vidittyagi118/Ganges_schematic_BOM/CLEANER FILES/SCHEMATICS/Mauricio/9a4c0546-6dc0-4282-add6-17016f0906af.jpg

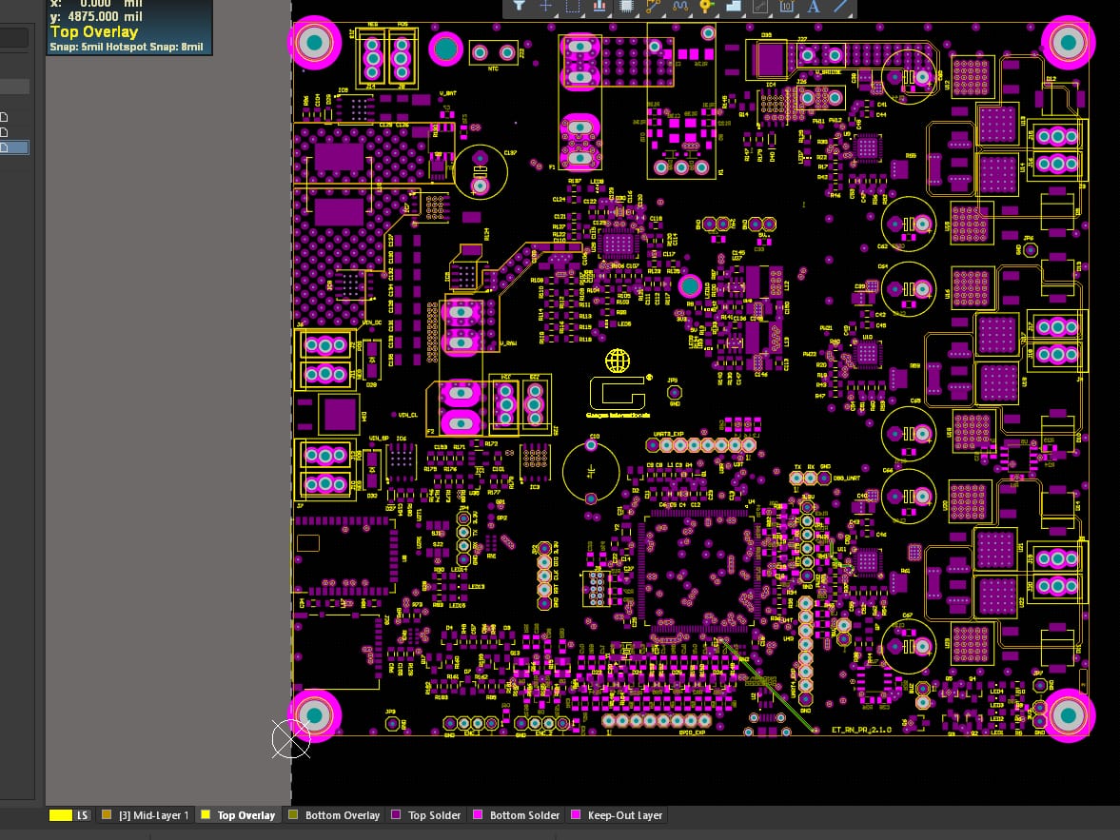
CLEANER FILES/SCHEMATICS/Mauricio/9a4c0546-6dc0-4282-add6-17016f0906af.jpg
