vidittyagi118/Ganges_schematic_BOM/CLEANER FILES/SCHEMATICS/Mauricio/b7af23a4-b5ae-4575-a90f-6ab39772d037.jpg

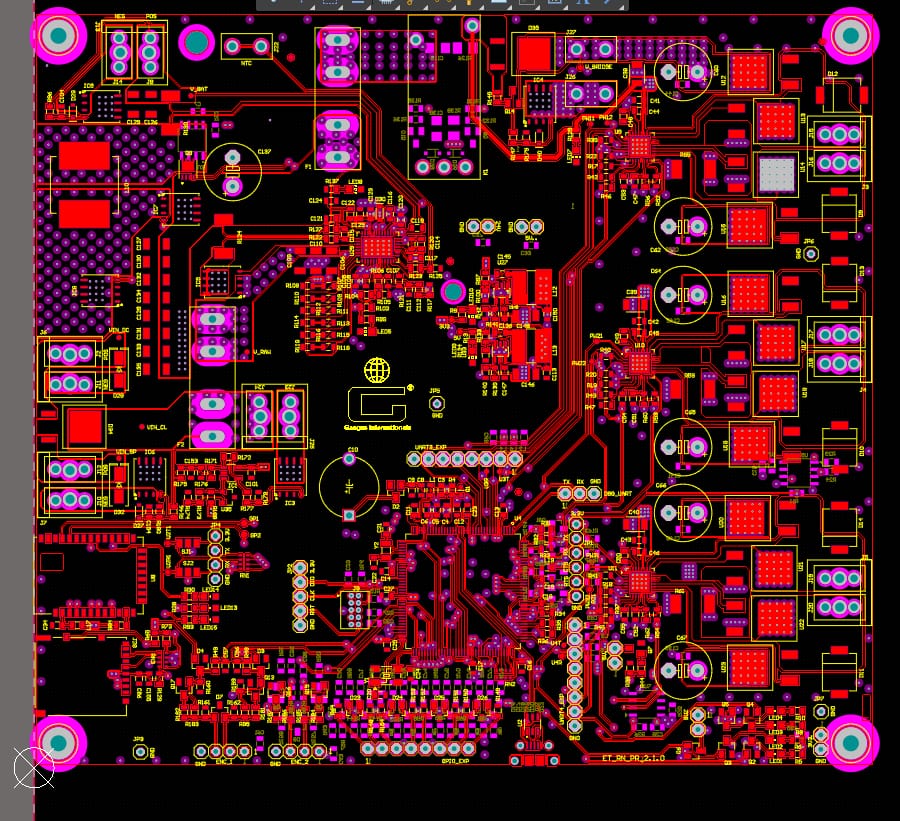
CLEANER FILES/SCHEMATICS/Mauricio/b7af23a4-b5ae-4575-a90f-6ab39772d037.jpg
