vidittyagi118/Ganges_schematic_BOM/HEX_08.06.2023 (1)/HEX_08.06.2023/README.txt

HEX_G3_TCSC_08.06.2023  ---Phase3 solar cleaner & track changer File
HEX_G3_TCSC_CNV_08.06.2023 ---Phase 3 cleaner to TC converted file
HEX_G4_SC_GMD_08.06.2023  ---Phase 4 Cleaner Green motor driver file
HEX_G4_SC_RMD_08.06.2023  ---Phase 4 Cleaner red motor driver file
HEX_G4_TC_08.06.2023      Phase 4 track changer file
