vidittyagi118/Ganges_schematic_BOM/child board/Dashboard.pdf

Distance

3

2

1

0

## RBT 1

## RBT 6

## RBT 8

## RBT 5

RBT 2 | RBT 3

## RBT 7

## RBT 4

## RBT 9

## Admin Dashboard

RTC Time | Actual time

Tingri

Dhule

Site Name

Site Name

Motor Current
LT Motor 1
LT Motor 2
Brush Motor
Current Running at | Min value | Max Value

## Number of RBT Run

14 Successfully Run | 6 remaining

RBT 1 | 67%
RTC Time | Actual time

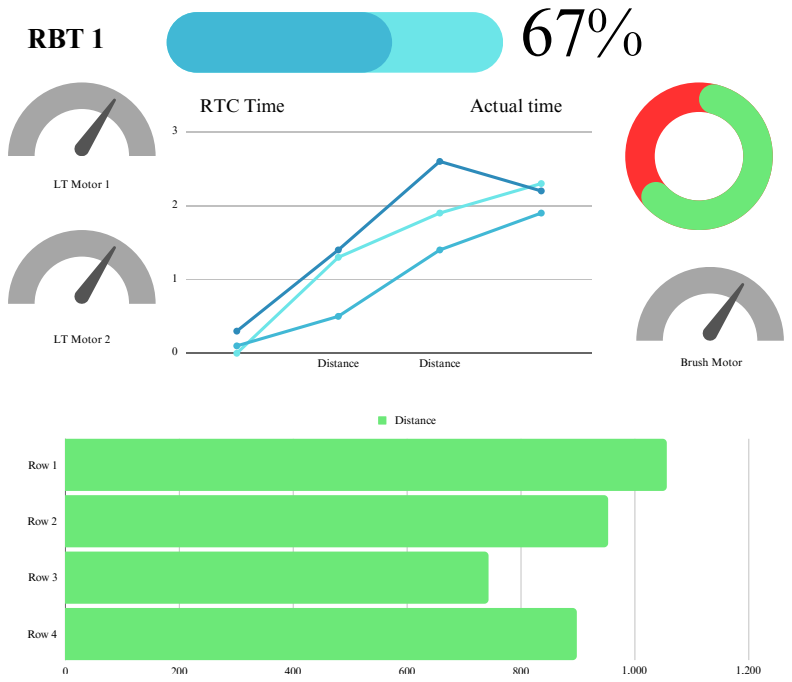
[picture p3: page 2]
LT Motor 1; LT Motor 2; Brush Motor; Distance; Row 1; Row 2; Row 3; Row 4

Mobile View

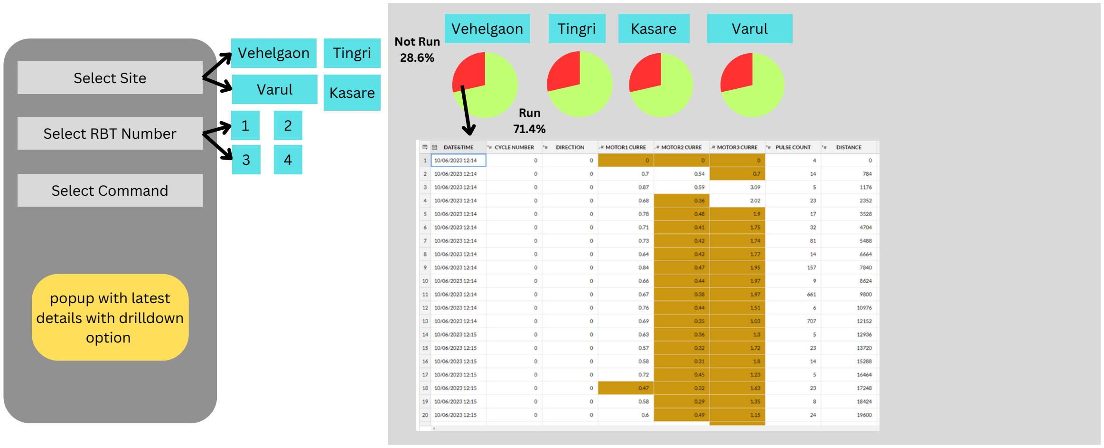
[picture p4: figure]
Select Site; Varul; Tingri; Kasare; Vehelgaon; Select RBT Number; Select Command; popup with latest details with drilldown option; Run 71.4%; Not Run 28.6%
