vidittyagi118/Ganges_schematic_BOM/Motor driver and current sensor - connections (1).pdf

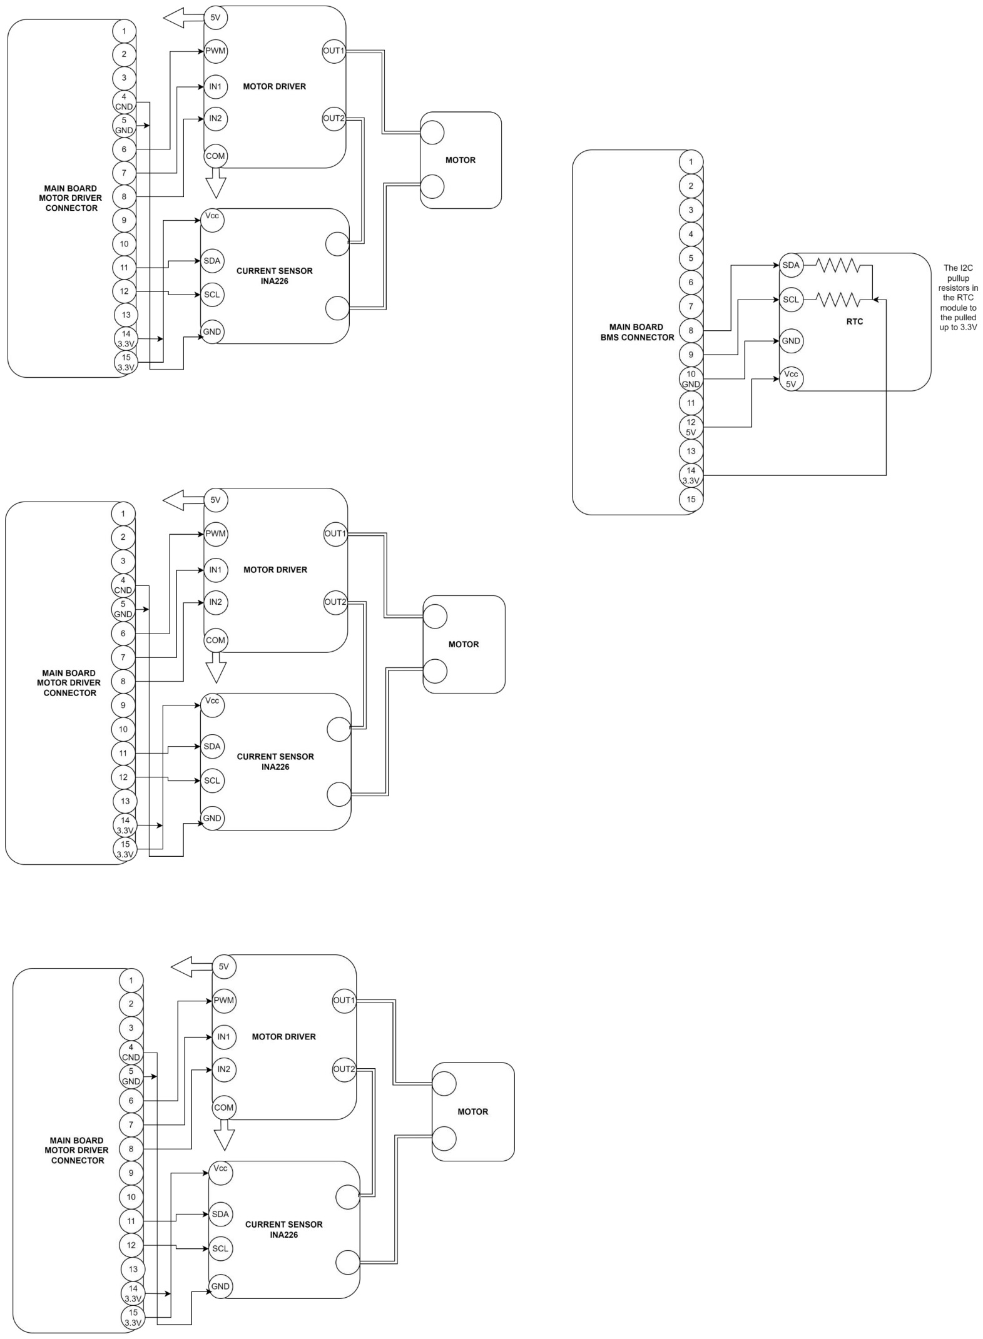
[picture p33: page 1]
