vidittyagi118/Ganges_schematic_BOM/pi.pdf

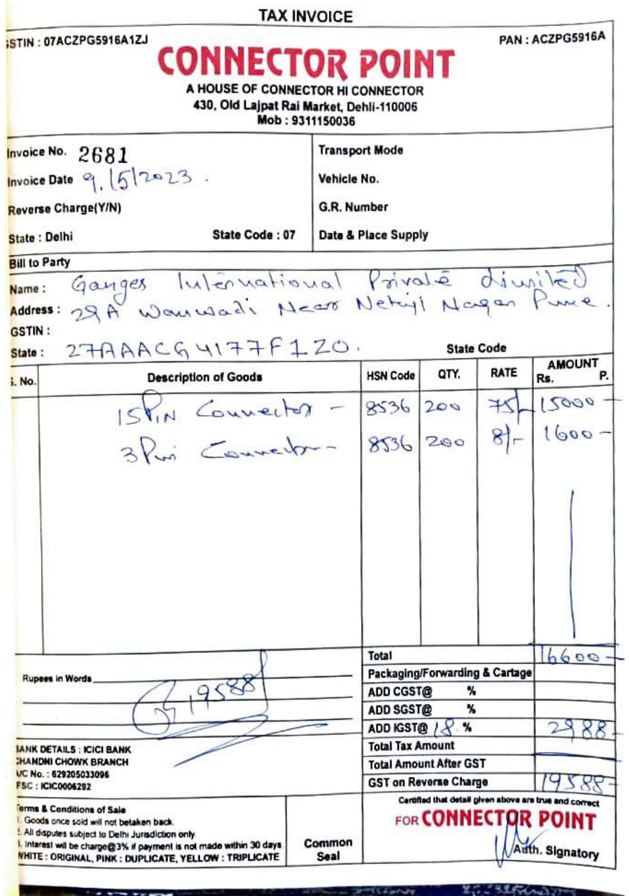
[picture p34: page 1]
