vidittyagi118/Ganges_schematic_BOM/CLEANER FILES/SCHEMATICS/Mauricio/39d270a1-28ed-41b4-96c7-10a538070abb.jpg

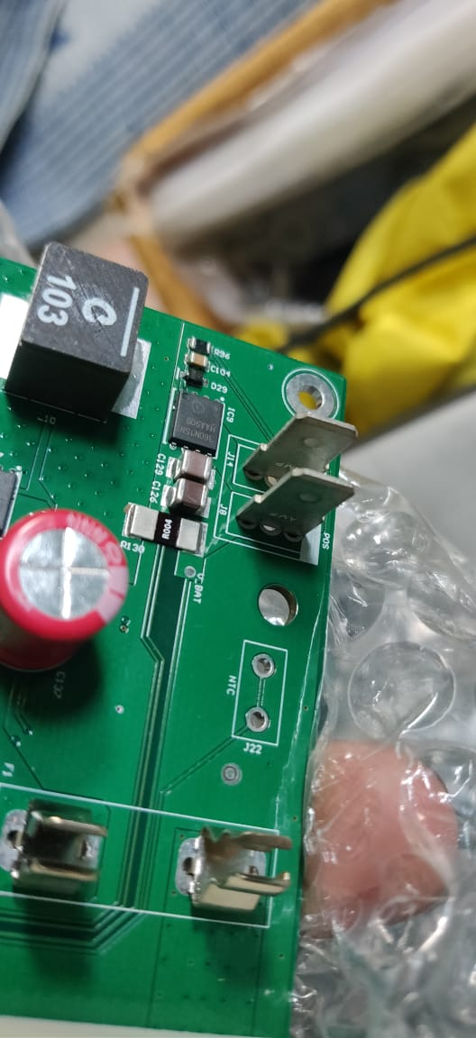
CLEANER FILES/SCHEMATICS/Mauricio/39d270a1-28ed-41b4-96c7-10a538070abb.jpg
