vidittyagi118/Ganges_schematic_BOM/CLEANER FILES/SCHEMATICS/Mauricio/929b0294-b892-416f-9735-e577233a44dc.jpg

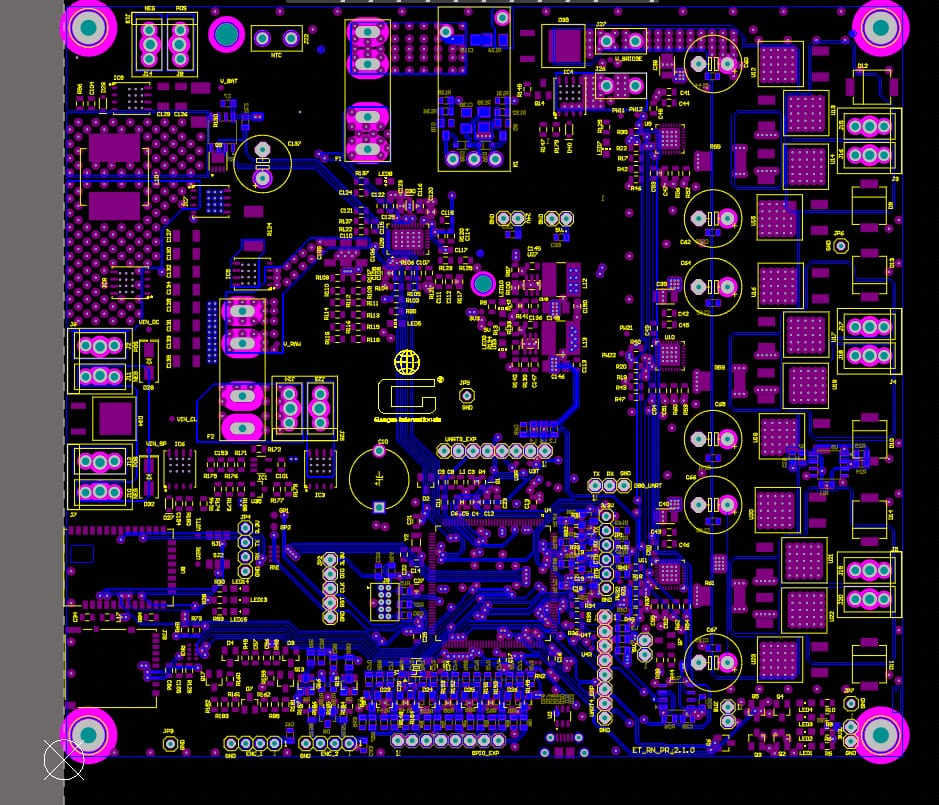
CLEANER FILES/SCHEMATICS/Mauricio/929b0294-b892-416f-9735-e577233a44dc.jpg
