vidittyagi118/Ganges_schematic_BOM/CLEANER FILES/SCHEMATICS/Mauricio/6096d0ab-282d-4cd0-bb16-c4c4bb90c3ef.jpg

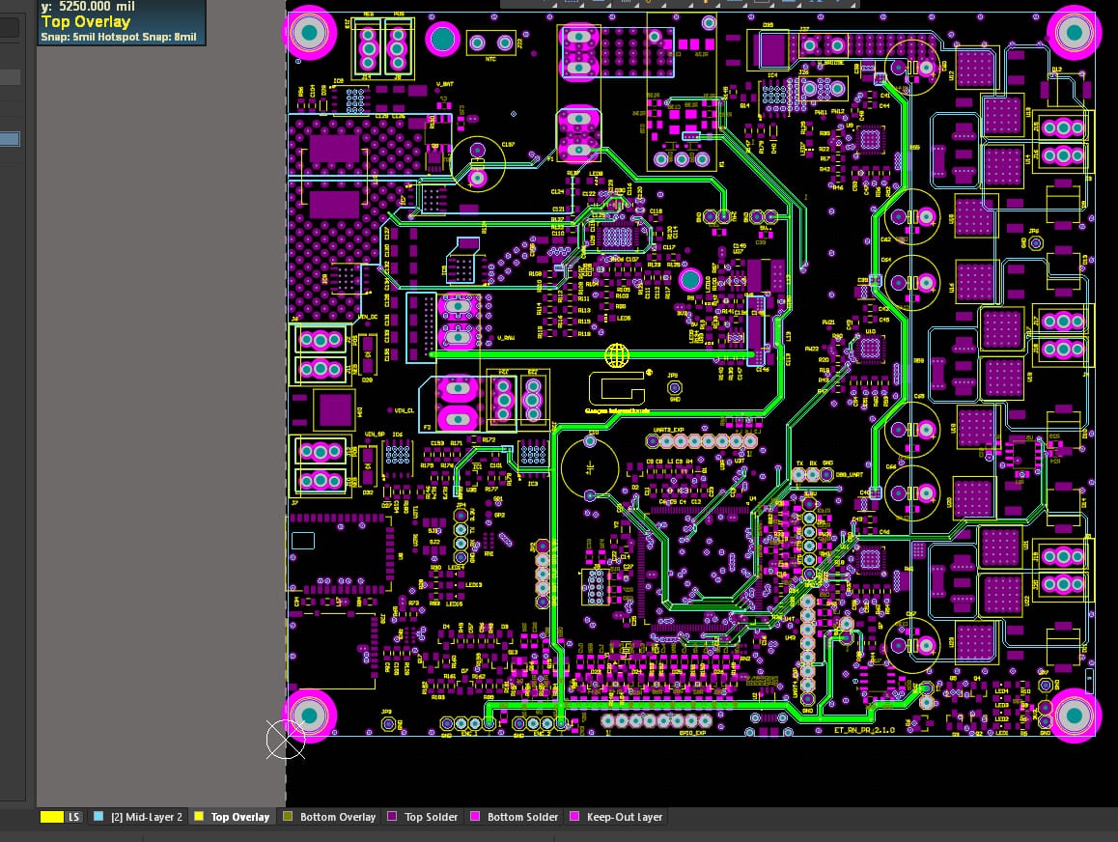
CLEANER FILES/SCHEMATICS/Mauricio/6096d0ab-282d-4cd0-bb16-c4c4bb90c3ef.jpg
