vidittyagi118/Ganges_schematic_BOM/CLEANER FILES/SCHEMATICS/Mauricio/92120a25-4651-43e5-99e7-13c493c2579b.jpg

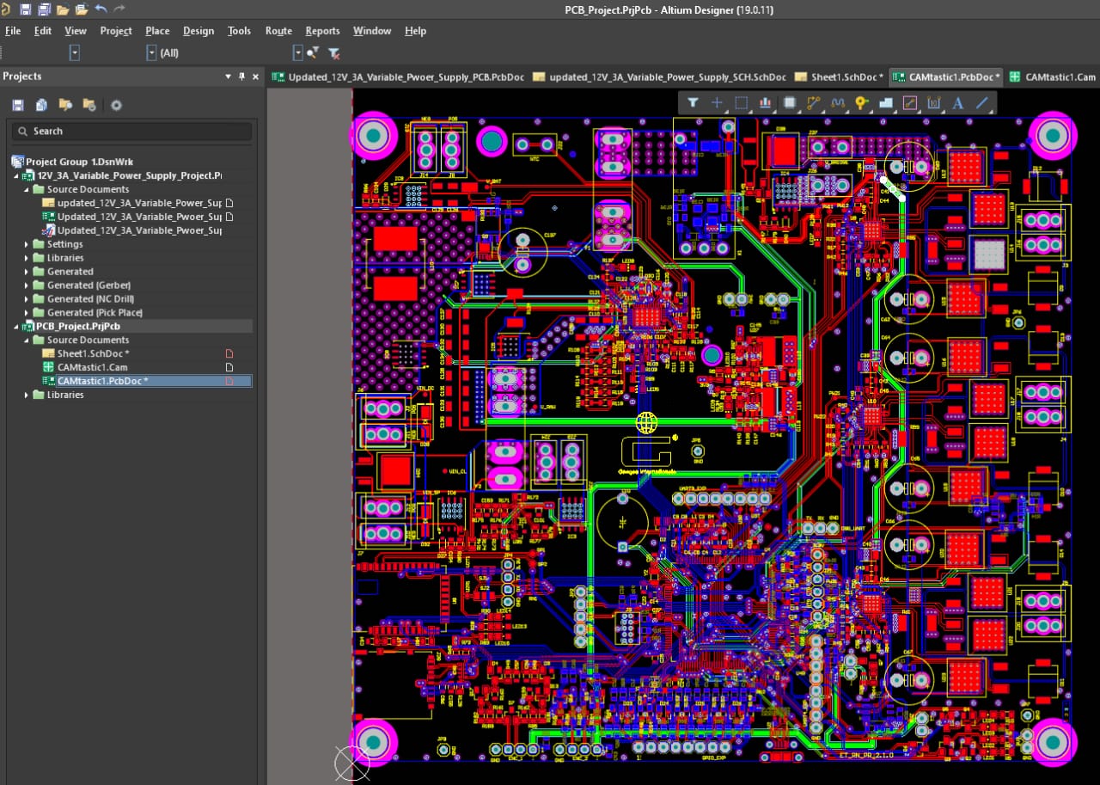
CLEANER FILES/SCHEMATICS/Mauricio/92120a25-4651-43e5-99e7-13c493c2579b.jpg
