vidittyagi118/Ganges_schematic_BOM/WhatsApp Image 2023-09-27 at 11.44.15 AM.jpeg

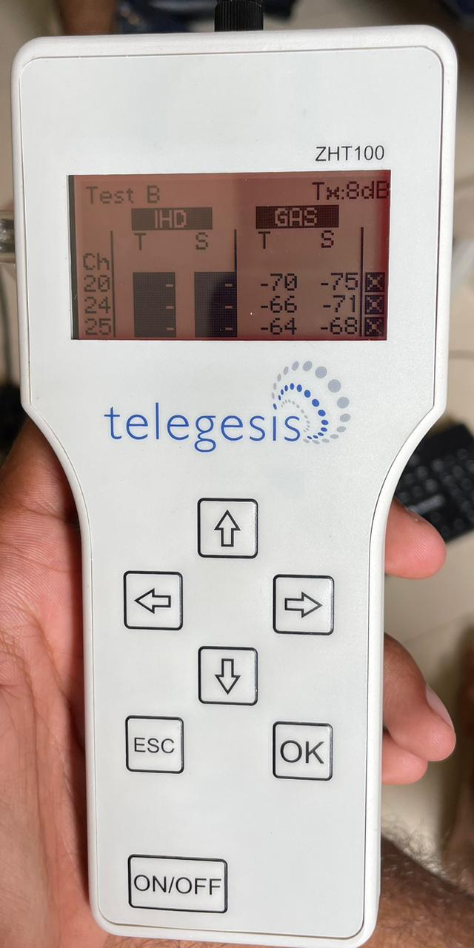
WhatsApp Image 2023-09-27 at 11.44.15 AM.jpeg
