vidittyagi118/Ganges_schematic_BOM/BOM_GANGES 2 POWER SECTION_2023-07-04.csv

ID | Name | Designator | Footprint | Quantity | Manufacturer Part | Manufacturer | Supplier | Supplier Part | Price
1 | 470pF | C1 | C0805 | 1 | C2012C0G1H471JT000N | TDK | LCSC | C76630 | 0.027
2 | 100uF | C2 | CAP-SMD_BD6.3-L6.6-W6.6-LS7.4-FD | 1 | XT100UF16V90RV0061 | KNSCHA(科尼盛) | LCSC | C2992593 | 0.036
3 | 220uF | C3 | CAP-SMD_BD6.3-L6.6-W6.6-FD-2 | 1 | RX220UF16V90RV0106 | KNSCHA(科尼盛) | LCSC | C3445239 | 0.078
4 | 10uF | C4,C5 | CASE-A_3216 | 2 | CA45B-A-16V-10uF-K | CEC(振华新云) | LCSC | C136813 | 0.058
5 | 22uH | L1 | IND-SMD_L4.0-W4.0_LQH44PN2R2MP0L | 1 | SMNR4020-22UH | SXN(顺翔诺) | LCSC | C135264 | 0.067
6 | LED-Red(0805) | LED2 | LED-0805 | 1 | 17-21SURC/S530-A2/TR8 | Everlight Elec | LCSC | C131244 | 0.02
7 | 1N5819/S | NO1 | SMA_L4.3-W2.6-LS5.2-R-RD | 1 | 1N5819/S |  | LCSC | C9900003833
8 | 2K | R1 | R0805 | 1 | RC0805JR-072KL | YAGEO(国巨) | LCSC | C114748 | 0.002
9 | 6.8kΩ | R2 | R0805 | 1 | RMC08056.8K5%N | Tyohm(幸亚电阻) | LCSC | C325848 | 0.004
10 | 300mΩ | R3 | RES-SMD_L6.4-W3.2 | 1 | WW25WR300JTL | Walsin(华新科) | LCSC | C172339 | 0.044
11 | 10k | R9 | AXIAL-0.3 | 1 | ?
12 | MC34063A | U3 | SOIC-8_L4.9-W3.9-P1.27-LS6.0-BL | 1 | MC34063A | Slkor(萨科微) | LCSC | C5330394 | 0.113
13 | AMS1117-3.3_C2992570 | U4 | SOT-223-3_L6.4-W3.5-P2.30-LS7.0-BR | 1 | AMS1117-3.3 | 国芯佳品 | LCSC | C2992570 | 0.041
