vidittyagi118/Ganges_schematic_BOM/BOM_Ganges PCB design_2023-07-04.csv

ID | Name | Designator | Footprint | Quantity | Manufacturer Part | Manufacturer | Supplier | Supplier Part | Price
1 | 0.1uF/16V | C1 | C0603 | 1
2 | 0.1uF | C2 | C0603 | 1
3 | 2.2uF | C3,C9 | C0603 | 2
4 | 10uF | C4,C5 | CASE-A_3216 | 2 | CA45B-A-16V-10uF-K | CEC(振华新云) | LCSC | C136813 | 0.058
5 | 100uF | C6,C7 | CASE-A_3216 | 2
6 | 10nF/16V | C8,C13 | C0603 | 2
7 | 10uF | C10 | C0603 | 1
8 | 47uF | C11,C12 | C0603 | 2
9 | B370-13-F | D1 | SMC_L6.9-W5.9-LS7.9-RD | 1 | B370-13-F | DIODES | LCSC | C134456 | 0.364
10 | B340B-13-F | D2 | SMB_L4.6-W3.6-LS5.3-RD | 1 | B340B-13-F | DIODES | LCSC | C85099 | 0.095
11 | MF-RX110 | F1 | FUSE-TH_L13.5-W3.0-P5.08-D1.0-S1.2 | 1 | MF-RX110 | BOURNS | LCSC | C208495 | 0.311
12 | 8.2uH | L1 | IND-SMD_L7.3-W6.8_ASPI-7318 | 1 | ASPI-7318-8R2M-T | Abracon LLC | LCSC | C187372 | 0.996
13 | LED-0603_R | LED1 | LED0603_RED | 1 | 19-217/R6C-AL1M2VY/3T | EVERLIGHT(台湾亿光) | LCSC | C72044 | 0.016
14 | LED-Red(0805) | LED2 | LED-0805 | 1 | 17-21SURC/S530-A2/TR8 | Everlight Elec | LCSC | C131244 | 0.02
15 | 49K9 | R1 | R0603 | 1
16 | 100K | R2 | R0603 | 1
17 | 17K8 | R3 | R0603 | 1
18 | 3K3 | R4 | R0603 | 1
19 | 10k | R9 | AXIAL-0.3 | 1 | ?
20 | 0 | U1,U5 | TEST-RING | 2 | 1625854-2 | TE Connectivity(美国泰科) | LCSC | C306063 | 0.252
21 | POGO_Pin | U2,U6,U10 | HDR-TH_2P-P2.54-V-M | 3 | 54102-T30-00 | Amphenol | LCSC | C213462 | 0.019
22 | LDP01-35AY | U3 | D2PAK_L10.2-W9.0-P5.08-LS16.9-BR | 1 | LDP01-39AY | ST(意法半导体) | LCSC | C1973035 | 4.83
23 | AMS1117-3.3_C2992570 | U4 | SOT-223-3_L6.4-W3.5-P2.30-LS7.0-BR | 1 | AMS1117-3.3 | 国芯佳品 | LCSC | C2992570 | 0.041
24 | DS3231M+ | U7 | SOIC-16_L10.3-W7.5-P1.27-LS10.3-BL | 1 | DS3231M+ | ADI(亚德诺)/MAXIM(美信) | LCSC | C1520508 | 3.514
25 | AT24C32AN-10SI-1.8 | U8,U9 | SOP-8_L4.9-W3.9-P1.27-LS6.0-BL-1 | 2 | AT24C32AN-10SI-1.8 | null | LCSC | C3202935
