vidittyagi118/Ganges_schematic_BOM/GANG-TRACK CHANGER_BOM_ 20.7.2020.xlsx

Sheet: Sheet2
Qty | Value | Package | Parts | Description | Manufacturer | Manufacturer Part Number
1 | Manual Switch | 1X02 | JP10 | PIN HEADER | Connfly | DS1070-2MVV6
1 | RFID | 1X06 | JP5 | PIN HEADER | Connfly | DS1070-4MVV6
14 | 0.001uF | 0805 | C56, C57, C58, C59, C70, C71, C72, C73, C74, C75, C76, C77, C115, C118 | MLCC, 0805, 50V, 10% | AVX | 08055C102KAT4A
4 | 0.01uF/50V | 0805 | C104, C7, C8, C111 | MLCC, 0805, 50V, 10% | AVX | 08055C103KAT2A
40 | 0.1uF / 50V | 0805 | C4, C5, C6, C38, C39, C45, C46, C1, C2, C9, C15, C40, C42, C48, C101, C136, C145, C147, C149, C153, C11, C12, C13, C16, C17, C18, C19, C23, C25, C27, C29, C30, C37, C50, C61, C63, C108, C114, C123, C124 | MLCC, 0805, 50V, 10% | Walsin | 0805B104K500CT
1 | 0.22uF/50V | 0805 | C112 | MLCC, 0805, 50V, 10% | Taiyo Yuden | UMK212B7224KG-T
2 | 0.33uF/50V | 0805 | C122, C117 | MLCC, 0805, 50V, 20% | Vishay | VJ0805V334MXACW1BC
3 | 0.47uF | 0805 | C83, C88, C116 | MLCC, 0805, 50V, 20% | Yageo | CC0805ZRY5V9BB474
6 | 0R | 0805 | R108, R109, R112, R119, R122, R127 | Thick Film Resistor, 0805, 1% | Yageo | RC0805FR-070RL
4 | 100K | 0805 | R178, R20, R139, R141 | Thick Film Resistor, 0805, 1% | Vishay | CRCW0805100KFKEA
14 | 100R | 0805 | R48, R49, R50, R51, R58, R66, R67, R68, R69, R70, R71, R72, R164, R166 | Thick Film Resistor, 0805, 1% | Walsin | WR08X1000FTL
1 | 100pF/50V | 0805 | C107 | MLCC, 0805, 50V, 5% | Vishay | VJ0805A101JXAAC
10 | 10K | 0805 | R37, R39, R40, R15, R16, R19, R27, R106, R123, R125 | Thick Film Resistor, 0805, 1% | Yageo | RC0805FR-0710KL
2 | 10M | 0805 | R96, R146 | Thick Film Resistor, 0805, 1% | Yageo | RC0805FR-0710ML
7 | 10uF / 16V | 0805 | C43, C47, C49, C105, C125, C14, C34 | MLCC, 0805, 16V, 10% | Taiyo Yuden | EMK212ABJ106KG-T
17 | 10uF / 50V | 1210 | C41, C106, C109, C110, C126, C127, C128, C129, C130, C131, C132, C133, C134, C135, C146, C148, C44 | MLCC, 1210, 50V, 10% | Murata | GRM32ER71H106KA12L
1 | 110K | 0805 | R18 | Thick Film Resistor, 0805, 1% | Yageo | RC0805FR-07110KL
1 | 120uF/50V | E5-10,5 | C137 | Aluminium Electrolytic Capacitor, 50V | Wurth | 860020675017
2 | 12pF | 0805 | C21, C22 | MLCC, 0805, 50V, 5% | Walsin | 0805N120J500CT
2 | 15V | SOD-323 | D27, D29 | Zener Diode, 15V, 300mW | Nexperia | BZX384-B15,115
2 | 18pF | 0805 | C20, C24 | MLCC, 0805, 50V, 5% | Walsin | 0805N180J500CT
28 | 1K | 0805 | R5, R6, R7, R8, R10, R11, R21, R22, R28, R30, R57, R74, R75, R76, R79, R80, R83, R95, R155, R156, R163, R165, R171, R177, R183, R9, R13, R17 | Thick Film Resistor, 0805, 1% | Yageo | RC0805FR-071KL
1 | 1N4148 | SOD-323 | D30 | Diode, 150mA, 100V | Diodes Inc. | 1N4148WS-7-F
1 | 1uF/50V | 0805 | C121 | MLCC, 0805, 50V, 10% | AVX | 08055C105KAT2A
1 | 2.2M | 0805 | R180 | Thick Film Resistor, 0805, 1% | Panasonic | ERJ-6ENF2204V
2 | 2.2uF/25V | 0805 | C154, C120 | MLCC, 0805, 50V, 10% | Murata | GRM219R61H225ME15D
1 | 200R | 0805 | R117 | Thick Film Resistor, 0805, 1% | Yageo | RC0805FR-07200RL
2 | 22.1K | 0805 | R100, R134 | Thick Film Resistor, 0805, 1% | Yageo | RC0805FR-0722K1L
1 | 226K | 0805 | R103 | Thick Film Resistor, 0805, 1% | Yageo | RC0805FR-07226KL
2 | 22uF | 0805 | C113, C150 | MLCC, 0805, 6.3V, 20% | CCTC | TCC0805X5R226M6R3FT
1 | 301K/0.1% | 0805 | R120 | Thick Film Resistor, 0805, 0.1% | Yageo | AT0805BRD07301KL
1 | 32.768KHz | CRYSTAL-32768_TF32 | Y2 | Crystal, 32.768 KHz | Epson | Q13FC1350000400
2 | 33K | 0805 | R99, R137 | Thick Film Resistor, 1206, 1% | Yageo | RC0805FR-0733KL
7 | 4.7K | 0805 | R12, R23, R24, R34, R35, R36, R176 | Thick Film Resistor, 0805, 1% | Vishay | CRCW08054K70FKEAC
1 | 43K | 0805 | R175 | Thick Film Resistor, 0805, 1% | Yageo | RC0805JR-0743KL
2 | 470R | 0805 | R161, R162 | Thick Film Resistor, 0805, 1% | Vishay | CRCW0805470RFKEAC
2 | 47E | 0805 | R184, R187 | Thick Film Resistor, 0805, 1% | Yageo | RC0805FR-0747RL
2 | 47R | 0603-ARV | RN1, RN3 | Resistor Array, 5% | Yageo | TC164-JR-0747RL
2 | 4mOhms | ERJMP4 | R124, R130 | Current Sense Resistor, 2W, 1% | Yageo | PA2512FKF7W0R004E
1 | 51K | 0805 | R97 | Thick Film Resistor, 0805, 1% | Yageo | RC0805FR-0751KL
11 | 62409-1 | TE_62409-1 | J2, J4, J5, J8, J10, J11, J12, J14, J22, J23, J24 | Faston Connectors | TE Connectivity | 62409-1
2 | 64.9K | 0805 | R104, R105 | Thick Film Resistor, 0805, 1% | Yageo | RC0805FR-0764K9L
2 | 88.7K | 0805 | R172, R133 | Thick Film Resistor, 0805, 1% | Yageo | RC0805FR-0788K7
1 | 8MHz | 5mmx3.2mm | Y1 | Crystal, 8MHz | Abracon | ABM3B-8.000MHZ-B2-T
1 | 95.3K | 0805 | R121 | Thick Film Resistor, 0805, 1% | Yageo | RC0805FR-0795K3L
1 | BAS40 | SOT23 | D2 | Schottky Diode, 40V, 0.12A | Infineon | BAS4004E6327HTSA1
14 | BAT54S | SOT23 | D3, D4, D5, D6, D15, D16, D17, D18, D19, D20, D21, D22, D31, D33 | Schottky Diode, 30V | Nexperia | BAT54S,215
1 | Drive Enable | 1X02 | BUZ1 | PIN HEADER | Connfly | DS1070-2MVV6
1 | EEC-S0HD224HN | RG_105X50_V | C10 | Super Capacitor | Panasonic | EEC-RG0V224H
1 | Encoder | 1X04 | ENC_1 | PIN HEADER | Connfly | DS1070-4MVV6
4 | FB | 0805 | L17, L1, L19, L20 | Ferrite Bead | TAIYO Yuden | BK2125HS601-T
1 | FUSE_CLIP | FUSE_CLIP | F2 | Fuse clip | Xucheng Elec | C3130
6 | JMTK50N06A | TO-252-3 | U28, U30, U25, U26, U31, U32 | N-Channel FET | Jie Jie Micro | JMTK50N06A
1 | JTAG-10PIN | JTAG | J9 | JTAG | Samtec | FTSH-105-01-F-D-K
1 | LMV321A | SOT23-5 | IC1 | OP-AMP | Texas Instruments | LMV321IDBVR
1 | LP2980-N / EQU | TSOP-5 | U11 | fixed-output voltage regulator | Texas Instruments | LP2980-N
1 | LTC4015EUHFPBF | QFN-38_UHF | U29 | Battery charge controller | Linear Technology | LTC4015EUHF#PBF
1 | Limit Switch | 1X03 | JP6 | PIN HEADER | Connfly | DS1070-3MVV6
1 | MBRD20100CT | DPAK-3 | D34 | Schottky Diode, 100V, 10A | Diodes Inc. | MBRD20100CT-13
1 | MF-MSMF110/16 | 1812 | F1 | PTC Fuse | BOURNS | MF-MSMF110/16
1 | MK22FN1M0AVLQ12 | 144-LQFP | U4 | Micro Controller | NXP | MK22FN1M0AVLQ12
10 | PDTC114 | SC59-BEC | Q2, Q3, Q4, Q5, Q8, Q15, Q16 | NPN Transistor | Nexperia | PDTC114,ET
1 | Proximity | 1X04 | JP8 | PIN HEADER | Connfly | DS1070-4MVV6
13 | RED | 0805 | LED1, LED2, LED3, LED4, LED13, LED14, LED15, LED7, LED5, LED6, LED8, LED9, LED10 | LED | Everlight | 17-21SURC/S530-A2/TR8
1 | SQD40131EL_GE3 | TO-252-3 | Q9 | P-Channel FET, 40V, 50A | Vishay | SQD40131EL_GE3
3 | SRN6045-150M | SRN6045 | L12, L13, L18 | Fixed Inductors, 15uH, 20% | BOURNS | SRN6045-150M
1 | SRP1265A-100M | SRP1265A | L10 | Fixed Inductors, 10uH, 20% | Bourns | XAL1010-103MEB
1 | SSB44HE3_A/I | SMB | D11 | Reverse diode | Vishay | SSB44HE3_A/I
1 | ST-TF-003A | SUNTECH_ST-TF-003A | P1 | Micro SD Card Socket | Suntech | ST-TF-003A
1 | Stepper Motor | 1X03 | JP7 | PIN HEADER | Connfly | DS1070-3MVV6
1 | 33K | 0805 | R42 | Resistor
1 | 88.7K |  | R43 | Resistor
1 | TL431ACDBZR | SOT23-3 | U5 | TL431- Voltage Reference | Texas Instruments | TL431ACDBZR
1 | TMP75AIDR | SOIC | U3 | Temperature Sensor | Texas Instruments | TMP75AIDR
3 | TPS560430X | SOT23-6 | U10, U27, U33 | DC-DC Converter | Texas Instruments | TPS560430XFDBVT
1 | TRS3232_TSSOP | TSSOP-PW16 | U9 | RS232 Transceiver | Texas Instruments | TRS3232CDWR
1 | Debug UART | 1X03 | DBG_UART | PIN HEADER | Connfly | DS1070-3MVV6
1 | Proximity Power | 1X02 | 24V | PIN HEADER | Connfly | DS1070-2MVV6
1 | XB3-24Z8UM | XCVR_XB3-24Z8UM-J | U8 | XBee3, 2.4 GHz ZB 3.0, U.FL Ant, MMT | Digi | XB3-24Z8UM
1 | Zigbee Stick | 1X04 | JP12 | PIN HEADER | Connfly | DS1070-4MVV6

Sheet: Sheet3
qty | Location | Part No | Description | Remarks
2 | R58,R57 |  | Resistance | Remove from R160 & R159 (same location)
2 | R37,R39 |  | Resistance | Remove from TC board R163 & R165 & solder it in this
