vidittyagi118/Ganges_schematic_BOM/Gerber_NC files for MCU Module V1.1/MCU module BOM.xls

PCBWay Bom Quotation, Product No.:T-1D10W424020A
Item # | *Designator | *Qty | Manufacturer | *Mfg Part # | Description / Value | Vendor Part # | *Package/Footprint | Mounting Type | *Unit Price(50 sets) | *Total | *Delivery Time | *Actual Purchase Mfg Part # | *PCBWay Note | Customer Reply | PCBWay Update
1 | C201 | 1 | Samsung | CL21A106KPFNNNG | CAP CER 10UF 6.3V X5R 0805 | Digi-Key『 』1276-6456-2-ND | 0805 (2012 Metric) | Surface Mount, MLCC | $0.108 | $5.400 |  |  | 10V
2 | C202, C203, C205, C206, C209, C211, C213, C214, C215 | 9 | Samsung | CL21B104KBCNNNC | CAP CER 0.1UF 50V X7R 0805 | Digi-Key『 』1276-1003-1-ND | 0805 (2012 Metric) | Surface Mount, MLCC | $0.004 | $1.800
3 | C204 | 1 | Samsung | CL21A475KQFNNNE | CAP CER 4.7UF 10V X5R 0805 | Digi-Key『 』1276-1198-1-ND | 0805 (2012 Metric) | Surface Mount, MLCC | $0.121 | $6.050 |  |  | 6.3V
4 | C207 | 1 | Kyocera AVX | TAJA225K010TNJ | Capacitor Tantalum 10V 2.2uF 10% ESR = 6 ohm | Digi-Key『 』478-11226-1-ND | 1206 (3216 Metric) | Surface Mount | $0.302 | $15.100
5 | C212 | 1 | Wurth Electronics | 885012007076 | CAP CER 10PF 100V C0G/NP0 0805 | Digi-Key『 』732-12223-1-ND | 0805 (2012 Metric) | Surface Mount, MLCC | $0.118 | $5.900
6 | C216, C217, C218, C220 | 4 | Stackpole Electronics | CML0805C0G120JT50V | CAP CER 12PF 50V C0G/NP0 0805 | Digi-Key『 』738-CML0805C0G120JT50VCT-ND | 0805 (2012 Metric) | Surface Mount, MLCC | $0.060 | $12.000
7 | C219 | 1 | Wurth Electronics | 885012207092 | CAP CER 10000PF 50V X7R 0805 | Digi-Key『 』732-8021-1-ND | 0805 (2012 Metric) | Surface Mount, MLCC | $0.118 | $5.900
8 | J200, J201, J202, J203 | 4 | TE Connectivity AMP | 1-2842138-0 | 20P,2MM,BRK HDR,DRVT,2.8,0.1AU,B | Digi-Key『 』17-1-2842138-0-ND |  | Through Hole |  |  |  |  | [DNP不要贴];
9 | J200, J201, J202, J203 | 4 | TE Connectivity AMP | 2842139-5 | 10P,2MM,BRK HDR,DRVT,2.8,0.38AU | Digi-Key『 』17-2842139-5-ND |  | Through Hole |  |  |  |  | [DNP不要贴];
10 | J204 | 1 | Adam Tech | PH1-03-UA | CONN HEADER VERT 3POS 2.54MM | Digi-Key『 』2057-PH1-03-UA-ND |  | Through Hole | $0.150 | $7.500
11 | J205 | 1 | Adam Tech | PH1-05-UA | CONN HEADER VERT 5POS 2.54MM | Digi-Key『 』2057-PH1-05-UA-ND |  | Through Hole | $0.156 | $7.800
12 | L200 | 1 | Taiyo Yuden | LB1608T100M | FIXED IND 10UH 60MA 700 MOHM SMD | Digi-Key『 』587-2243-1-ND | 0603 (1608 Metric) | Surface Mount | $0.173 | $8.650
13 | L201, L202, L203 | 3 | Murata | BLM18AG471SN1D | FERRITE BEAD 470 OHM 0603 1LN | Digi-Key『 』490-1013-1-ND | 0603 (1608 Metric) | Surface Mount | $0.015 | $2.250
14 | R200 | 1 | Stackpole Electronics | RMCF0805ZT0R00 | RES 0 Ω JUMPER 1/8W 0805 | Digi-Key『 』RMCF0805ZT0R00CT-ND | 0805 (2012 Metric) |  | $0.009 | $0.450
15 | R202 | 1 | Stackpole Electronics | RMCF0805JT2R20 | RES 2.2 OHM 5% 1/8W 0805 | Digi-Key『 』RMCF0805JT2R20CT-ND | 0805 (2012 Metric) |  | $0.037 | $1.850
16 | R203 | 1 | Stackpole Electronics | RMCF0805FT5K62 | RES 5.62K OHM 1% 1/8W 0805 | Digi-Key『 』RMCF0805FT5K62CT-ND | 0805 (2012 Metric) |  | $0.037 | $1.850
17 | R204 | 1 | Stackpole Electronics | RMCF0805FT1K00 | RES 1K Ω 1% 1/8W 0805 | Digi-Key『 』RMCF0805FT1K00CT-ND | 0805 (2012 Metric) |  | $0.037 | $1.850
18 | R205, R207 | 2 | Stackpole Electronics | RMCF0805JT10K0 | RES 10K Ω 5% 1/8W 0805 | Digi-Key『 』RMCF0805JT10K0CT-ND | 0805 (2012 Metric) |  | $0.032 | $3.200
19 | R206 | 1 | Stackpole Electronics | RMCF0805JT100K | RES 100K Ω 5% 1/8W 0805 | Digi-Key『 』RMCF0805JT100KCT-ND | 0805 (2012 Metric) |  | $0.037 | $1.850
20 | R208, R209, R210, R211 | 4 | Stackpole Electronics | RMCF0805FT4K70 | RES 4.7K Ω 1% 1/8W 0805 | Digi-Key『 』RMCF0805FT4K70CT-ND | 0805 (2012 Metric) |  | $0.030 | $6.000
21 | U200 | 1 | Microchip | ATSAMS70Q20A-CFNT | 32-bit ARM Cortex-M7 MCUs with FPU, Audio andGraphics Interfaces, High-Speed USB, Ethernet, andAdvanced Analog | Digi-Key『 』ATSAMS70Q20A-CFNTCT-ND | 144-UFBGA | Surface Mount |  |  |  |  | [Supplied by customer客供];
22 | X200 | 1 | ECS International | ECS-120-18-33-JEM-TR | CRYSTAL 12.0000MHZ 18PF SMD | Digi-Key『 』XC2711CT-ND | 4-SMD, No Lead | Surface Mount | $0.510 | $25.500 | 7-10 Workdays
23 | X201 | 1 | Citizen | CMR200T32768EZFT | CRYSTAL 32.7680KHZ 12.5PF SMD | Digi-Key『 』300-8864-1-ND | Cylindrical Can, Radial | Surface Mount | $0.260 | $13.000 |  | AB38T-32.768KHZ | brand: Abracon LLC
 |  |  |  |  |  |  |  |  | Component Cost | $133.900
 |  |  |  |  |  |  |  |  | PCB cost | $291.620
 |  |  |  |  |  |  |  |  | Assembly cost | $456.440
 |  |  |  |  |  |  |  |  | PCBA in total | $881.960
