vidittyagi118/Ganges_schematic_BOM/katyayan Project2 All files/BOM/BOM Main Board v1.1.xlsx

 | Bill of Materials
 |  |  |  |  |  |  | 2175 Salk Avenue
 | Project Title: | Bill of Materials for BOM Document [Main Board V1.1.BomDoc] |  |  |  |  | Suite 200
 | Project File Name: | Main Board V1.1.PrjPCB |  |  |  |  | Carlsbad, CA 92008
 | Assembly Variant: | None |  |  |  |  | USA
Component Name | Description | Designator | Manufacture | Manufacture Part Number | Supplier | Supplier Part Number | Supplier Unit Price | Quantity | Supplier Subtotal
Capacitor | CAP CER 0.1UF 50V X7R 0603 | C4, C28, C61, C63, C68, C69, C78, C155 | Samsung | CL10B104MB8NNNC | Digi-Key | 1276-1941-1-ND | $0.03 | 8 | $0.23
 | CAP CER 10UF 50V X5R 1206 | C34, C86 | Samsung | CL31A106MBHNNNE | Digi-Key | 1276-6736-1-ND | $0.30 | 2 | $0.60
 | CAP CER 1UF 50V X5R 0603 | C1, C2 | Samsung | CL10A105KB8NNNC | Digi-Key | 1276-1860-1-ND | $0.14 | 2 | $0.28
 | CAP CER 0.33UF 50V X7R 0603 | C3 | TDK Corporation | CGA3E3X7R1H334K080AB | Digi-Key | 445-174426-1-ND | $0.22 | 1 | $0.22
 | CAP CER 1000PF 50V X7R 0603 | C56, C57, C58, C59 | Walsin Technologies | 0603B102M500CT | Digi-Key | 1292-1381-1-ND | $0.03 | 4 | $0.11
Diode | DIODE SCHOTTKY 40V 3A DO214AB | D1 | Comchip | SS34B-HF | Digi-Key | 641-SS34B-HFCT-ND | $0.38 | 1 | $0.38
 | TVS Diode (Bi-directional) | D2 | Diodes | SMAJ28A-13-F | Digi-Key | SMAJ28A-FDICT-ND | $0.42 | 1 | $0.42
 | Diode Array 1 Pair Series Connection Schottky 30V 200mA Surface Mount TO-236-3, SC-59, SOT-23-3 | D3, D4, D5, D6, D31, D33 | Pan Jit | BAT54SW_R1_00001 | Digi-Key | 3757-BAT54SW_R1_00001CT-ND | $0.23 | 6 | $1.38
 | Low capacitance unidirectional quadruple ESD protection diode arrays | D7, D8, D9, D10, D11, D12, D13, D14, D42, D43, D44 | ON Semiconductor | MSQA6V1W5T2G | Digi-Key | MSQA6V1W5T2GOSDKR-ND | $0.29 | 11 | $3.22
 | TVS Diode (Bi-directional) | D46, D48, D50 | Bourns | SMLJ5.0CA | Digi-Key | SMLJ5.0CABCT-ND | $1.23 | 3 | $3.69
Connector | CONN QC TAB 0.250 SOLDER | J2, J4 | Molex | 19713-4001 | Digi-Key | WM7391-ND | $0.33 | 2 | $0.66
 | 1x15P 1 1mm 15 Phosphor bronze SMD,P=1mm Wire To Board / Wire To Wire Connector ROHS | J3, J15, J16, J17 | HR(Joint Tech Elec) | A1001WV-S-15P | LCSC | C371595 | $0.79 | 4 | $3.17
 | CONN HEADER VERT 2POS 2.54MM | J51,J52 | Wurth Electronics | 61300211121 | Digi-Key | 732-5315-ND
 | Connector Header Through Hole 6 position 0.100 (2.54mm) | J5 | Molex | 22-23-2041 | Digi-Key | WM4202-ND | $0.33 | 1 | $0.33
 | Connector Header Through Hole 2 position 0.100 (2.54mm) | J6 | Molex | 22-23-2021 | Digi-Key | 900-0022232021-ND | $0.20 | 1 | $0.20
 | Connector Header Through Hole 4 position 0.100 (2.54mm) | J7, J18, J19 | Molex | 22-23-2041 | Digi-Key | WM4202-ND | $0.33 | 3 | $0.99
 | Header, 8-Pin | J8, J20, J21 | Molex | 22-23-2081 | Digi-Key | WM4206-ND | $0.58 | 3 | $1.74
 | CONN MICRO SD CARD PUSH-PUSH R/A | J28 | Hirose Electric Co Ltd | DM3AT-SF-PEJM5 | Digi-Key | HR1964CT-ND | $2.50 | 1 | $2.50
 | CONN HEADER VERT 3POS 2.54MM | J9, J10, J11 | Würth Elektronik | 61300311121 | Digi-Key | 732-5316-ND | $0.13 | 3 | $0.39
 | Header, 17-Pin, Dual row | J30, J31, J32, J33 | Sullins | NPPN172AFCN-RC | Digi-Key | S5750-17-ND | $2.21 | 4 | $8.84
Inductor | BBPY00160808601Y00 | L3, L4, L17 | Bourns | MH1608-601Y | Digi-Key | MH1608-601YCT-ND | $0.10 | 3 | $0.30
LED | LED GREEN CLEAR 0805 SMD | LED1, LED2, LED3, LED4, LED13, LED14, LED15 | Wurth Electronics | 150080VS75000 | Digi-Key | 732-4986-1-ND | $0.18 | 7 | $1.26
 | LED RED CLEAR 0805 SMD | LED6, LED10 | Wurth Electronics | 150080SS75000 | Digi-Key | 732-4985-1-ND | $0.18 | 2 | $0.36
Transistor | TRANS PREBIAS NPN 250MW TO236AB | Q1, Q2, Q3, Q4, Q5, Q8, Q9 | Nexperia | PDTC114ET,215 | Mouser | 771-PDTC114ETT/R | $0.15 | 7 | $1.05
Resistor | RES SMD 2K OHM 5% 1/10W 0603 | R1, R2, R29, R34 | Bourns | CR0603-JW-202ELF | Digi-Key | 118-CR0603-JW-202ELFCT-ND | $0.01 | 4 | $0.06
 | RES 1.2K OHM 5% 1/10W 0603 | R3, R11, R35, R36 | Stackpole Electronics | RMCF0603FT1K20 | Digi-Key | RMCF0603FT1K20CT-ND | $0.02 | 4 | $0.07
 | RES 100 OHM 5% 1/10W 0603 | R4, R7, R12, R15, R17, R18, R22, R23, R24, R31, R33, R37, R42, R43, R45, R47, R53, R54, R163, R164, R165, R166 | Bourns | CR0603-JW-101ELF | Digi-Key | CR0603-JW-101ELFCT-ND | $0.01 | 22 | $0.33
 | RES 1K OHM 5% 1/10W 0603 | R5, R6, R8, R9, R10, R13, R28, R30, R48, R49, R50, R51, R83, R98 | Stackpole Electronics | RMCF0603FT1K00 | Digi-Key | RMCF0603FT1K00CT-ND | $0.02 | 14 | $0.24
 | RES 200K OHM 5% 1/8W 0805 | R14, R16, R27, R32, R46, R52 | Stackpole Electronics | RMCF0805JT200K | Digi-Key | RMCF0805JT200KCT-ND | $0.02 | 6 | $0.12
 | RES 0 OHM JUMPER 1/10W 0603 | R19, R21, R84, R94, R95, R96 | Stackpole Electronics | RMCF0603ZT0R00 | Digi-Key | RMCF0603ZT0R00CT-ND | $0.01 | 6 | $0.08
 | RES 470 OHM 1% 1/10W 0603 | R161, R162 | Walsin Technologies | WR06X470FTL | Digi-Key | 1292-WR06X4703FTLTR-ND |  | 2
 | RES 10K OHM 5% 1/10W 0603 | R25, R26, R60, R61, R62, R65, R73, R86, R128, R157, R158, R161, R162 | Walsin Technologies | WR06X103JTL | Digi-Key | 1292-WR06X103JTLCT-ND | $0.01 | 13 | $0.16
 | RES 330K OHM 5% 1/10W 0603 | R87, R89, R90, R91, R92, R93 | Stackpole Electronics | RMCF0603FT330K | Digi-Key | RMCF0603FT330KCT-ND | $0.02 | 6 | $0.10
 | RES SMD 100K OHM 5% 1/10W 0603 | R101 | Bourns | CR0603-JW-104ELF | Digi-Key | CR0603-JW-104ELFCT-ND | $0.01 | 1 | $0.01
 | RES 88.7K OHM 1% 1/10W 0603 | R133 | Stackpole Electronics | RMCF0603FT88K7 | Digi-Key | 738-RMCF0603FT88K7CT-ND | $0.10 | 1 | $0.10
 | RES ARRAY 4 RES 47 OHM 0804 | RN1, RN3 | Yageo | YC124-JR-0747RL | Mouser | 603-YC124-JR-0747RL | $0.10 | 2 | $0.20
Switch | STANDARD DIP SWITCH, 4 POSITIONS | S1 | CIT Relay & Switch | KG04ET | Digi-Key | 2449-KG04ET-ND | $0.65 | 1 | $0.65
IC | OPTOISOLTR 5KV 4CH TRANS 16-SMD | U1 | Vishay Lite-On | LTV-847S | Digi-Key | 160-1371-5-ND | $1.00 | 1 | $1.00
 | IC FLASH 16MBIT SPI/QUAD 8SOIC | U7 | Microchip | SST26VF016BT-80E/SN | Digi-Key | SST26VF016BT-80E/SNCT-ND | $1.96 | 1 | $1.96
 | RECEPTACLE STRIP 10P 2.0MM PITCH | U8 | Adam Equipment | 2RS1-10-G | Digi-Key | 2057-2RS1-10-G-ND | $0.82 | 1 | $0.82
Approved |  | Notes
