vidittyagi118/Ganges_schematic_BOM/Gerber_PCB_DS3231 RTC Zeno Varient_2022-01-11_PCBWay Community/How-to-order-PCB.txt

How to Order PCB

Please refer to:
https://docs.easyeda.com/en/PCB/Order-PCB
