vidittyagi118/Ganges_schematic_BOM/Ganges_SCH child board/PC-1161 GANGES CURRENT MEASUREM.pdf

# MOTOR C SECTION

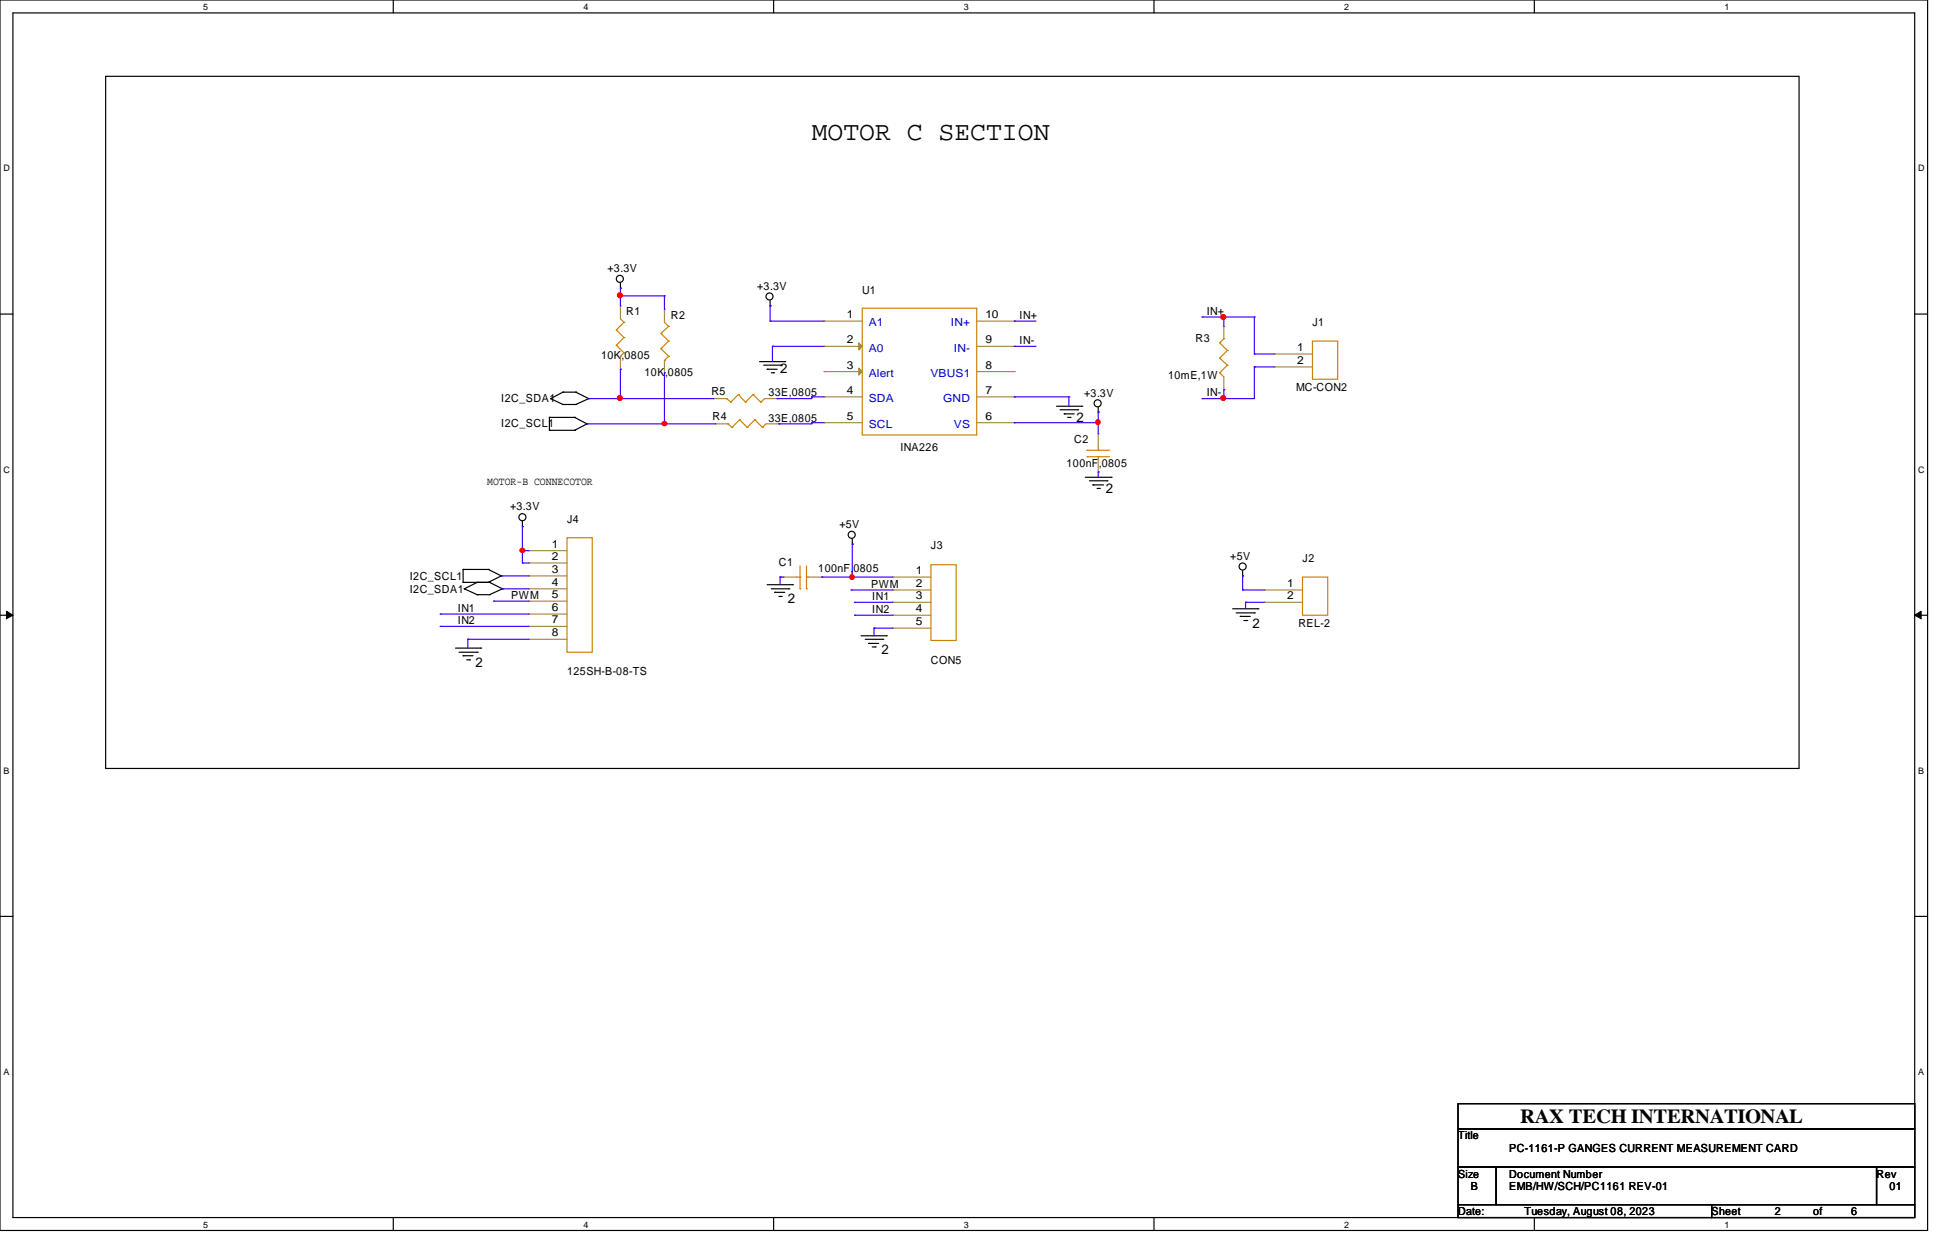
[picture p40: page 1]

PC-1161-P GANGES CURRENT MEASUREMENT CARD
