vidittyagi118/Ganges_schematic_BOM/CLEANER FILES/SCHEMATICS/Mauricio/PCB-Project1/PCB_Project/Project Outputs for PCB_Project/Job1.PDF

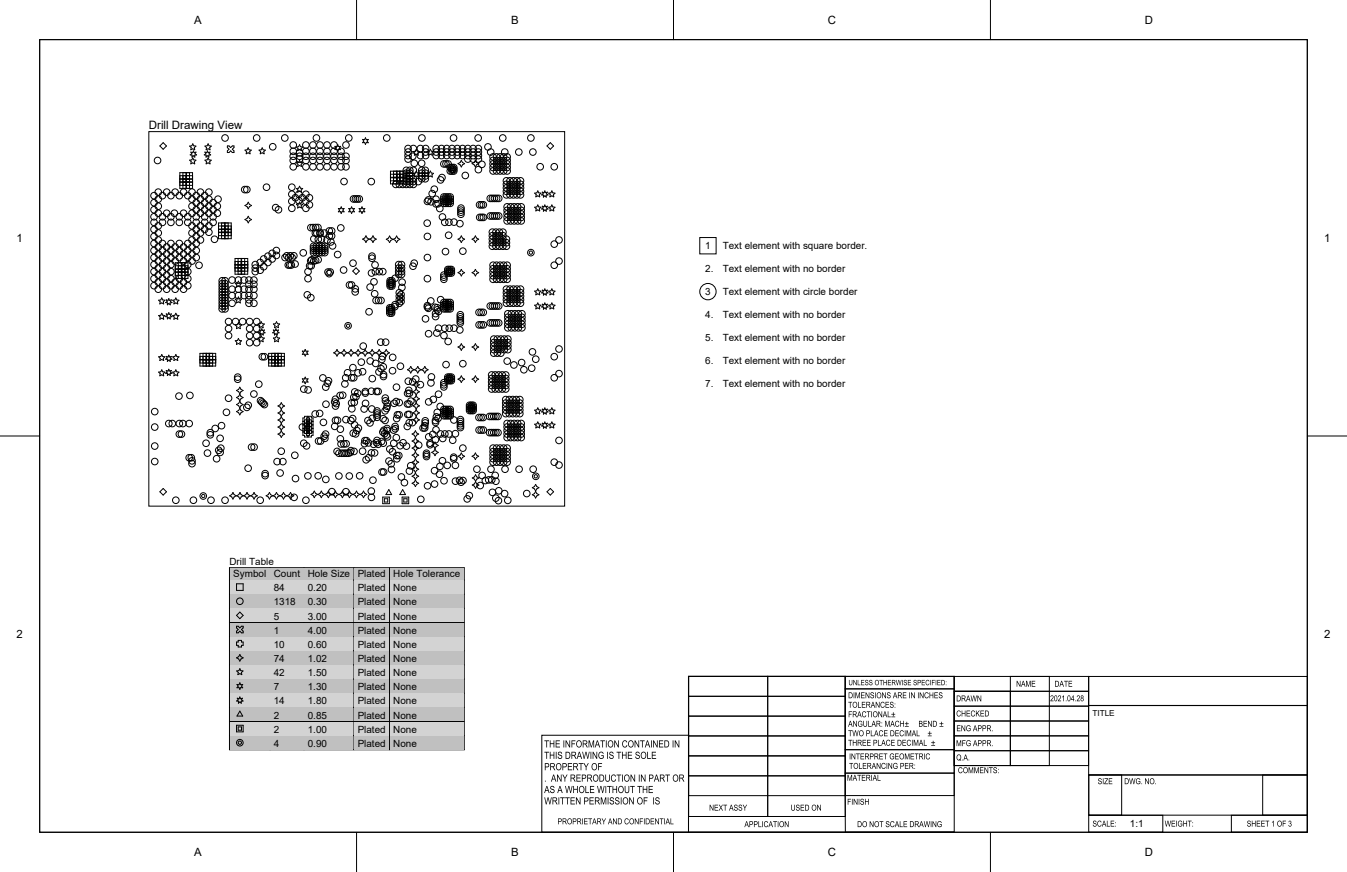
[picture p41: page 1]

2. Text element with no border

3 Text element with circle border

4. Text element with no border

5. Text element with no border

6. Text element with no border

7. Text element with no border

Symbol | Count | Hole Size | Plated | Hole Tolerance

84 | 0.20 | Plated | None
1318 | 0.30 | Plated | None
5 | 3.00 | Plated | None
1 | 4.00 | Plated | None
10 | 0.60 | Plated | None
74 | 1.02 | Plated | None
42 | 1.50 | Plated | None
7 | 1.30 | Plated | None
14 | 1.80 | Plated | None

2 | 1.00 | Plated | None
4 | 0.90 | Plated | None

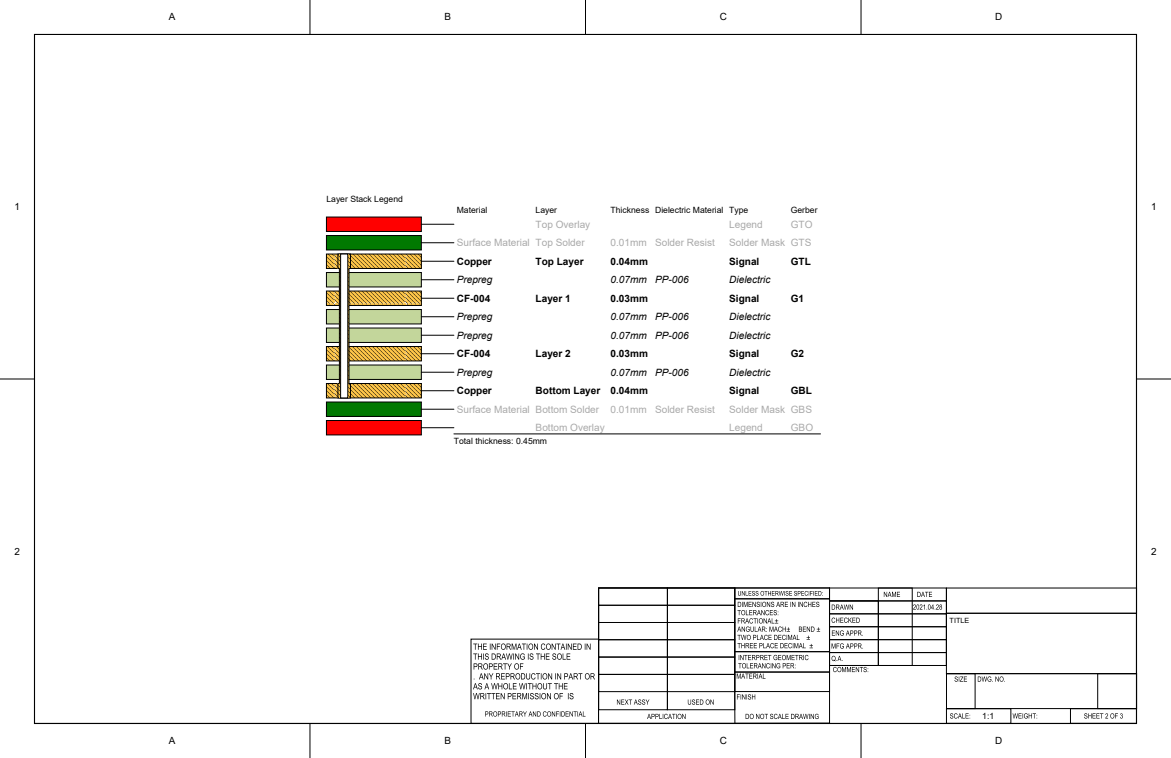
[picture p42: page 2]

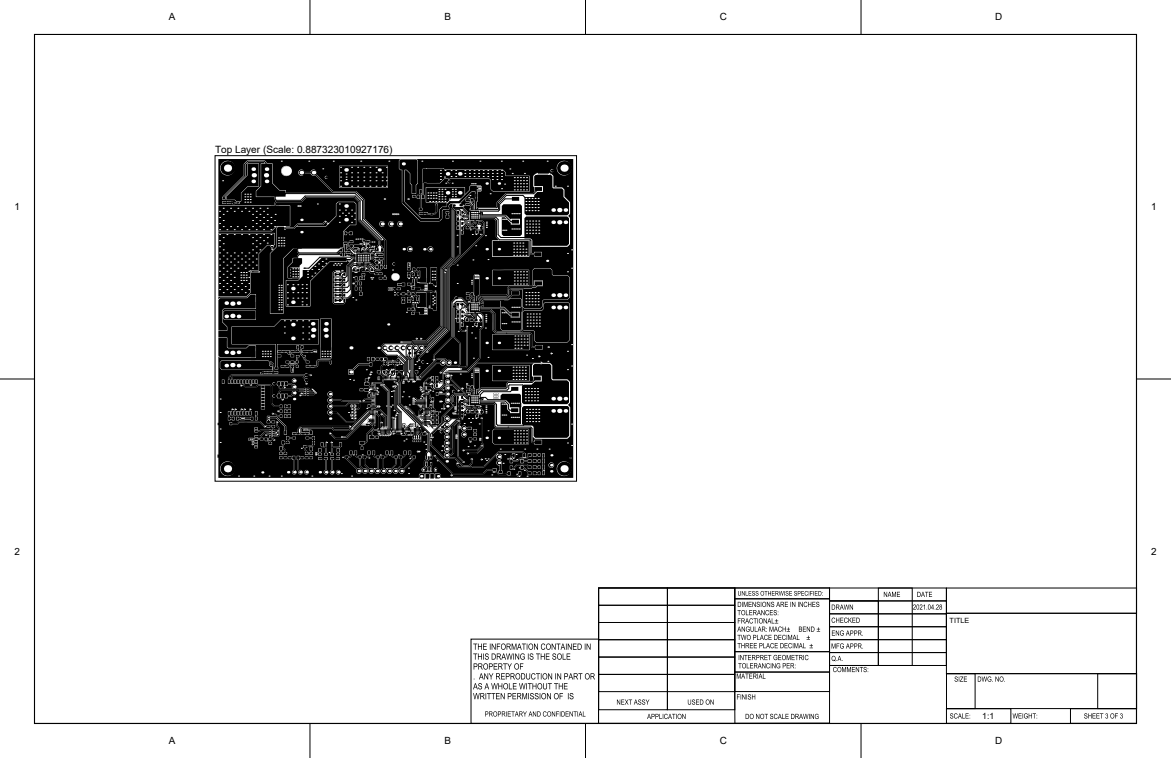
[picture p43: page 3]
