vidittyagi118/Ganges_schematic_BOM/Ganges_SCH child board/PC-1160 GANGERS RTC CARD SCH.pdf

## REAL TIME CLOCK

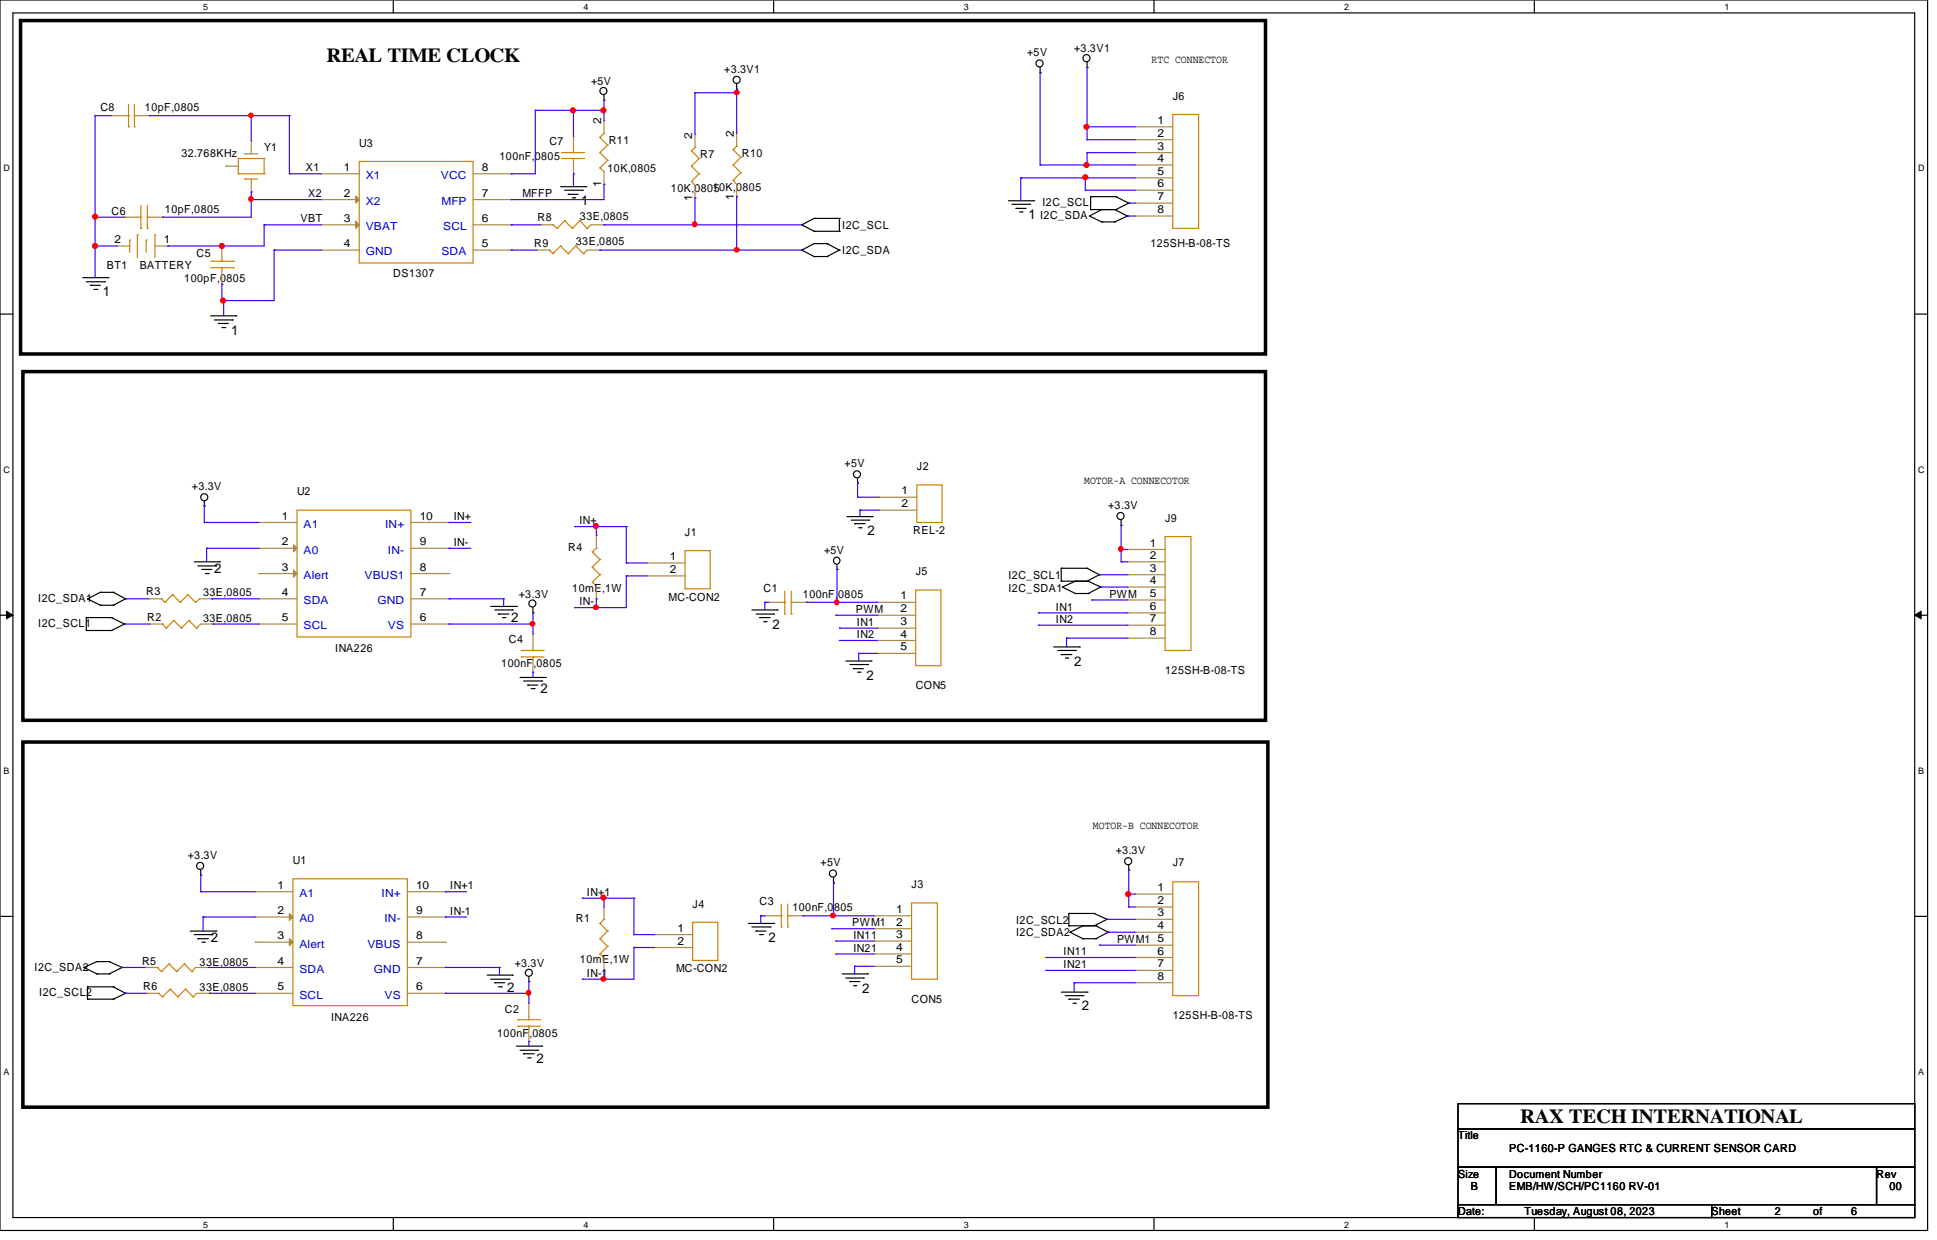
[picture p44: page 1]

PC-1160-P GANGES RTC & CURRENT SENSOR CARD
