vidittyagi118/Ganges_schematic_BOM/Ganges_SCH child board/PC-1162 GANGES DCDC CARD.pdf

# 24VTO 3.3V REGULATOR SECTION

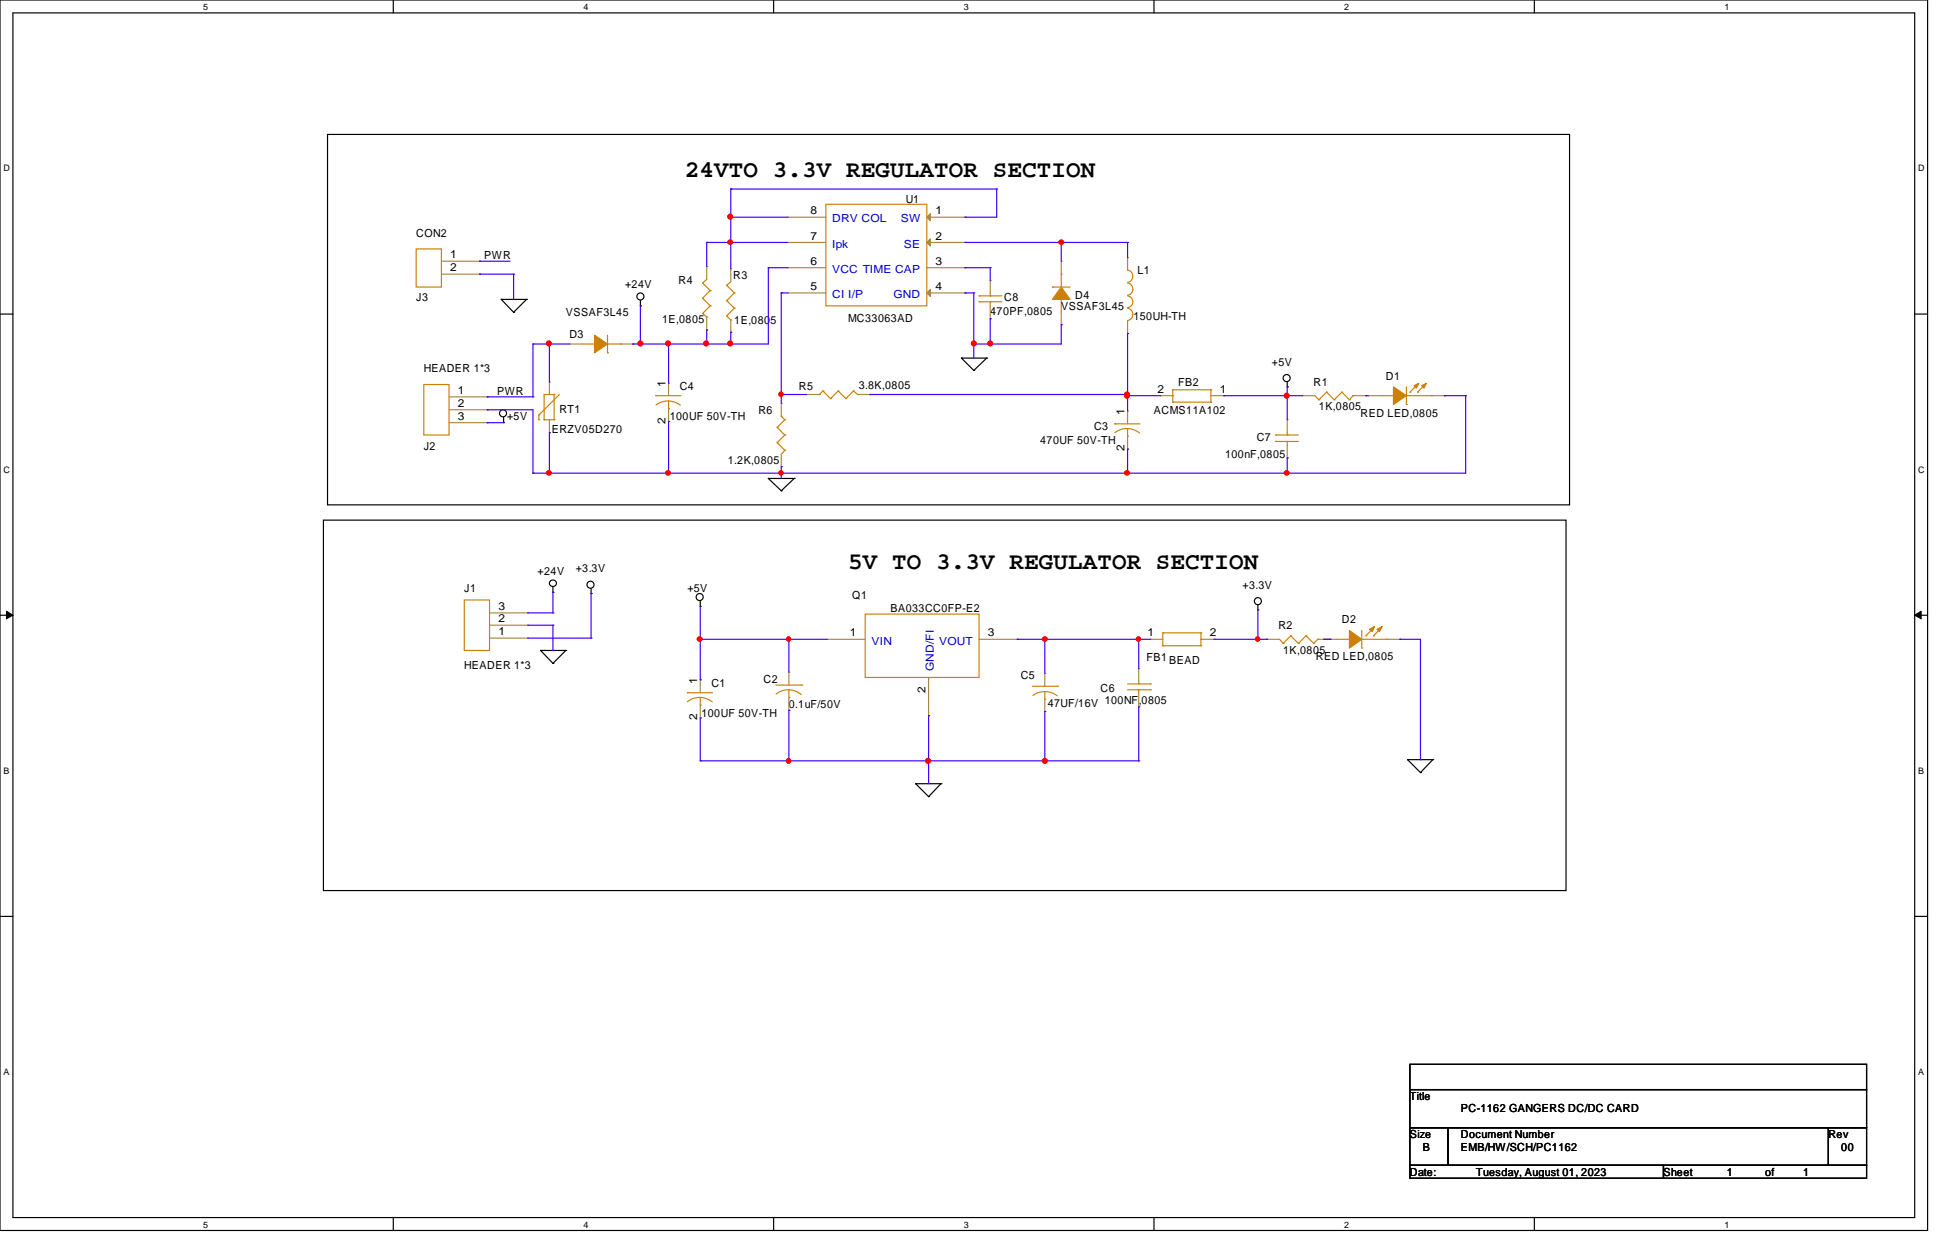
[picture p45: page 1]

PC-1162 GANGERS DC/DC CARD
