vidittyagi118/Ganges_schematic_BOM/katyayan Project2 All files/Source Files (Altium)/Ascii of Main Board V1.1.pdf

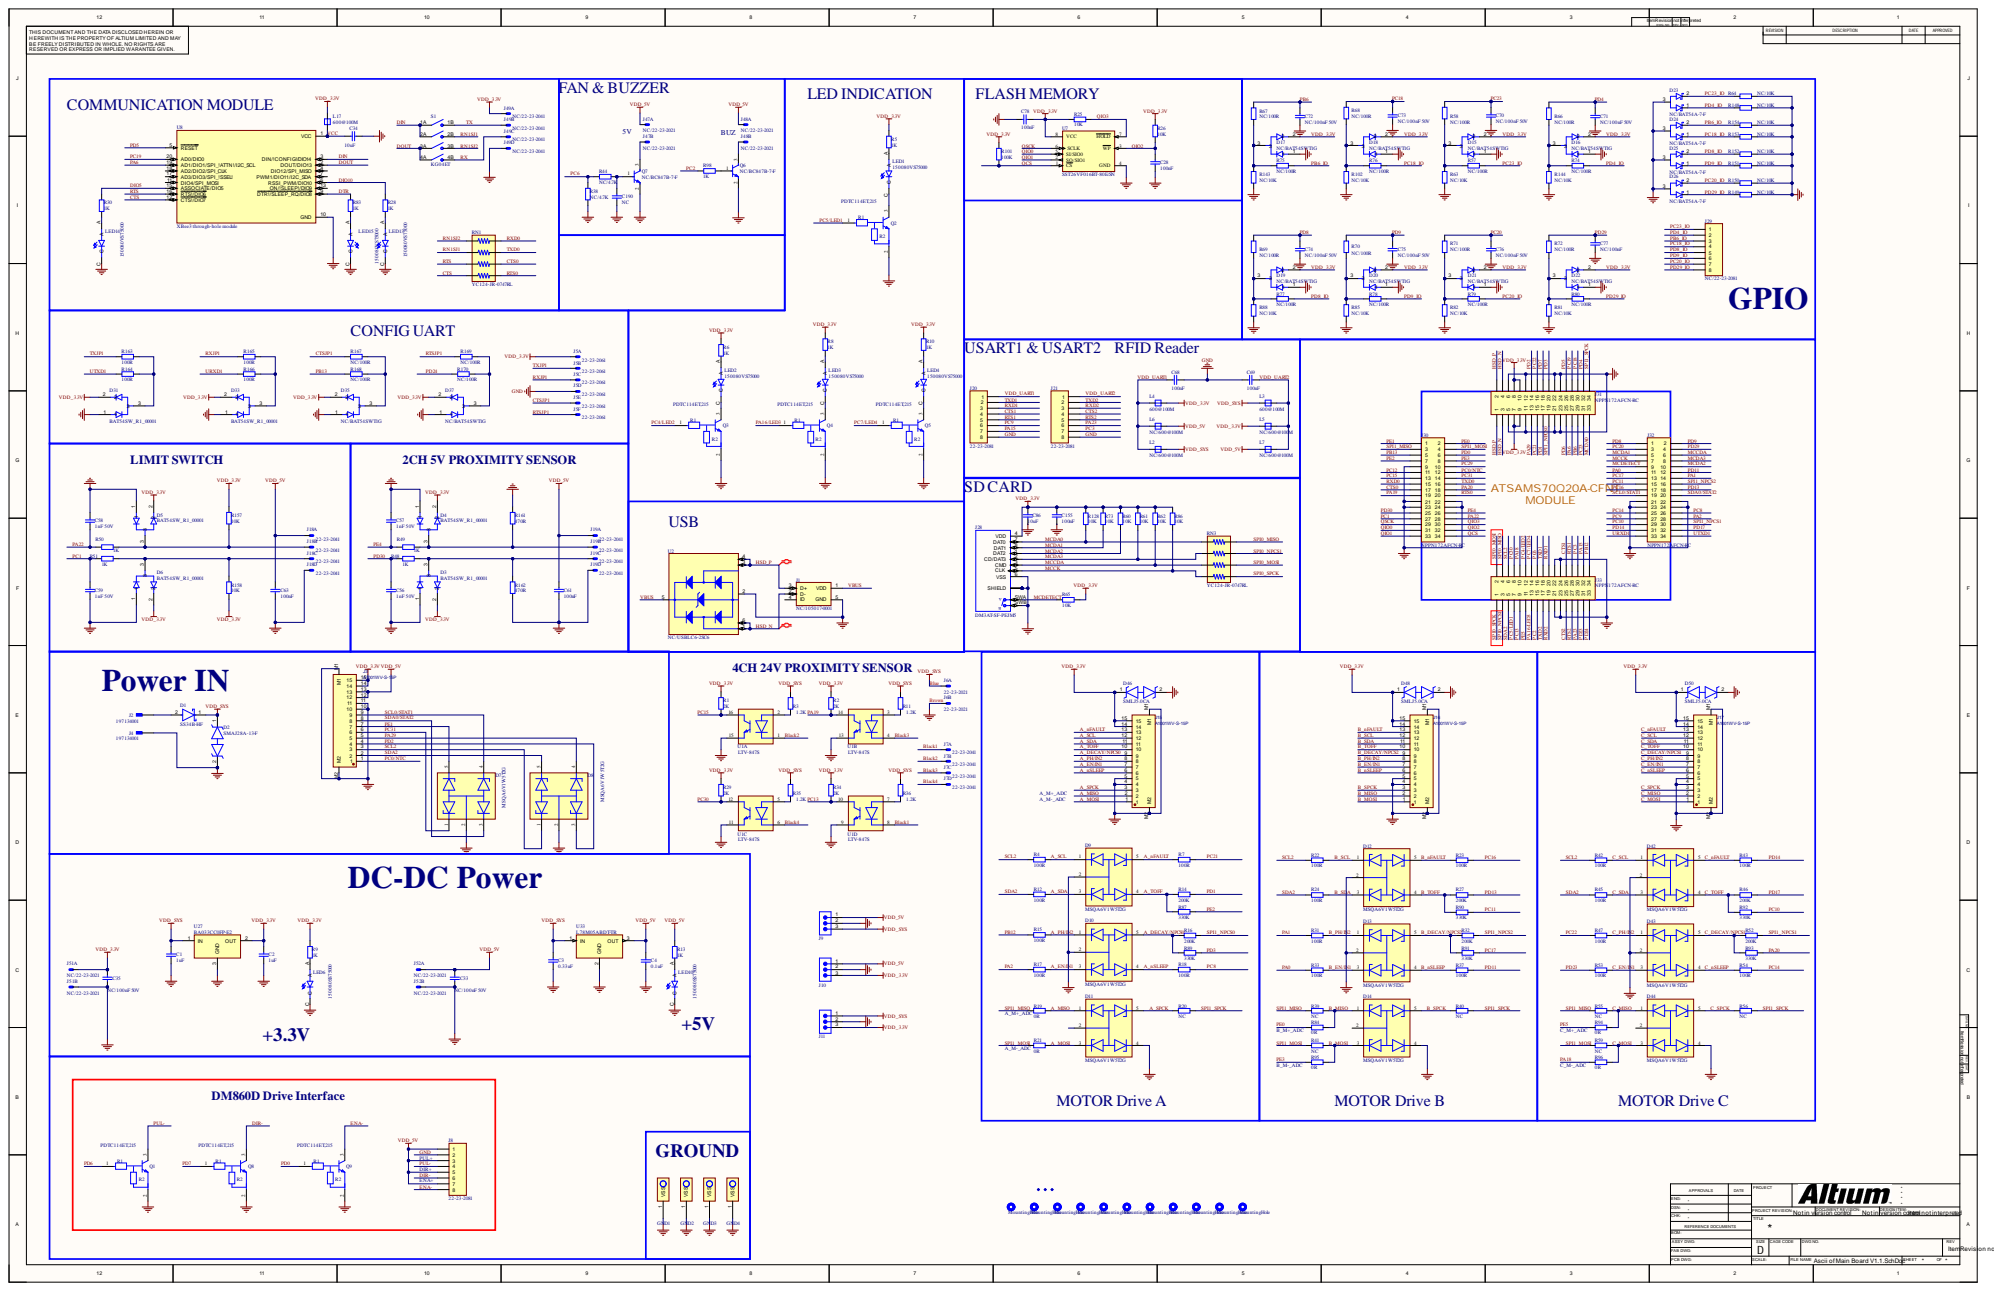
[picture p46: page 1]

ItemRevision not in*terpreted

DWG.NO. REV. SHT.

THIS DOCUMENT AND THE DATA DISCLOSED HEREIN OR H EREWITH IS THE PROPERTY OF ALTIUM LIMITED AND MAY BE FREELY DISTRIBUTED IN WHOLE. NO RIGHTS ARE RESERVED OR EXPRESS OR IMPLIED WARANTEE GIVEN. | REVISION DESCRIPTION DATE APPROVED

TXD1 RXD1 CTS1 | TXD2 RXD2 CTS2

RTS1 PC9 | RTS2 PA23

MCDA3 MCCDA MCCK | SPI0_MOSI SPI0_SPCK

4CH 24V PROXIMITY SENSOR VDD_3.3V VDD_3.3V | VDD_3.3V | VDD_3.3V | VDD_3.3V

REV. SHT. DWG.NO.

GND | 1 2 3 4 5 6 7 8

ENG: *
DSN: * CHK: * | DOCUMENT REVISION: Not in version control DESIGN ITEM: Not in version control Item not interpreted PROJECT REVISION: TITLE *
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
