vidittyagi118/Ganges_schematic_BOM/Schematic_DS3231 RTC Zeno Varient_2022-01-11_PCBWay Community.pdf

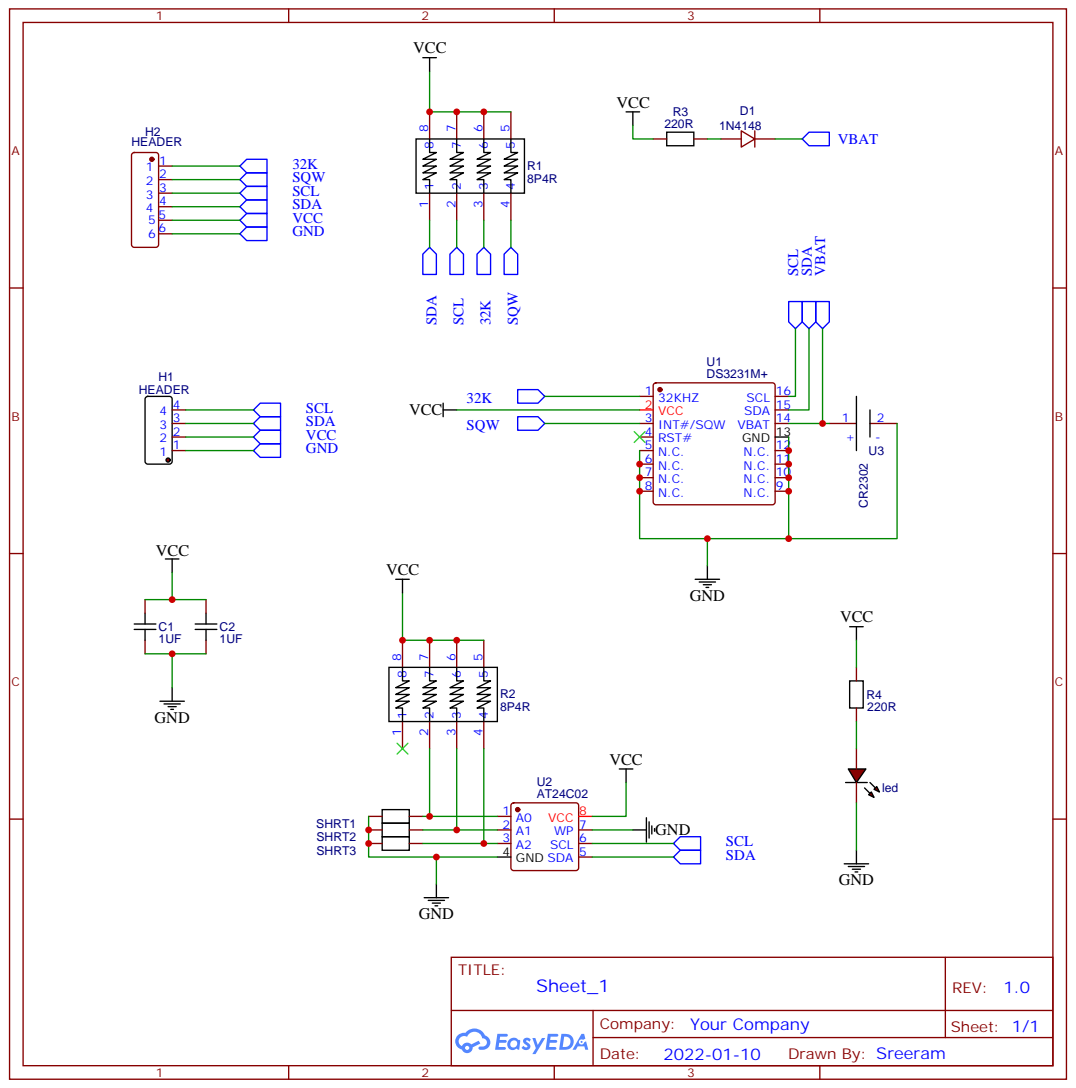
[picture p47: page 1]
