vidittyagi118/Ganges_schematic_BOM/MCU Module V1.1(ASCII).pdf

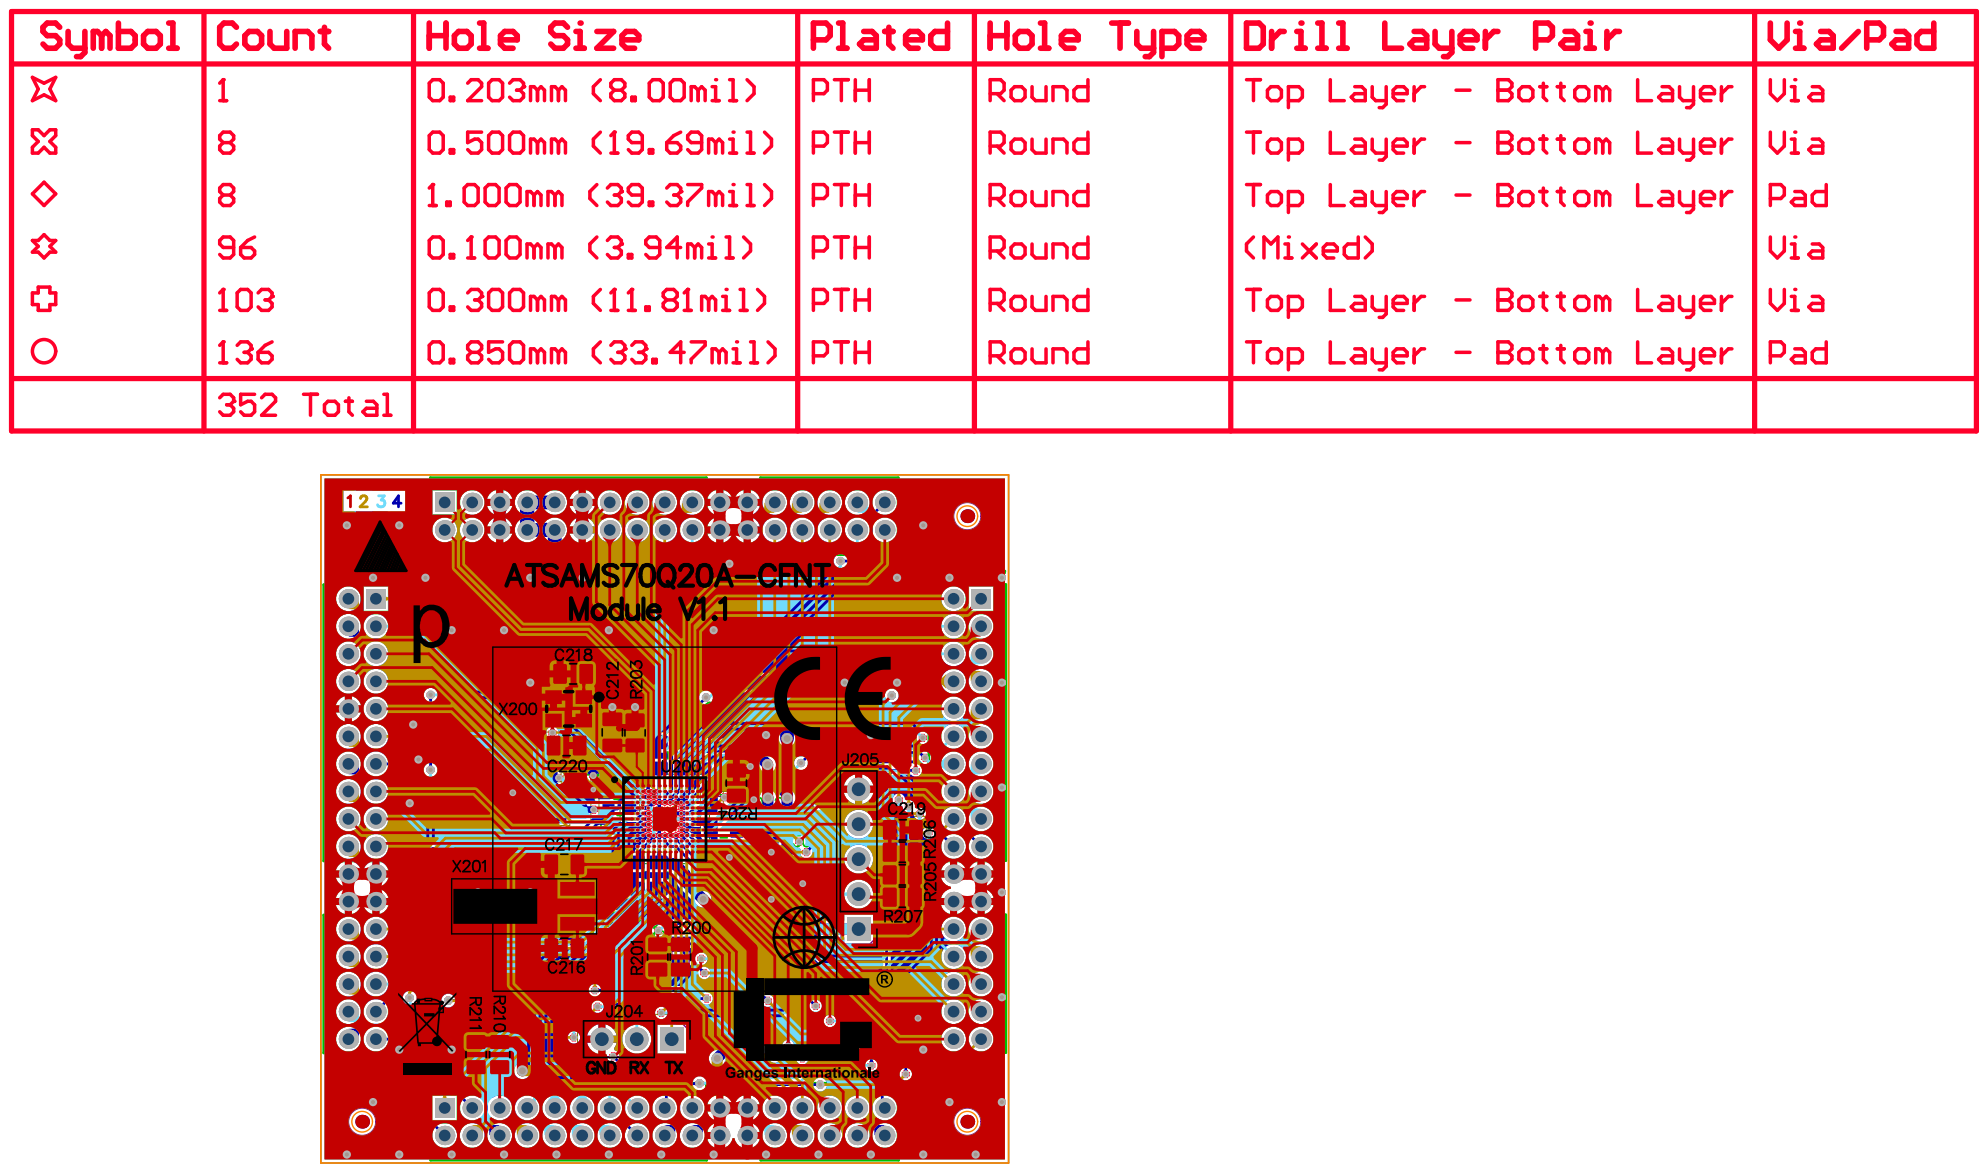
[picture p48: page 1]
