vidittyagi118/Ganges_schematic_BOM/Main Boards Editing/Main Boards Editing/ROBO Layout-KASARE.pdf

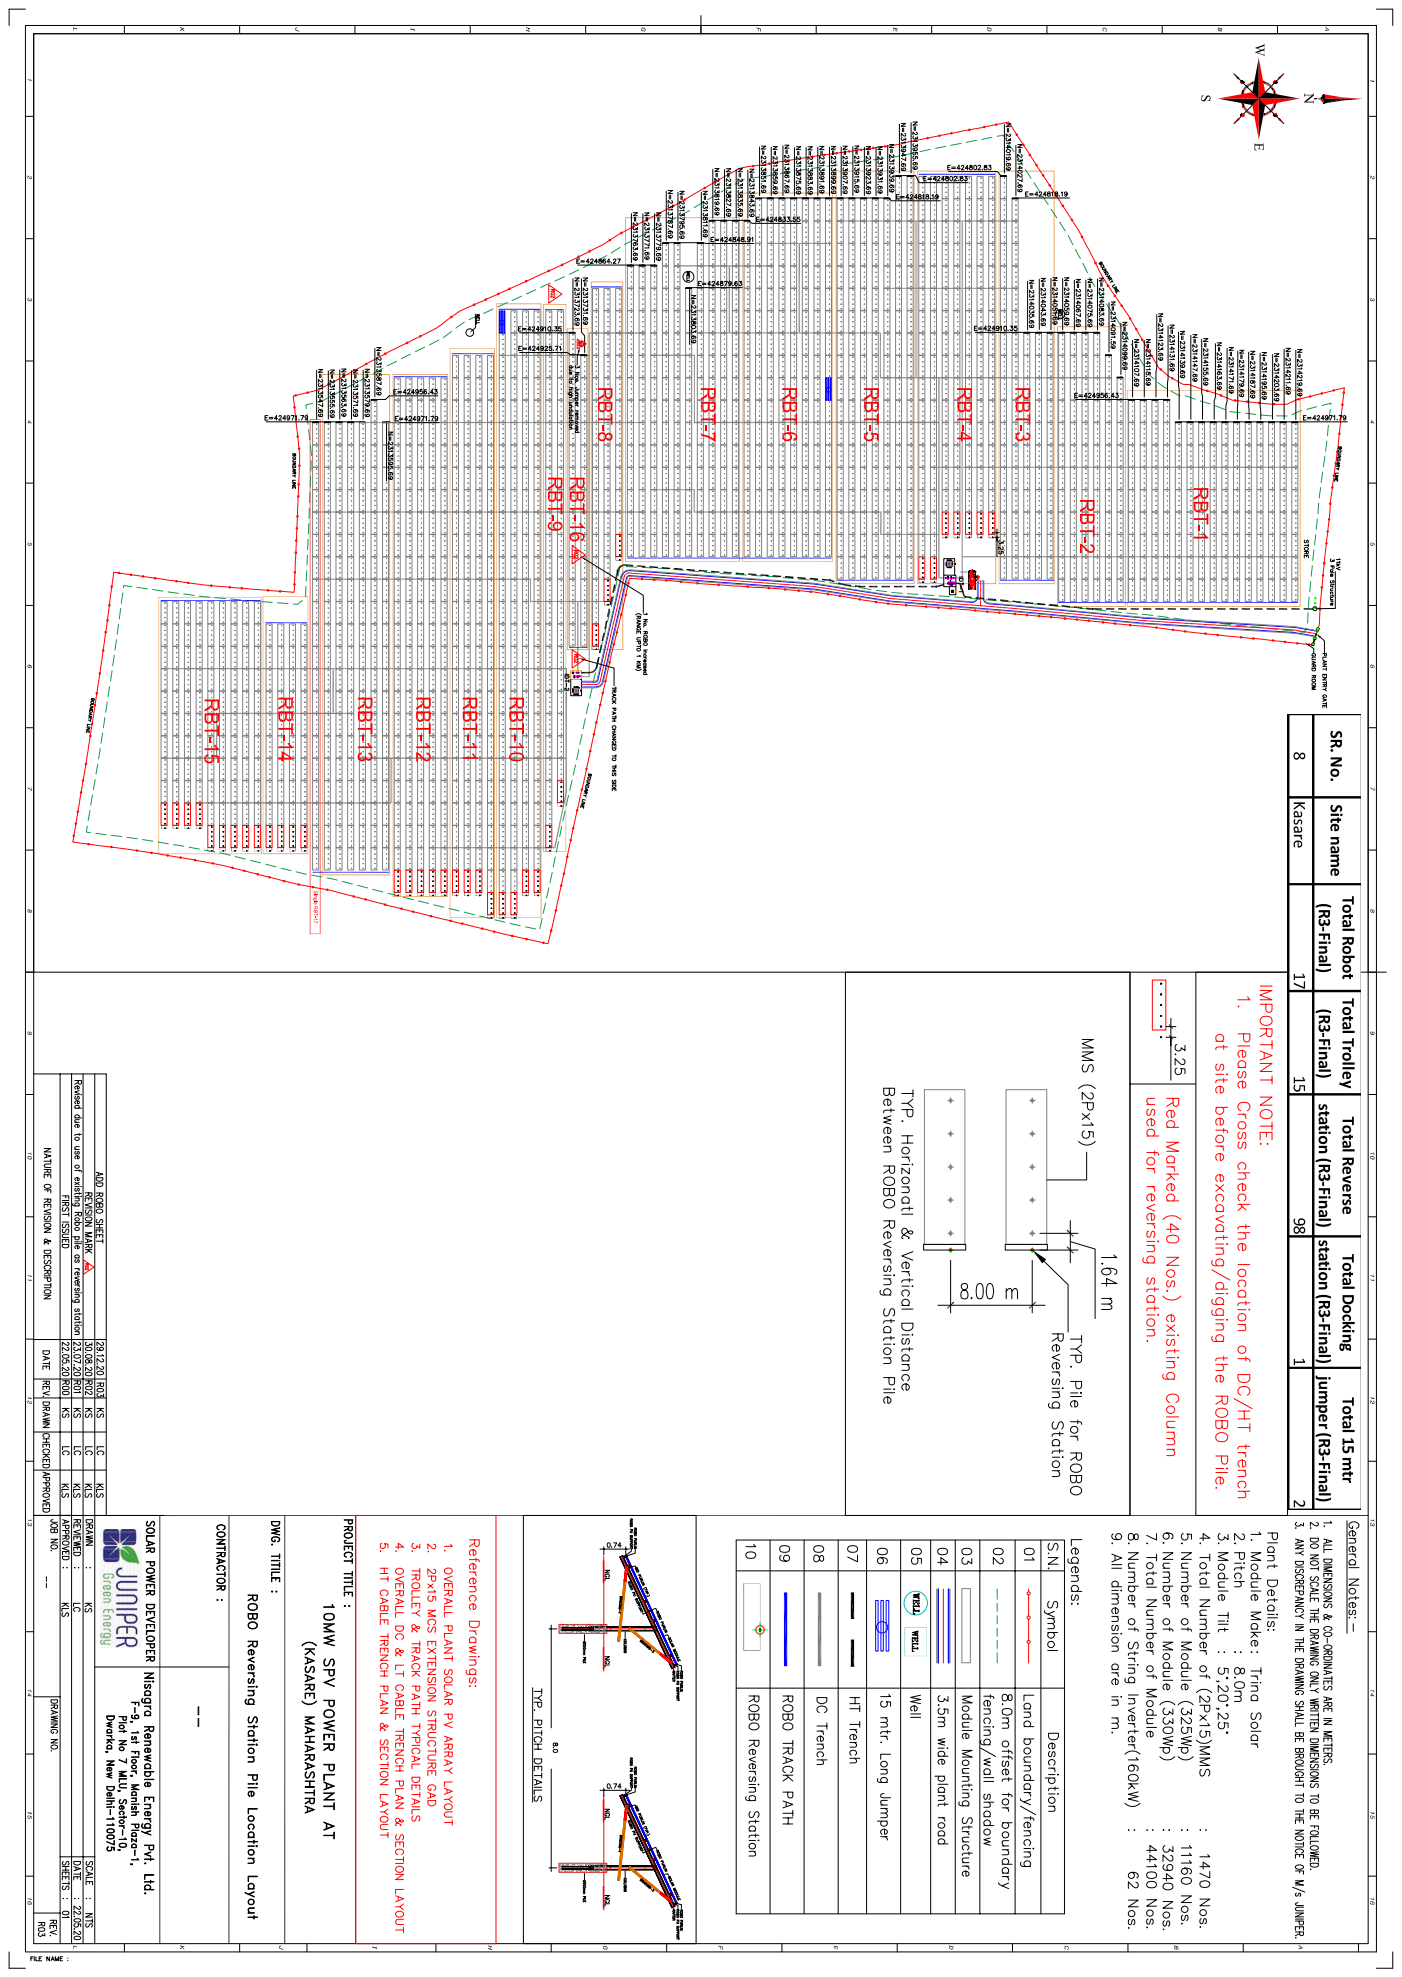
[picture p49: page 1]
