vidittyagi118/Ganges_schematic_BOM/Controller_Schematic.pdf OLD BOARD.pdf

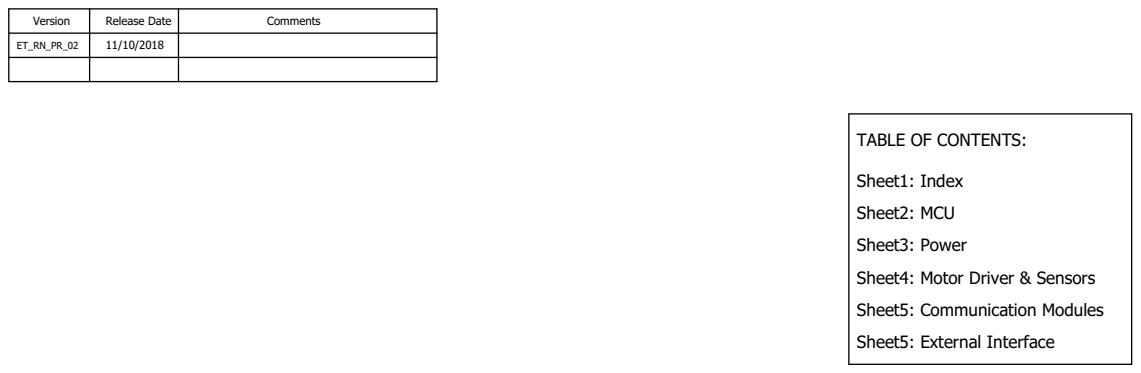
[picture p50: page 1]

Version | Release Date | Comments

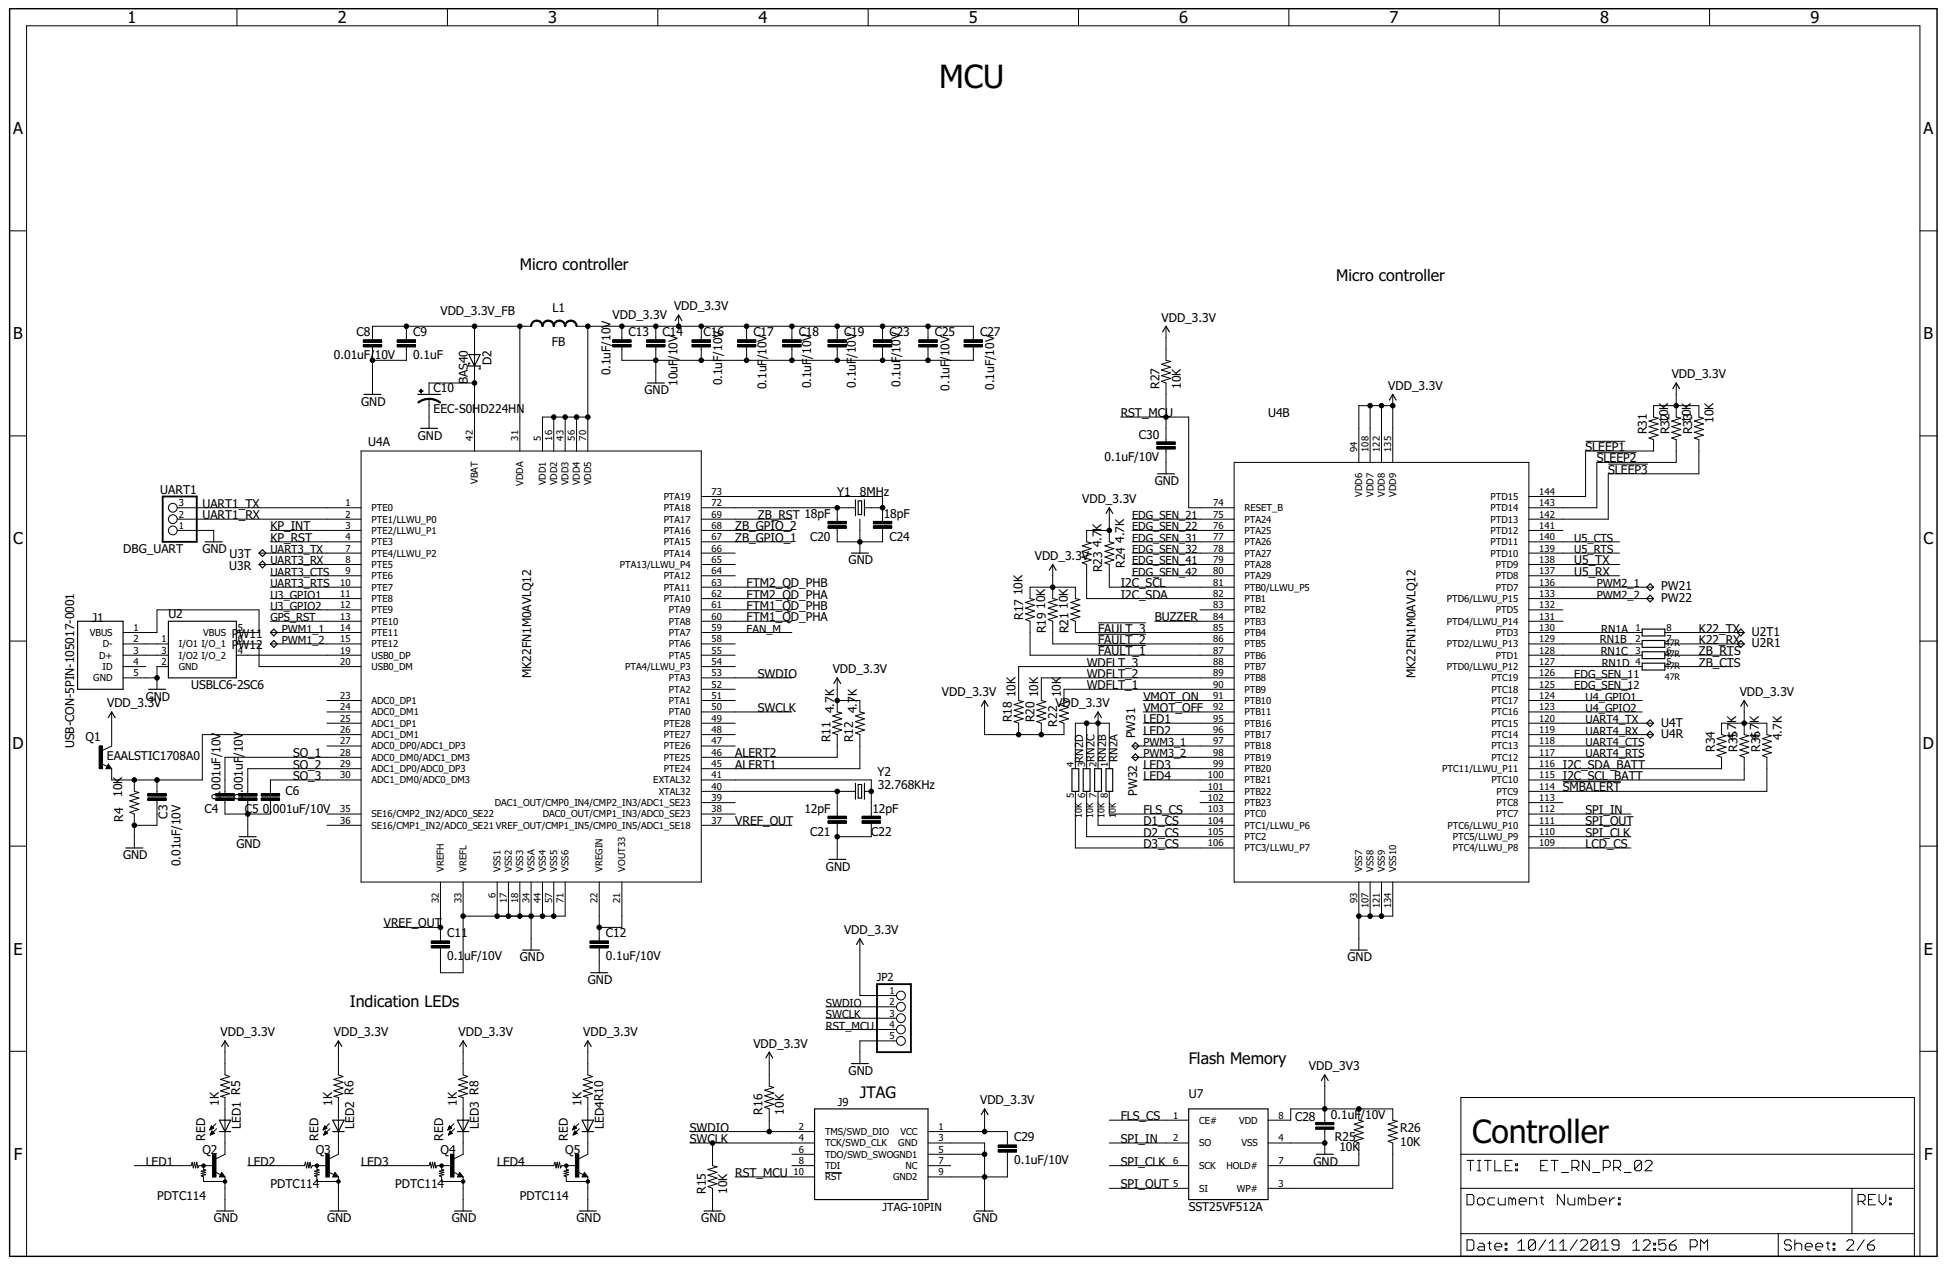
[picture p51: page 2]

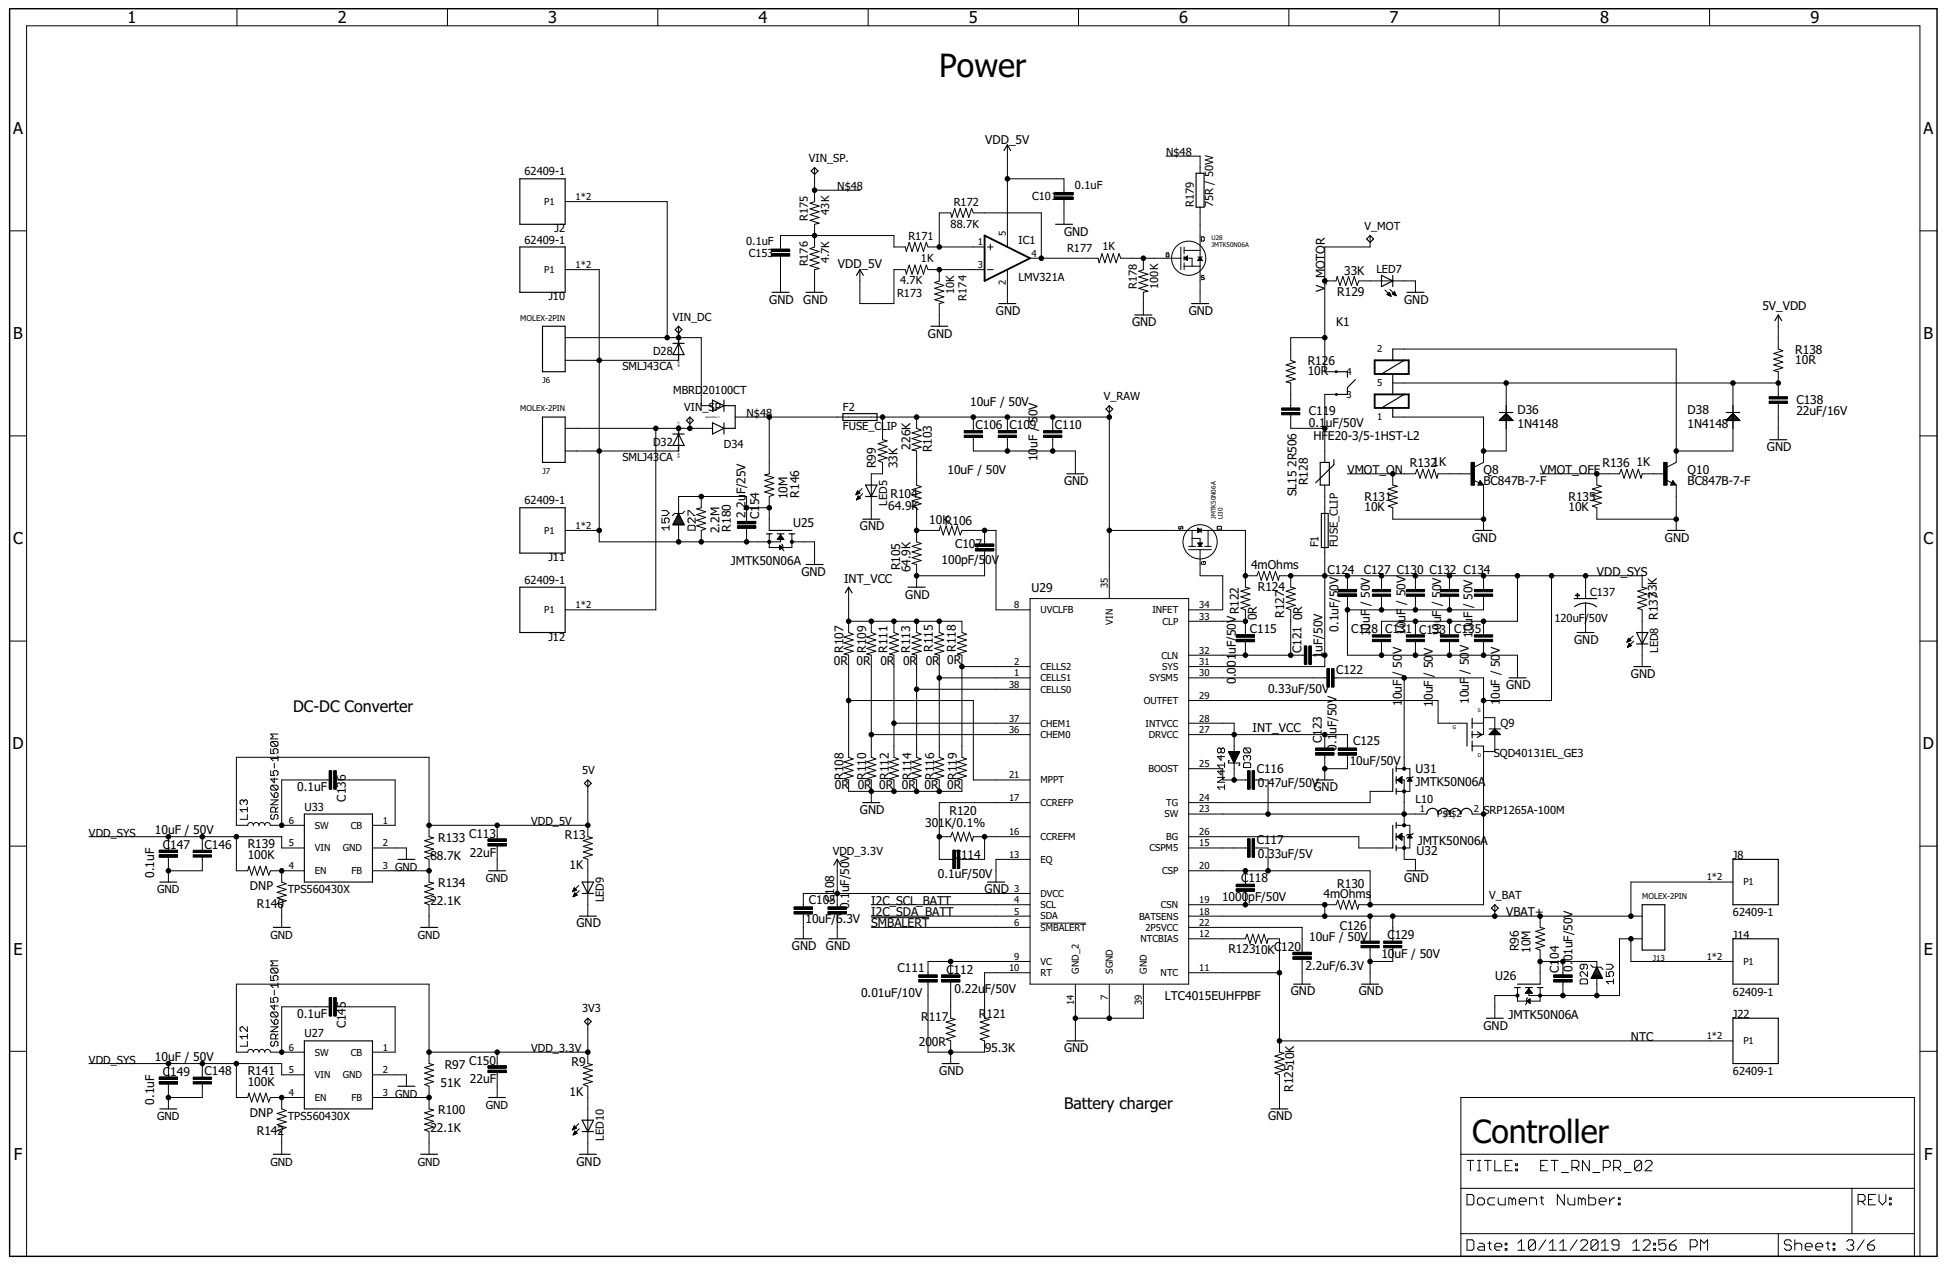
[picture p52: page 3]

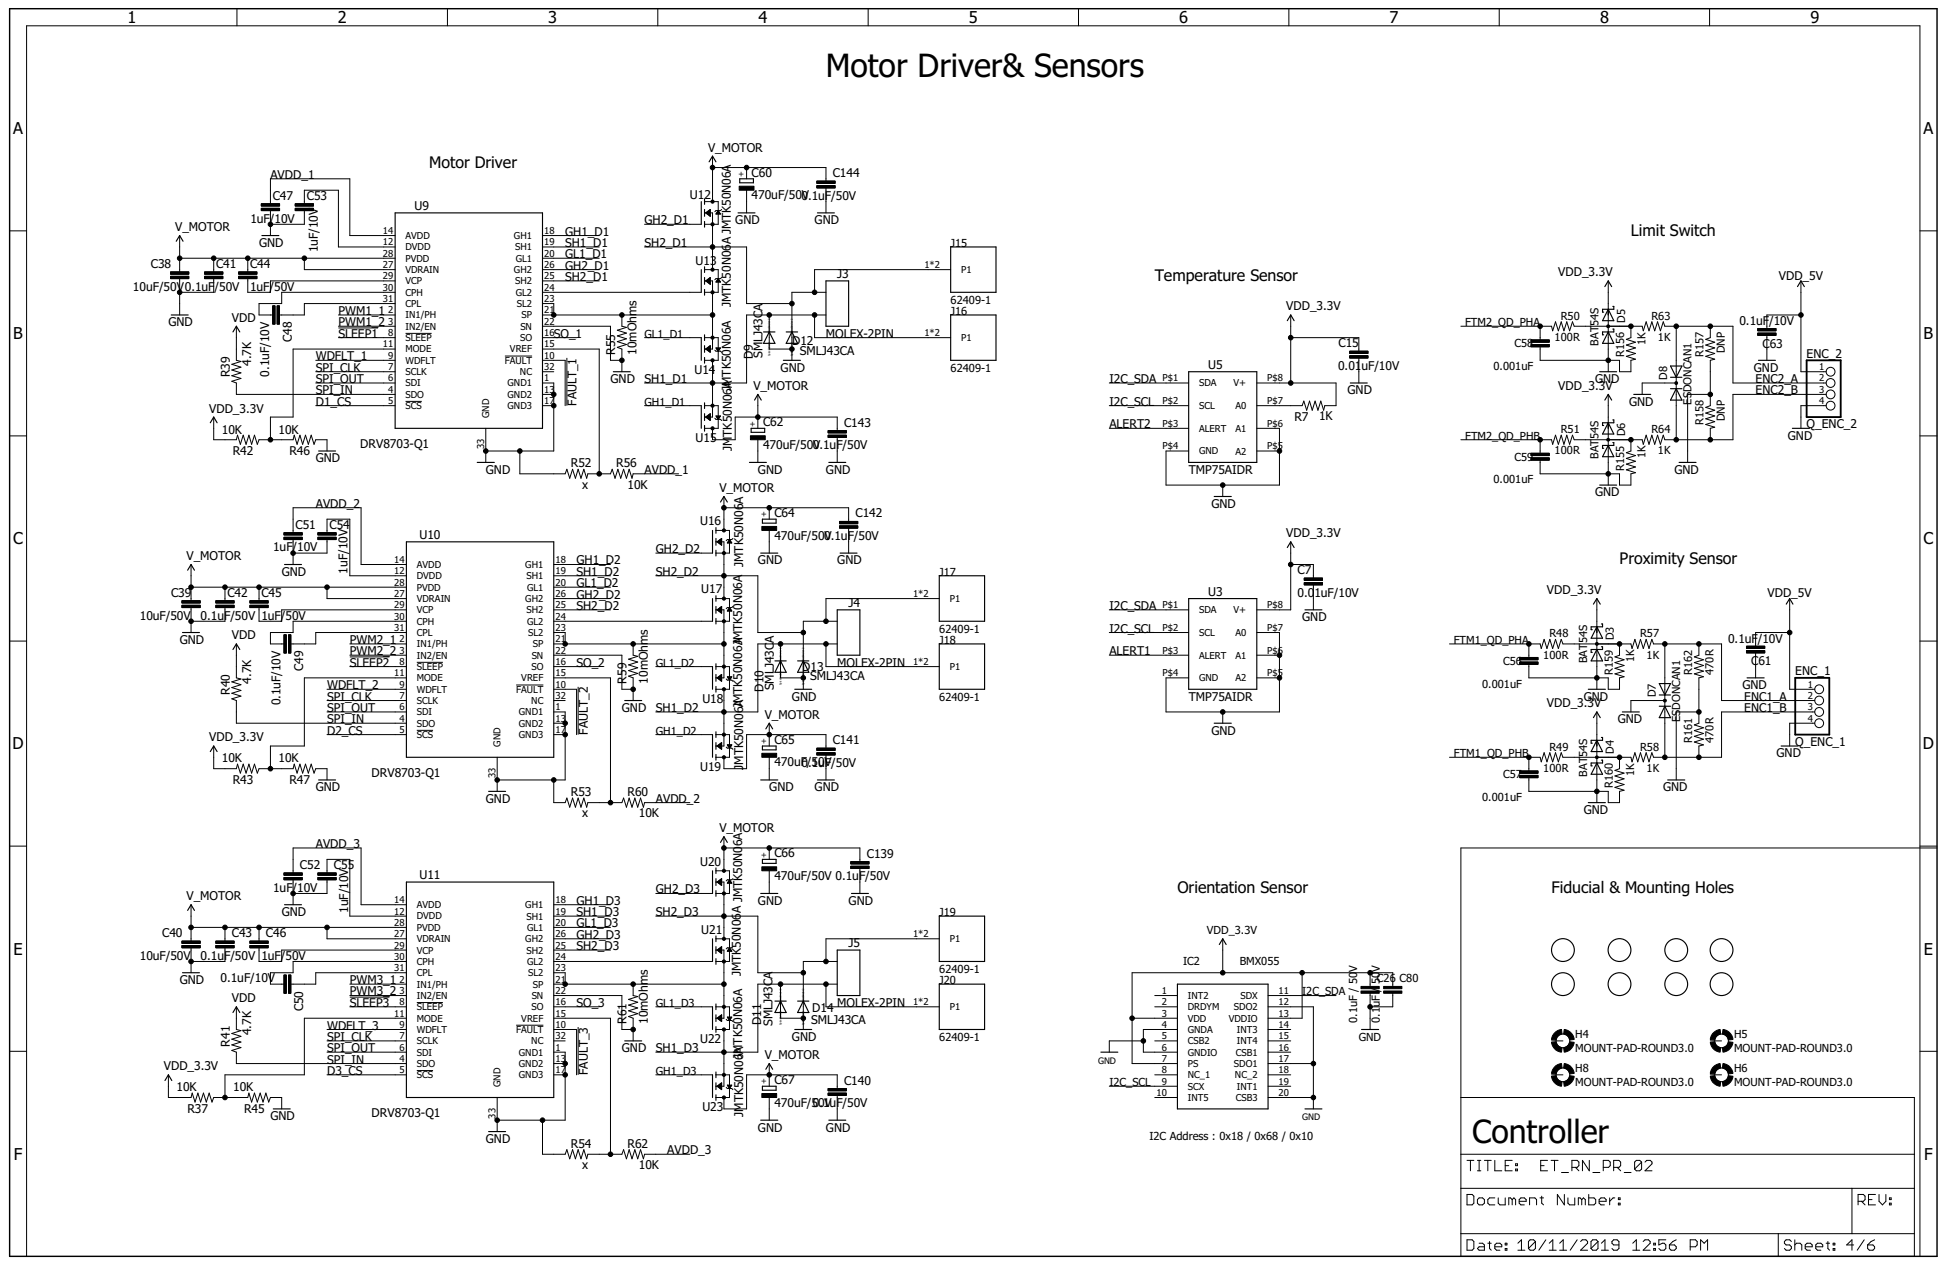
[picture p53: page 4]

SpiceOrder 1 SpiceOrder 2

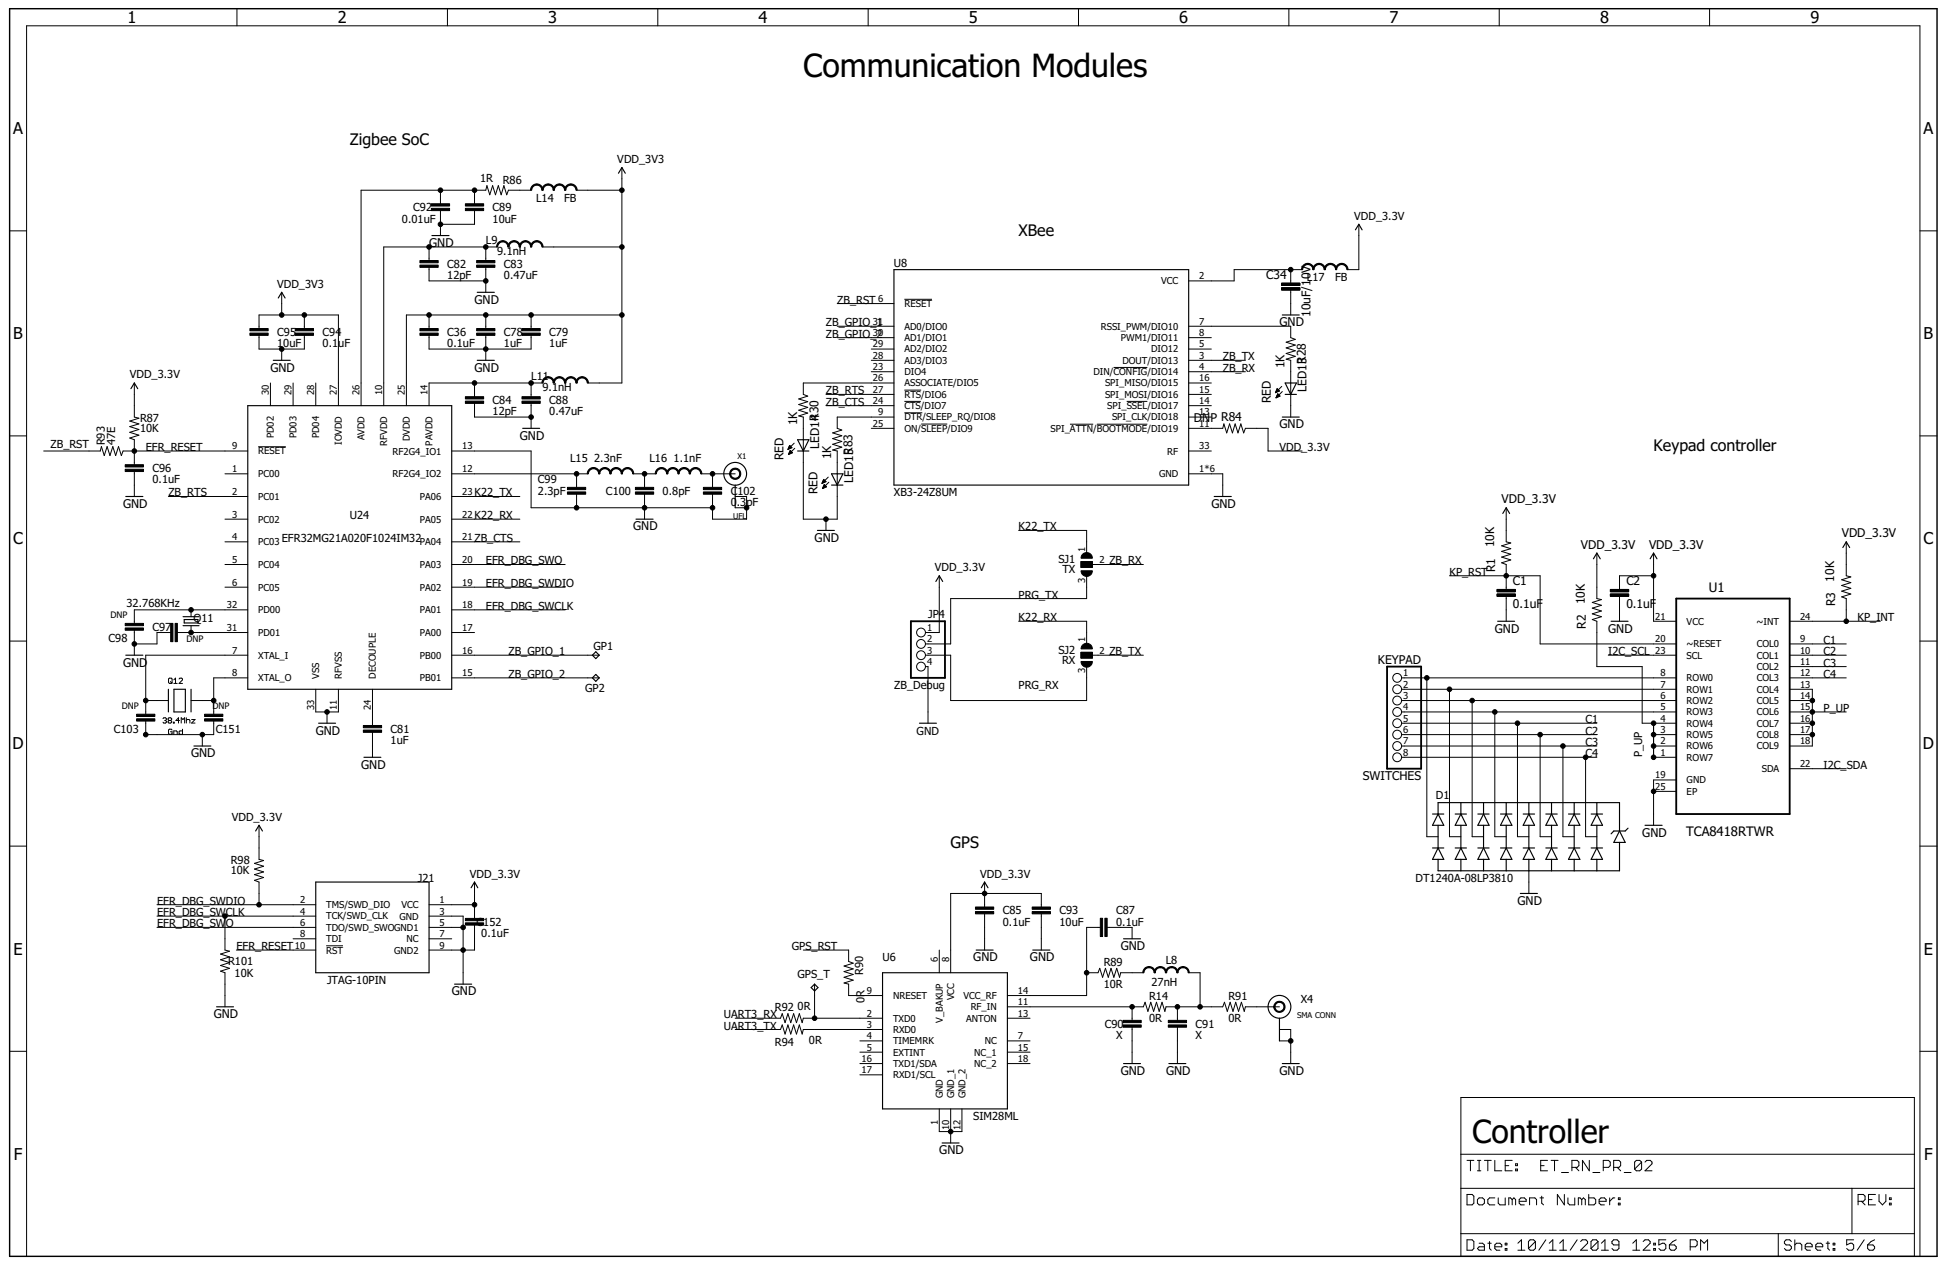
[picture p54: page 5]

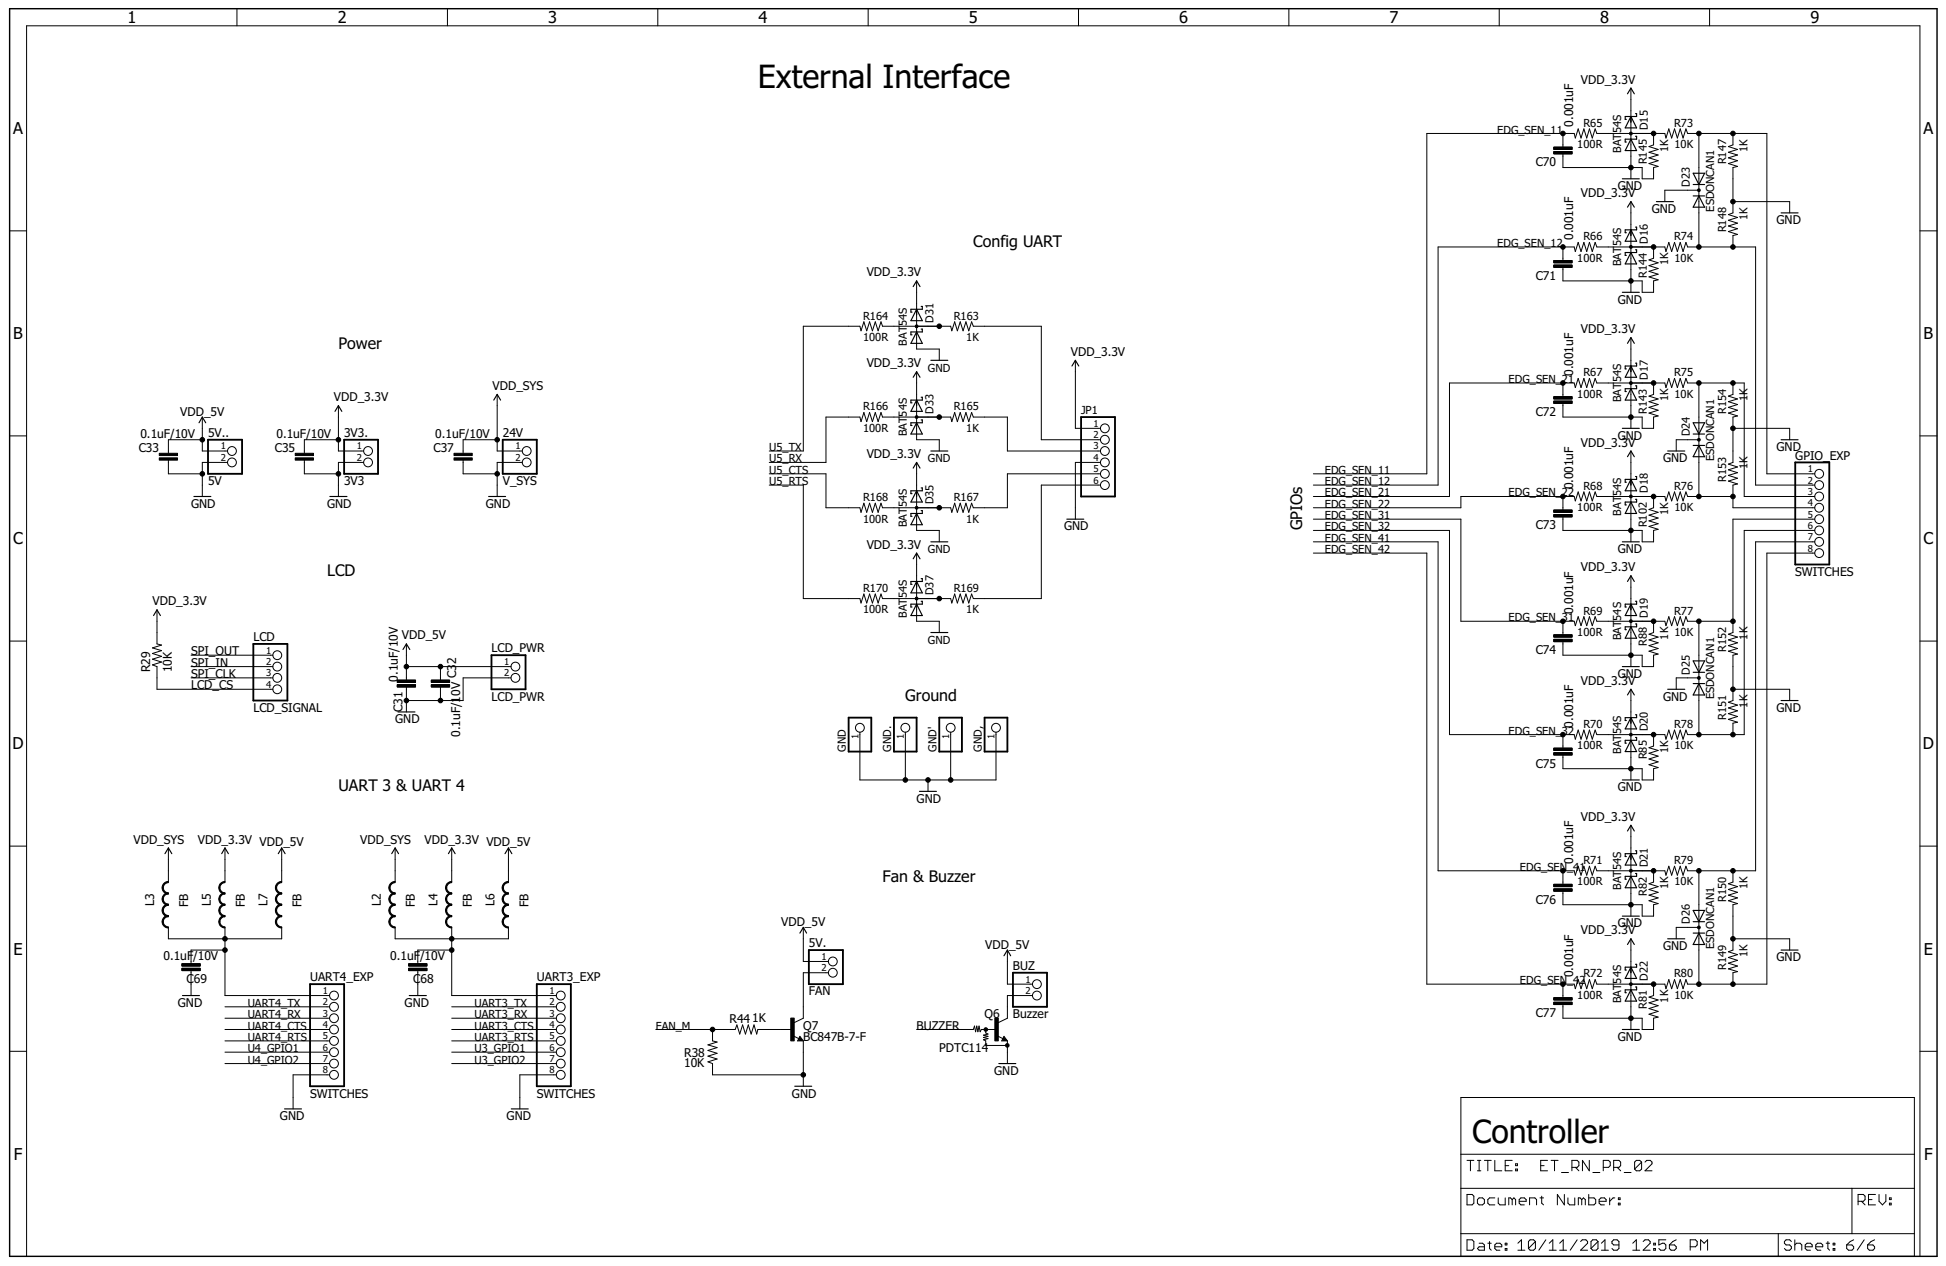
[picture p55: page 6]
