vidittyagi118/Ganges_schematic_BOM/PIN_DIAGRAM OF OLD BOARD.PDF

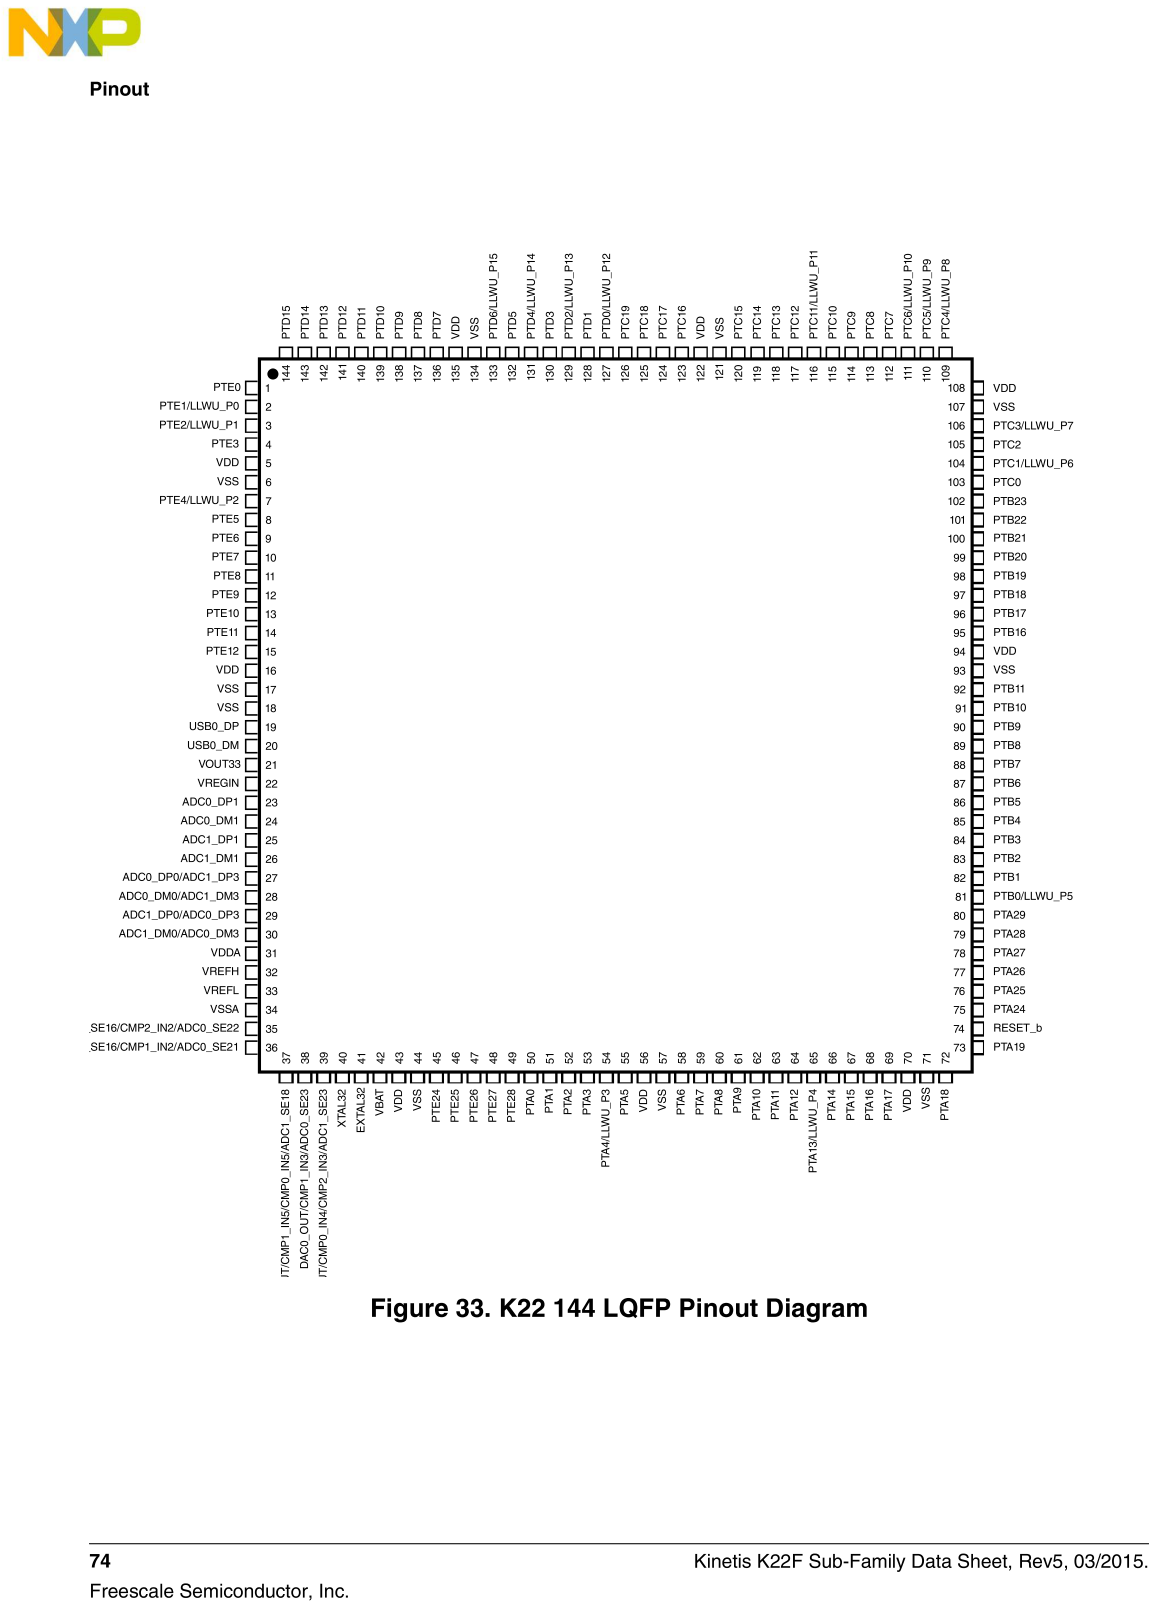
[picture p56: page 1]
