vidittyagi118/Ganges_schematic_BOM/(list of files, drawings)

Other design files:
Altium Files (Source Files) (1)/MCU Module V1.1(ASCII).PcbDoc
Altium Files (Source Files) (1)/MCU Module V1.1(ASCII).PcbLib
Altium Files (Source Files) (1)/MCU Module V1.1(ASCII).SchDoc
Altium Files (Source Files) (1)/MCU Module V1.1.PrjPCB
Altium Files (Source Files) (1)/MCU Module V1.1.SCHLIB
CLEANER FILES/SCHEMATICS/Mauricio/PCB-Project1/PCB_Project/PCB_Project.PrjPcb
CLEANER FILES/SCHEMATICS/Mauricio/PCB-Project1/PCB_Project/Sheet1.SchDoc
katyayan Project2 All files/Source Files (Altium)/Ascii of Main Board V1.1.PcbLib
katyayan Project2 All files/Source Files (Altium)/Ascii of Main Board V1.1.SchDoc
katyayan Project2 All files/Source Files (Altium)/Main Board V1.1.PrjPCB
katyayan Project2 All files/Source Files (Altium)/Main Board V1.1.SCHLIB
Main Boards Editing/Main Boards Editing/Ascii of Main Board V1.1.SchDoc
Main Boards Editing/Main Boards Editing/PCB Re-design Scope of Work/Design/Main Board Design/V1.1/Main Board V1.1.PrjPCB
