vidittyagi118/Ganges_schematic_BOM/CLEANER FILES/CODE/CLEANER/Source/API PROCESSING/APIProcessing.c

#include "APIProcessing.h"
#include <string.h>
#include <stdint.h>
#include <stdlib.h>
#include <stdio.h>

#include "NumStrConversion.h"
#include "ValuesValidate.h"
#include "Serial_Debug.h"
#include "TempVariables.h"
#include "RobotOperation.h"
#include "RobotControl.h"
#include "RotateSenseCommon.h"
#include "EdgeSenseCommon.h"
#include "DefaultValues.h"
#include "DefaultValuesConfig.h"
#include "CycleMode.h"
#include "LTC4015_Main.h"
#include "Rtc.h"
#include "Adc.h"
#include "BrushControl.h"
#include "BrushMotorControl_hal.h"
#include "AutoSchedule.h"
#include "MotCurrentFaultCommon.h"
#include "ZigbeeApiMode.h"
#include "FaultProcess.h"
#include "temp_sensors.h"
#include "EventLoggerFlash.h"
#include "EventLogger.h"
#include "ConfigAPIProcess.h"
#include "math.h"
#include "RobotOperation.h"
#include "RotateSenseCommon.h"
#include "RotateSense1.h"
#include "RotateSense2.h"
#include "EdgeSense1.h"
#include "EdgeSense2.h"
#include "SDFAT/SDcardoperation.h"
#include "SDFAT/ff.h"       
#include "SDFAT/ffconf.h"
#include "SDFAT/diskio.h"
#include "SDFAT/integer.h"
#include "switch.h"


#define MAX_JASON_VALUE_LENGTH             200U
#define LOG_STR_LEN                        35U    
#define MAX_NO_OF_EVENT_LOGS               50

#define CMD_SET_MODE                          0x0001                                                       
#define CMD_SET_MOTOR_DIR_MANUAL              0x0003
#define CMD_SET_MOTOR_PWM_MANUAL              0x0004
#define CMD_SET_BRUSH_MOTOR_STATE             0x0005
#define CMD_SET_BRUSH_MOTOR_PWM_MANUAL        0x0006
#define CMD_SET_BRUSH_MOTOR_DIR               0x0007
#define CMD_SET_MOTOR_PWM_AUTO                0x0009
#define CMD_SET_BRUSH_MOTOR_PWM_AUTO          0x000A
#define CMD_SET_AUTO_SCHEDULE_TIME            0x000B
#define CMD_SET_EDGE_SENSE_STATE              0x000C
#define CMD_SET_RTC_VALUE                     0x000D
#define CMD_SET_DEVICE_INFO                   0x000E
#define CMD_SET_OVERCURRENT_LIMIT             0x000F
#define CMD_CLEAR_ERRORCODES                  0x0010
#define CMD_SET_PULSE_COUNT_VALUES            0x0011
#define CMD_SET_LOW_BAT_SOC                   0x0012
#define CMD_SET_ZIGBEE_CONF                   0x0013   
#define CMD_RESET_ZIGBEE_NTW                  0x0014
#define CMD_RESET_TO_DEFAULTS                 0x0015
#define CMD_SET_MOTOR_FAULT_CONDITIONS        0x0016
#define CMD_CLEAR_ACTIVITY_LOG                0x0017  
#define CMD_SET_PULSE_COUNT_AND_CYCLE         0x001D
#define CMD_SET_HEARTBEAT_CONFIG              0x001E

#define CMD_GET_CURRENT_MODE                  0x1001
#define CMD_GET_MOTOR_DIR_MANUAL              0x1003
#define CMD_GET_MOTOR_PWM_MANUAL              0x1004
#define CMD_GET_BRUSH_MOTOR_STATE             0x1005
#define CMD_GET_BRUSH_MOTOR_PWM_MANUAL        0x1006
#define CMD_GET_BRUSH_MOTOR_DIR               0x1007
#define CMD_GET_MOTOR_PWM_AUTO                0x1009
#define CMD_GET_BRUSH_MOTOR_PWM_AUTO          0x100A
#define CMD_GET_AUTO_SCHEDULE_TIME            0x100B
#define CMD_GET_EDGE_SENSE_STATE              0x100C
#define CMD_GET_RTC_VALUE                     0x100D
#define CMD_GET_CURRENT_STAT                  0x100E
#define CMD_GET_LAST_CYCLE_STAT               0x100F
#define CMD_GET_OVERCURRENT_LIMIT             0x1010
#define CMD_GET_MOT_CURRENT_VALUES            0x1011
#define CMD_GET_PULSE_COUNT_VALUES            0x1014
#define CMD_GET_LOW_BAT_SOC                   0x1015
//#define CMD_GET_SOC                           0x1016
#define CMD_GET_CHARGER_STATE                 0x1017
#define CMD_GET_CONTROLLER_STATUS             0x1018
#define CMD_GET_DEVICE_INFO                   0x1019
#define CMD_GET_ZIGBEE_CONF                   0x101A
#define CMD_GET_ZIGBEE_NTW_PARAM              0x101B
#define CMD_GET_BAT_AND_PV_VAL                0x101C
#define CMD_GET_TEMPERATURES                  0x101D
#define CMD_GET_MOTOR_FAULT_CONDITIONS        0x101E
#define CMD_REQ_ACTIVITY_LOG                  0x101F  
#define CMD_GET_CURRENT_ROBOT_STATUS          0x1021
#define CMD_GET_HEARTBEAT_CONFIG              0x1022

//RT 
#define CMD_SET_LOG_INTERVAL                  0x0030
#define CMD_SET_DIA_WHEEL                     0x0031
#define CMD_SET_CYCLE_FREQUENCY               0x0032
#define CMD_GET_LOG_INTERVAL                  0x1030
#define CMD_GET_DIA_WHEEL                     0x1031
#define CMD_GET_CYCLE_FREQUENCY               0x1032
#define CMD_REQ_LOG                           0x103F
#define CMD_SET_CONTINUE                      0x0033
#define CMD_GET_CONTINUE_COUNT                0x1033
#define CMD_SET_RETURN_STATE                  0x0034
#define CMD_GET_RETURN_STATE                  0x1034              

#define CMD_SET_COM_DISTANCE                  0x0035
#define CMD_GET_COM_DISTANCE                  0x1035

#define CMD_SET_N0_ROW_DAY                     0x0036
#define CMD_GET_N0_ROW_DAY                     0x1036

#define CMD_DEVCIE_WELCOME_MSG                0x1100
#define CMD_ACK_DATA                          0x1111  

#define CMD_SET_ROW_LENGTH_DATA                0x0041 
#define CMD_GET_ROW_LENGTH_DATA                0x1041
#define CMD_SET_ROW_LENGTH2_DATA               0x0042
#define CMD_GET_ROW_LENGTH2_DATA               0x1042
#define CMD_SET_ROW_LENGTH3_DATA               0x0043
#define CMD_GET_ROW_LENGTH3_DATA               0x1043
#define CMD_SET_ROW_LENGTH4_DATA               0x0044
#define CMD_GET_ROW_LENGTH4_DATA               0x1044
#define CMD_SET_ROW_LENGTH5_DATA               0x0045
#define CMD_GET_ROW_LENGTH5_DATA               0x1045
#define CMD_SET_ROW_LENGTH6_DATA               0x0046
#define CMD_GET_ROW_LENGTH6_DATA               0x1046
#define CMD_SET_ROW_LENGTH7_DATA               0x0047
#define CMD_GET_ROW_LENGTH7_DATA               0x1047

uint32_t sum = 0;
extern char Daycount;
//RT
char schedule_log[105]; 
char schedule_log_21[105];
char schedule_BYTE = 0;
char cyclelog[105]; 
char getTime_str[40];
char POS[20],NEG[20];
char Accel_pulse_count[20],Decel_pulse_count[20];
char Battemp_str[10],Drivetemp_str[10],Dietemp_str[10];
char Vin_str[10],Vbat_str[10],Iin_str[10],Ibat_str[10],Dtemp_str[10],Soc_Str[10];
char Imot1_Str[10],Imot2_Str[10],Imot3_Str[10];
char ComPulse[20];

float P=1;
float pos,neg;
float Accel_speed_pulse,Decel_speed_pulse;
float Rotation_per_second;
float posdistance,negdistance;

float CpositiveDistance,CnegativeDistance;
int CpositiveDistance_int,CnegativeDistance_int;
char Cpospulse[20], Cnegpulse[20];
float Cpositive,Cnegative;
int Cpositivedistance,Cnegativedistance;
int Timesecondscpos,Timesecondscneg;

int pulse_flag = 0;
int distancecalc=0, pulsecalc=0, distance = 0;
int forward_remaining_distance,backward_remaining_distance;
int posdistance_int,negdistance_int;
int ComDistance_int;
int Accel_speed,Decel_speed;
int Accel_remaining_distance,Decel_remaining_distance;
int Time_seconds,Time_seconds_forward,Time_seconds_backward;
int Time_seconds_accel,Time_seconds_decel;
int CYCLEROTATIONTIME = 0;
int ComDistance,Compulse;

extern char SCHEDULE_LOG; 
extern char Robot_Error_Count1;
extern char SDerrorlog[45];

extern BYTE  data_read_buffer[Data_Read_Cnt]; 
extern BYTE  data_read_buffer2[Data_Read_Cnt]; 

uint8_t tempCount_NEW;
uint32_t Getpos,Getneg;
uint32_t AccelCount,DecelCount;
uint64_t receivedMACAddr = 0;

uint16_t track_no,day_count;
int Cumulative_distance = 0;

extern uint8_t rxDataBuffer[MAX_UART_RX_BUFFER_LENGTH];
unsigned long int bmsvalue;
char* startbms, endbms;
char temp_arr[100][10], temp_arr1[100][10],slave_arr[10],fun_arr[10],byte_arr[10],uart_arr[100][10];
char bat_arr[10],pv_arr[10],mpptcurr_arr[10],mpptout_arr[10],inttemp_arr[10],exttemp_arr[10],batstate_arr[10], loadout_arr[10],loadtrip_arr[10];
unsigned int Slave_address, function_code,BAT_STATE,BAT_STATE_CNT,LOAD_STATE,ENERGY_HI, REG_5V_EN,REG_5V_TRIP,MODBUS_ADR,REG_PWM,MPPT_CNT,MPPT_STATE,REG_DOMINATE,PV_EN,LOAD_EN,LOAD_COUNT,LOAD_TRIPCNT,size,size1,slave_address_cmp, function_cmp,p1,p2,p3,size_pkt,byte1,byte2,byte3,byte_value;
unsigned char Byte_cnt;
float Vbat,VPV,IMPPT,PWR,VN_bat1,VL5V,VLOAD,VN_bat2,HS_TEMP,EXT_TEMP,VR_bat, BAT_SET,BAT_COMP,ENERGY_LO,VMPPT_APP_SET,REG_SET_PV,REG_SET_VBAT,REG_SET_IMPPT,BEST_PV,BEST_PWR,IMPPT_APP_SET;
int byte_int;

  
stJsonCommand jsonCommandParams[] = {
  {CMD_NUM_SET_MODE,                            CMD_SET_MODE,                   ProcessSetMode,                 EepromSetMode,     SetDefaultOperationMode},
  {CMD_NUM_SET_MOTOR_DIR_MANUAL,                CMD_SET_MOTOR_DIR_MANUAL,       ProcessSetManualDirection,      EepromDataNil,     SetDefaultNil},
  {CMD_NUM_SET_MOTOR_PWM_MANUAL,                CMD_SET_MOTOR_PWM_MANUAL,       ProcessSetMotorPWMManual,       EepromSetMotorPwmManualMode,     SetDefaultPwmManulModeParameter},
  {CMD_NUM_SET_BRUSH_MOTOR_STATE,               CMD_SET_BRUSH_MOTOR_STATE,      ProcessSetBrushMotorState,      EepromSetBrushEnabledState,     SetDefaultBrushEnabledState},
  {CMD_NUM_SET_BRUSH_MOTOR_PWM_MANUAL,          CMD_SET_BRUSH_MOTOR_PWM_MANUAL, ProcessSetBrushPWMManual,       EepromSetBrushPwmManualMode,     SetDefaultBrushPwmNormalModeParameter},
  {CMD_NUM_SET_BRUSH_MOTOR_DIR,                 CMD_SET_BRUSH_MOTOR_DIR,        ProcessSetBrushDirection,       EepromSetBrushMotorPolarity,     SetDefaultBrushMotPolarity},
  {CMD_NUM_SET_MOTOR_PWM_AUTO,                  CMD_SET_MOTOR_PWM_AUTO,         ProcessSetMotorPWMAuto,         EepromSetMotorPwmAutoMode,     SetDefaultPwmCycleAutoModeParameter},
  {CMD_NUM_SET_BRUSH_MOTOR_PWM_AUTO,            CMD_SET_BRUSH_MOTOR_PWM_AUTO,   ProcessSetBrushPWMAuto,         EepromSetBrushPwmAutoMode,     SetDefaultBrushPwmAutoModeParameter},
  {CMD_NUM_SET_AUTO_SCHEDULE_TIME,              CMD_SET_AUTO_SCHEDULE_TIME,     ProcessSetAutoScheduleTime,     EepromSetAutoScheduleTime,     SetDefaultAutoScheduledTime},
  {CMD_NUM_SET_EDGE_SENSE_STATE,                CMD_SET_EDGE_SENSE_STATE,       ProcessSetEdgeSensorState,      EepromSetEdgeSensorState,     SetDefaultEdgeSensorEnabledState},
  {CMD_NUM_SET_RTC_VALUE,                       CMD_SET_RTC_VALUE,              ProcessSetRTCValue,             EepromDataNil,     SetDefaultNil},
  {CMD_NUM_SET_DEVICE_INFO,                     CMD_SET_DEVICE_INFO,            ProcessSetDeviceInfo,           EepromDevIDInfo,     SetDefaultDevIDInfo},
  {CMD_NUM_SET_OVERCURRENT_LIMIT,               CMD_SET_OVERCURRENT_LIMIT,      ProcessSetMotorCurrentLimits,   EepromSetCurrentLimits,     SetDefaultMaxMotCurrentLimits},
  {CMD_NUM_CLEAR_ERRORCODES,                    CMD_CLEAR_ERRORCODES,           ProcessClearErrorCodes,         EepromDataNil,     SetDefaultNil},
  //{CMD_NUM_GET_SOC,                             CMD_GET_SOC,                    ProcessGetSoC,                  EepromDataNil,     SetDefaultNil},
  {CMD_NUM_GET_CHARGER_STATE,                   CMD_GET_CHARGER_STATE,          ProcessGetChargerState,         EepromDataNil,     SetDefaultNil},
  {CMD_NUM_GET_CONTROLLER_STATUS,               CMD_GET_CONTROLLER_STATUS,      ProcessGetErrorStatus,          EepromDataNil,     SetDefaultNil},
  {CMD_NUM_GET_DEVICE_INFO,                     CMD_GET_DEVICE_INFO,            ProcessGetDeviceInfo,           EepromDataNil,     SetDefaultNil},
  {CMD_NUM_GET_CURRENT_MODE,                    CMD_GET_CURRENT_MODE,           ProcessGetCurrentMode,          EepromDataNil,     SetDefaultNil},
  {CMD_NUM_GET_MOTOR_DIR_MANUAL,                CMD_GET_MOTOR_DIR_MANUAL,       ProcessGetMotorDirectionManual, EepromDataNil,     SetDefaultNil},
  {CMD_NUM_GET_MOTOR_PWM_MANUAL,                CMD_GET_MOTOR_PWM_MANUAL,       ProcessGetMotorPWMManual,       EepromDataNil,     SetDefaultNil},
  {CMD_NUM_GET_BRUSH_MOTOR_STATE,               CMD_GET_BRUSH_MOTOR_STATE,      ProcessGetBrushMotorEnabledState,      EepromDataNil,     SetDefaultNil},
  {CMD_NUM_GET_BRUSH_MOTOR_PWM_MANUAL,          CMD_GET_BRUSH_MOTOR_PWM_MANUAL, ProcessGetBrushMotorPWMManual,  EepromDataNil,     SetDefaultNil},
  {CMD_NUM_GET_BRUSH_MOTOR_DIR,                 CMD_GET_BRUSH_MOTOR_DIR,        ProcessGetBrushMotorPolarity,  EepromDataNil,     SetDefaultNil},
  {CMD_NUM_GET_MOTOR_PWM_AUTO,                  CMD_GET_MOTOR_PWM_AUTO,         ProcessGetMotorPWMAuto,         EepromDataNil,     SetDefaultNil},
  {CMD_NUM_GET_BRUSH_MOTOR_PWM_AUTO,            CMD_GET_BRUSH_MOTOR_PWM_AUTO,   ProcessGetBrushMotorPWMAuto,    EepromDataNil,     SetDefaultNil},
  {CMD_NUM_GET_AUTO_SCHEDULE_TIME,              CMD_GET_AUTO_SCHEDULE_TIME,     ProcessGetAutoScheduleTime,     EepromDataNil,     SetDefaultNil},
  {CMD_NUM_GET_EDGE_SENSE_STATE,                CMD_GET_EDGE_SENSE_STATE,       ProcessGetEdgeSenseEnabledState,       EepromDataNil,     SetDefaultNil},
  {CMD_NUM_GET_RTC_VALUE,                       CMD_GET_RTC_VALUE,              ProcessGetRTCValue,             EepromDataNil,     SetDefaultNil},
  {CMD_NUM_GET_CURRENT_STAT,                    CMD_GET_CURRENT_STAT,           ProcessGetCurrentStat,          EepromDataNil,     SetDefaultNil},
  {CMD_NUM_GET_LAST_CYCLE_STAT,                 CMD_GET_LAST_CYCLE_STAT,        ProcessGetLastOperationStat,        EepromDataNil,     SetDefaultNil},
  {CMD_NUM_GET_OVERCURRENT_LIMIT,               CMD_GET_OVERCURRENT_LIMIT,      ProcessGetOverCurrentLimits,    EepromDataNil,     SetDefaultNil},
  {CMD_NUM_GET_MOT_CURRENT_VALUES,              CMD_GET_MOT_CURRENT_VALUES,     ProcessGetMotorCurrentValues,   EepromDataNil,     SetDefaultNil},
  {CMD_NUM_SET_PULSE_COUNT_VALUES,              CMD_SET_PULSE_COUNT_VALUES,     ProcessSetPulseCount,           EepromSetPulseCount,     SetDefaultCountRange},
  {CMD_NUM_SET_LOW_BAT_SOC,                     CMD_SET_LOW_BAT_SOC,            ProcessSetLowBatSoC,            EepromSetLowBatSoC,     SetDefaultMinBatSoc},
  {CMD_NUM_GET_PULSE_COUNT_VALUES,              CMD_GET_PULSE_COUNT_VALUES,     ProcessGetPulseCountValues,     EepromDataNil,     SetDefaultNil},
  {CMD_NUM_GET_LOW_BAT_SOC,                     CMD_GET_LOW_BAT_SOC,            ProcessGetLowBatSoC,            EepromDataNil,     SetDefaultNil},
  {CMD_NUM_SET_ZIGBEE_CONF,                     CMD_SET_ZIGBEE_CONF,            ProcessSetZigbeeConfig,         EepromZigbeeConfiguration,  SetDefaultZigbeeConfig},
  {CMD_NUM_GET_ZIGBEE_CONF,                     CMD_GET_ZIGBEE_CONF,            ProcessGetZigbeeConfig,         EepromDataNil,              SetDefaultNil},
  {CMD_NUM_GET_ZIGBEE_NTW_PARAM,                CMD_GET_ZIGBEE_NTW_PARAM,       ProcessGetZigbeeNetworkParams,  EepromDataNil,              SetDefaultNil},
  {CMD_NUM_RESET_ZIGBEE_NTW,                    CMD_RESET_ZIGBEE_NTW,           ProcessResetZigbeeNetwork,      EepromDataNil,              SetDefaultNil},
  {CMD_NUM_GET_BAT_AND_PV_VAL,                  CMD_GET_BAT_AND_PV_VAL,         ProcessGetBatteryAndPVvalues,   EepromDataNil,              SetDefaultNil},
  {CMD_NUM_RESET_TO_DEFAULTS,                   CMD_RESET_TO_DEFAULTS,          ProcessResetToDefaults,         EepromDataNil,              SetDefaultNil},
  {CMD_NUM_GET_TEMPERATURES,                    CMD_GET_TEMPERATURES,           ProcessGetTemperaturevalues,    EepromDataNil,              SetDefaultNil},  
  {CMD_NUM_SET_MOTOR_FAULT_CONDITION,           CMD_SET_MOTOR_FAULT_CONDITIONS, ProcessSetMotorFaultConditions, EepromSetMotorFaultConditions, SetDefaultIloadConfigValues},  
  {CMD_NUM_GET_MOTOR_FAULT_CONDITION,           CMD_GET_MOTOR_FAULT_CONDITIONS, ProcessGetMotorFaultConditions, EepromDataNil,              SetDefaultNil},
  {CMD_NUM_REQ_ACTIVITY_LOG,                    CMD_REQ_ACTIVITY_LOG,           RequestActivityLog,             EepromDataNil,              SetDefaultNil},
  {CMD_NUM_CLEAR_ACTIVITY_LOG,                  CMD_CLEAR_ACTIVITY_LOG,         ClearActivityLog,               EepromDataNil,              SetDefaultNil},
  {CMD_NUM_SET_PULSE_COUNT_AND_CYCLE,           CMD_SET_PULSE_COUNT_AND_CYCLE,  ProcessSetPulseCountAndCycle,   EepromDataNil,              SetDefaultNil},  
  {CMD_NUM_GET_CURRENT_ROBOT_STATUS,            CMD_GET_CURRENT_ROBOT_STATUS,   ProcessGetCurrentRobotStat,     EepromDataNil,              SetDefaultNil},  
  {CMD_NUM_SET_HEARTBEAT_CONFIG,                CMD_SET_HEARTBEAT_CONFIG,       ProcessSetHeartbeatConfig,      EepromHeartbeatConfiguration,SetDefaultHeartbeatConfig},  
  {CMD_NUM_GET_HEARTBEAT_CONFIG,                CMD_GET_HEARTBEAT_CONFIG,       ProcessGetHeartbeatConfig,      EepromDataNil,              SetDefaultNil},
  {CMD_NUM_SET_LOG_INTERVAL,                    CMD_SET_LOG_INTERVAL,           ProcessSetLogInterval,          EepromSetLogInterval,       SetDefaultLogInterval},      //RT
  {CMD_NUM_GET_LOG_INTERVAL,                    CMD_GET_LOG_INTERVAL,           ProcessGetLogInterval,          EepromDataNil,              SetDefaultNil}, 
  {CMD_NUM_SET_DIA_WHEEL,                       CMD_SET_DIA_WHEEL,              ProcessSetWheelDia,             EepromSetWheelDia,          SetDefaultWheelDia},        
  {CMD_NUM_GET_DIA_WHEEL,                       CMD_GET_DIA_WHEEL,              ProcessGetWheelDia,             EepromDataNil,              SetDefaultNil},
  {CMD_NUM_SET_CYCLE_FREQUENCY,                 CMD_SET_CYCLE_FREQUENCY,        ProcessSetCycleFrequency,       EepromSetCycleFrequency,    SetDefaultCycleFrequency},   
  {CMD_NUM_GET_CYCLE_FREQUENCY,                 CMD_GET_CYCLE_FREQUENCY,        ProcessGetCycleFrequency,       EepromDataNil,              SetDefaultNil},   
  {CMD_NUM_SET_CONTINUE,                        CMD_SET_CONTINUE,               ProcessSetContinue,             EepromSetContinue,          SetDefaultContinue},   
  {CMD_NUM_GET_CONTINUE_COUNT,                  CMD_GET_CONTINUE_COUNT,         ProcessGetContinueCount,        EepromDataNil,              SetDefaultNil},
  {CMD_NUM_SET_EMERGENCY_RETURN,                CMD_SET_RETURN_STATE,           ProcessSetReturnState,          EepromSetReturnState,       SetDefaultReturnState},   
  {CMD_NUM_GET_RETURN_STATE,                    CMD_GET_RETURN_STATE,           ProcessGetReturnState,          EepromDataNil,              SetDefaultNil},
  {CMD_NUM_SET_COM_DISTANCE,                    CMD_SET_COM_DISTANCE,           ProcessSetcomdistance,          EepromSetcomdistance,       SetDefaultcomdistance},   
  {CMD_NUM_GET_COM_DISTANCE,                     CMD_GET_COM_DISTANCE,           ProcessGetcomdistance,          EepromDataNil,              SetDefaultNil},
  {CMD_NUM_REQ_LOG,                             CMD_REQ_LOG,                    RequestLog,                     EepromDataNil,              SetDefaultNil},
  
  {CMD_NUM_SET_N0_ROW_DAY,                      CMD_SET_N0_ROW_DAY,             ProcessSetNoofRowday,           EepromSetNoofRowday,        SetDefaultNoofRowday},   
  {CMD_NUM_GET_N0_ROW_DAY,                      CMD_GET_N0_ROW_DAY,             ProcessGetNoofRowday,           EepromDataNil,              SetDefaultNil},
  {CMD_NUM_SET_ROW_LENGTH_DATA,                 CMD_SET_ROW_LENGTH_DATA,        ProcessSetRowLengthData,        EepromStoreRowLength,       SetDefaultRowLength},
  {CMD_NUM_GET_ROW_LENGTH_DATA,                 CMD_GET_ROW_LENGTH_DATA,        ProcessGetRowLengthData,        EepromDataNil,              SetDefaultNil},
  {CMD_NUM_SET_ROW_LENGTH2_DATA,                CMD_SET_ROW_LENGTH2_DATA,       ProcessSetRowLength2Data,       EepromStoreRowLength2,      SetDefaultRowLength2},
  {CMD_NUM_GET_ROW_LENGTH2_DATA,                CMD_GET_ROW_LENGTH2_DATA,       ProcessGetRowLength2Data,       EepromDataNil,              SetDefaultNil},
  {CMD_NUM_SET_ROW_LENGTH3_DATA,                CMD_SET_ROW_LENGTH3_DATA,       ProcessSetRowLength3Data,       EepromStoreRowLength3,      SetDefaultRowLength3},
  {CMD_NUM_GET_ROW_LENGTH3_DATA,                CMD_GET_ROW_LENGTH3_DATA,       ProcessGetRowLength3Data,       EepromDataNil,              SetDefaultNil},
  {CMD_NUM_SET_ROW_LENGTH4_DATA,                CMD_SET_ROW_LENGTH4_DATA,       ProcessSetRowLength4Data,       EepromStoreRowLength4,      SetDefaultRowLength4},
  {CMD_NUM_GET_ROW_LENGTH4_DATA,                CMD_GET_ROW_LENGTH4_DATA,       ProcessGetRowLength4Data,       EepromDataNil,              SetDefaultNil},
  {CMD_NUM_SET_ROW_LENGTH5_DATA,                CMD_SET_ROW_LENGTH5_DATA,       ProcessSetRowLength5Data,       EepromStoreRowLength5,      SetDefaultRowLength5},
  {CMD_NUM_GET_ROW_LENGTH5_DATA,                CMD_GET_ROW_LENGTH5_DATA,       ProcessGetRowLength5Data,       EepromDataNil,              SetDefaultNil},
  {CMD_NUM_SET_ROW_LENGTH6_DATA,                CMD_SET_ROW_LENGTH6_DATA,       ProcessSetRowLength6Data,       EepromStoreRowLength6,      SetDefaultRowLength6},
  {CMD_NUM_GET_ROW_LENGTH6_DATA,                CMD_GET_ROW_LENGTH6_DATA,       ProcessGetRowLength6Data,       EepromDataNil,              SetDefaultNil},
  {CMD_NUM_SET_ROW_LENGTH7_DATA,                CMD_SET_ROW_LENGTH7_DATA,       ProcessSetRowLength7Data,       EepromStoreRowLength7,      SetDefaultRowLength7},
  {CMD_NUM_GET_ROW_LENGTH7_DATA,                CMD_GET_ROW_LENGTH7_DATA,       ProcessGetRowLength7Data,       EepromDataNil,              SetDefaultNil},
  

};

static eJsonStatus ProcessSetState (const char * jsonString, bool* tempSetBool);
static eJsonStatus ProcessSetMotorState (const char * jsonString, bool* tempSetBool1, bool* tempSetBool2);      
static eJsonStatus ProcessSetSensorsState (const char * jsonString, bool* tempSetBool1, bool* tempSetBool2);    
static eJsonStatus ProcessSetMotorPwm (const char * jsonString, stRobotPwmParam *tempSetPwmParam);
static eJsonStatus ProcessSetBrushPwm (const char * jsonString, stBrushPwmParam *tempSetPwmParam);
static bool ParseHeaderData(uint8_t* tempBuff, uint16_t* headerBufferLength, uint16_t command );
void ClearTxBuff(void);

eJsonStatus motor_error_code;
eJsonStatus linear_error_code;
eJsonStatus edgesense_error_code;
eJsonStatus rotatesense_error_code;

extern char Robot_Error_Count;
extern uint16_t cleaner_in_comm;

void SetReceivedMACAddress(uint64_t macAddr)
{
receivedMACAddr = macAddr;
}

uint64_t GetReceivedMACAddress(void)
{
return receivedMACAddr;
}

static eJsonStatus ProcessSetMode (const char * jsonString)
{
  Serial_Debug("\r\nIn ProcessSetMode->");
  Serial_Debug(jsonString);
  eJsonStatus error_code = JSON_NO_ERROR;
  bool mode ;
  error_code = ProcessSetState(jsonString, &mode);
  if(error_code == JSON_NO_ERROR)
  {
    if(mode == 0)
    {
      SetMotionCommand(ROBOT_CMD_AUTO);
      SetOperationMode(AUTO,MAN_IDLE);
    }
    else if(mode == 1)
    {
      SetMotionCommand(ROBOT_CMD_MANUAL);
      SetOperationMode(MANUAL,MAN_IDLE);
    }
    Serial_Debug("\r\nMode set as ");
    Serial_Debug_Num(mode);
    Serial_Debug("\r\n0->AUTO, 1->MANUAL ");
  }
  return error_code;
}

static eJsonStatus ProcessSetManualDirection (const char * jsonString)
{
  char Trackchanger_Error;
  Serial_Debug("\r\nIn ProcessSetManualDirection->");
  Serial_Debug(jsonString); 
  eJsonStatus error_code = JSON_NO_ERROR;
  uint8_t mode;
  char *setStateStr[JSON_NO_OF_MODE_STATE_DATA];
  uint8_t maxNoStrings=(sizeof setStateStr)/4;
  uint8_t totalResultStringCount =  SplitString (jsonString, setStateStr, ',',maxNoStrings); 
  Serial_Debug("\nstate Values :");
  for(uint8_t dispcount = 0; dispcount < totalResultStringCount; dispcount++)
  {
    Serial_Debug(setStateStr[dispcount]);
    Serial_Debug(",");
  }
  if(totalResultStringCount == JSON_NO_OF_MODE_STATE_DATA)
  {
    bool status = true;
    status &= SetParameterValue_int(setStateStr[0], &mode, IsManualCommandValid);
    
    stContinue *setContinueValue = GetSetContinueLimits();
    stReturn *setReturnValue = GetSetReturnLimits();
    Trackchanger_Error = setReturnValue->Return1;
    
    EepromHeartbeatConfiguration(EEPROM_READ);
      
    if(status == false)
    {
      error_code = JSON_DATA_OUT_OF_RANGE;
      Serial_Debug("\n Manual Mode SetValue/s Out of Range");
    }
    else if(setContinueValue->Continue1 != 2)
    {
      SetResumeBit(0); 
      switch(mode)
      {
      case 1 : 
      SetCycleModeState(CYCLE_COMPLETED);
      SetMotionPauseState(PA_IDLE);
      ClearRoboterror();
      Cumulative_distance = 0;
      SetMotionCommand(ROBOT_CMD_POSITIVE);
      break;
      case 2 : 
      SetCycleModeState(CYCLE_COMPLETED);
      SetMotionPauseState(PA_IDLE);
      ClearRoboterror();
      Cumulative_distance = 0;
      SetMotionCommand(ROBOT_CMD_NEGATIVE); 
      break;
      case 3 : 
      SetCycleModeState(CYCLE_COMPLETED);
      SetMotionPauseState(PA_IDLE);
      ClearRoboterror();
      Cumulative_distance = 0;
      SetMotionCommand(ROBOT_CMD_CYCLE);
      SetCycleModeState(CYCLE_START);   
      SCHEDULE_LOG = 1;
      break;
      case 4 : SetMotionCommand(ROBOT_CMD_NORMAL_STOP);
      break;
      case 5 : SetMotionCommand(ROBOT_CMD_STOP);
      break;
      case 6 : //SetResumeBit(1);
       ClearAllFaults();
       ClearRoboterror();
      break;
      case 7:
       Robot_Error_Count = ++Trackchanger_Error;
       SetMotionPauseState(PA_PAUSE);
      break;
      default:
        break;
      }
      error_code = JSON_NO_ERROR;
      Serial_Debug("\n Manual Mode SetValue : ");
      Serial_Debug_Num(mode);
      Serial_Debug("\r\n0->POSITIVE, 1->NEGATIVE, 2->CYCLE, 3-> NORMAL_STOP, 4-> EM_STOP");
    }  
      error_code = JSON_NO_ERROR;
      Serial_Debug("\n Manual Mode SetValue : ");
      Serial_Debug_Num(mode);
      Serial_Debug("\r\n0->POSITIVE, 1->NEGATIVE, 2->CYCLE, 3-> NORMAL_STOP, 4-> EM_STOP");          
  }
  else
  {
    Serial_Debug("\n Manual Mode SetValue/s Invalid");
    error_code = JSON_INVALID_DATA;
  }
  return error_code;
}

static eJsonStatus ProcessSetMotorPWMManual (const char * jsonString)
{
  Serial_Debug("\r\nIn ProcessSetMotorPWMManual->");
  Serial_Debug(jsonString); 
  eJsonStatus error_code = JSON_NO_ERROR;
  stRobotPwmParam* setPWMParams;
  stRobotPwmParam* setPWMCycleParams;
  setPWMParams = GetSetManualPwmParameters();
  setPWMCycleParams = GetSetCycleManualPwmParameters();
  stRobotPwmParam tempSetPWMParams = *setPWMParams;
  //stRobotPwmParam tempSetPWMCycleParams = *setPWMCycleParams;
  error_code = ProcessSetMotorPwm(jsonString,&tempSetPWMParams);
  //error_code = ProcessSetMotorPwm(jsonString,&tempSetPWMCycleParams);
  if(error_code == JSON_NO_ERROR)
  {
    *setPWMParams = tempSetPWMParams;
    *setPWMCycleParams = tempSetPWMParams;
    char dispstring [100];
    snprintf(dispstring, sizeof dispstring, "\nPwm Manual Mode SetValues: %d, %d, %d, %d, %d, %d, %d, %d, %d, %d",
             setPWMParams->accelTime, setPWMParams->decelTime,setPWMParams->acelStartCountDiff,setPWMParams->accelapproachPwm1, setPWMParams->accelapproachPwm2, setPWMParams->steadyPwm1, setPWMParams->steadyPwm2,
             setPWMParams->approachPwm1, setPWMParams->approachPwm2,setPWMParams->decelStartCountDiff);
    Serial_Debug(dispstring);
  }
  return error_code;
}


static eJsonStatus ProcessSetBrushMotorState (const char * jsonString)
{
  Serial_Debug("\r\nIn ProcessSetBrushMotorState->");
  Serial_Debug(jsonString); 
  eJsonStatus error_code = JSON_NO_ERROR;
  bool mode1,mode2;
  ProcessSetMotorState(jsonString, &mode1, &mode2);
  if(motor_error_code == JSON_NO_ERROR)
  {
    Serial_Debug("\r\nBrush motor state set as ");
    Serial_Debug_Num(mode1);
    bool *brushEnState = GetSetBrushEnabledState();
    *brushEnState = mode1;
  }
  else
    error_code = JSON_DATA_OUT_OF_RANGE;
  
  if(linear_error_code == JSON_NO_ERROR)
  {
    Serial_Debug("\r\nLinear motor state set as ");
    Serial_Debug_Num(mode2);
    bool *LinearEnState = GetSetLinearEnabledState();
    *LinearEnState = mode2;
  }
  else
    error_code = JSON_DATA_OUT_OF_RANGE;
  
  return error_code;
}

static eJsonStatus ProcessSetBrushPWMManual (const char * jsonString)
{
  Serial_Debug("\r\nIn ProcessSetMotorPWMManual->");
  Serial_Debug(jsonString); 
  eJsonStatus error_code = JSON_NO_ERROR;
  stBrushPwmParam* setBrushParams;
  setBrushParams = GetSetBrushNormalPwmParameters();
  stBrushPwmParam tempSetBrushParams = *setBrushParams;
  error_code = ProcessSetBrushPwm(jsonString,&tempSetBrushParams);
  if(error_code == JSON_NO_ERROR)
  {
    *setBrushParams = tempSetBrushParams;
    char dispstring [100];
    snprintf(dispstring, sizeof dispstring, "\nBrush Pwm Manual Mode SetValues: %d, %d, %d, %d",
    setBrushParams->accelTime, setBrushParams->decelTime, setBrushParams->steadyPwm, setBrushParams->brushTime);
    Serial_Debug(dispstring);
  }
  return error_code;
  
}

static eJsonStatus ProcessSetBrushDirection (const char * jsonString)
{
  Serial_Debug("\r\nIn ProcessSetBrushDirection->");
  Serial_Debug(jsonString); 
  eJsonStatus error_code = JSON_NO_ERROR;
  bool mode;
  error_code = ProcessSetState(jsonString, &mode);
  if(error_code == JSON_NO_ERROR)
  {
    Serial_Debug("\r\nBrush motor direction set as ");
    Serial_Debug_Num(mode);
    stBrushMotPolarity *motPolarity = GetSetBrushMotPolarity();
    motPolarity->mot1Polarity = mode;
  }
  return error_code;
}

static eJsonStatus ProcessSetMotorPWMAuto (const char * jsonString)
{
  Serial_Debug("\r\nIn ProcessSetMotorPWMAuto->");
  Serial_Debug(jsonString); 
  eJsonStatus error_code = JSON_NO_ERROR;
  stRobotPwmParam* setPWMParams;
  setPWMParams = GetSetCycleAutoPwmParameters();
  stRobotPwmParam tempSetPWMParams = *setPWMParams;
  error_code = ProcessSetMotorPwm(jsonString,&tempSetPWMParams);
  if(error_code == JSON_NO_ERROR)
  {
    *setPWMParams = tempSetPWMParams;
    char dispstring [100];
   snprintf(dispstring, sizeof dispstring, "\nPwm Manual Mode SetValues: %d, %d, %d, %d, %d, %d, %d, %d, %d, %d ,%d ,%d",
             setPWMParams->accelTime, setPWMParams->decelTime,setPWMParams->acelStartCountDiff,setPWMParams->accelapproachPwm1, setPWMParams->accelapproachPwm2, setPWMParams->steadyPwm1, setPWMParams->steadyPwm2,
             setPWMParams->approachPwm1, setPWMParams->approachPwm2,setPWMParams->decelStartCountDiff,setPWMParams->timePwm,CYCLEROTATIONTIME);
    Serial_Debug(dispstring);
  }
  return error_code;
}


static eJsonStatus ProcessSetBrushPWMAuto (const char * jsonString)
{
  Serial_Debug("\r\nIn ProcessSetBrushPWMAuto->");
  Serial_Debug(jsonString); 
  eJsonStatus error_code = JSON_NO_ERROR;
  stBrushPwmParam* setBrushParams;
  setBrushParams = GetSetBrushAutoPwmParameters();
  stBrushPwmParam tempSetBrushParams = *setBrushParams;
  error_code = ProcessSetBrushPwm(jsonString,&tempSetBrushParams);
  if(error_code == JSON_NO_ERROR)
  {
    *setBrushParams = tempSetBrushParams;
    char dispstring [100];
    snprintf(dispstring, sizeof dispstring, "\nBrush Pwm Auto Mode SetValues: %d, %d, %d, %d",
    setBrushParams->accelTime, setBrushParams->decelTime, setBrushParams->steadyPwm, setBrushParams->brushTime);
    
    //brushMotorStopDeadTime_ms = (setBrushParams->brushTime)*1000;
    
    Serial_Debug(dispstring);
  }
  return error_code;
}

//static eJsonStatus ProcessSetAutoScheduleTime (const char * jsonString)
//{
//  Serial_Debug("\r\nIn ProcessSetAutoScheduleTime->");
//  Serial_Debug(jsonString); 
//  eJsonStatus error_code = JSON_NO_ERROR;
//  char* autoScheduleStr[JSON_NO_OF_MODE_STATE_DATA];       //changed
//  uint8_t maxNoStrings=(sizeof autoScheduleStr)/4;
//  uint8_t totalResultStringCount =  SplitString (jsonString, autoScheduleStr, ',',maxNoStrings);
//  Serial_Debug("\nAuto schedule Set Received Values :");
//  for(uint8_t dispcount = 0; dispcount < totalResultStringCount; dispcount++)
//  {
//    Serial_Debug(autoScheduleStr[dispcount]);
//    Serial_Debug(",");
//  }
//  if((totalResultStringCount == JSON_NO_OF_MODE_STATE_DATA)&&(strlen(autoScheduleStr[0])==4)) //changed
//  {
//    uint8_t hour = 0;
//    uint8_t minute = 0;
//    hour = (autoScheduleStr[0][1] - 48)+((autoScheduleStr[0][0] - 48)*10);
//    minute = (autoScheduleStr[0][3] - 48)+((autoScheduleStr[0][2] - 48)*10);
//    Serial_Debug("\r\nHour-->");
//    Serial_Debug_Num(hour);
//    Serial_Debug("\r\nMinute-->");
//    Serial_Debug_Num(minute);
//    if((hour<24)&&(minute<60))
//    {
//      stScheduleTime setScheduleTime;
//      setScheduleTime.hour = hour;
//      setScheduleTime.minute = minute;
//      ClearAutoDoneSeconds();
//      SetScheduleTime(&setScheduleTime);
//      error_code = JSON_NO_ERROR;
//      Serial_Debug("\n Auto time SetValue/s Set"); 
//    }
//    else
//    {
//      error_code = JSON_DATA_OUT_OF_RANGE;
//      Serial_Debug("\n Auto time SetValue/s Out of Range");    
//    }
//  }
//  else
//  {
//    Serial_Debug("\n Auto time SetValue/s Invalid");
//    error_code = JSON_INVALID_DATA;
//  }
//  return error_code;
//}

//RT
static eJsonStatus ProcessSetAutoScheduleTime (const char * jsonString)
{
  Serial_Debug("\r\nIn ProcessSetAutoScheduleTime->");
  Serial_Debug(jsonString); 
  eJsonStatus error_code = JSON_NO_ERROR;
  Autoschcountval = Autoschcountval + 1;
  
  //char* autoScheduleStr[JSON_NO_OF_MODE_STATE_DATA];
  char* autoScheduleStr[JSON_NO_AUTOSCH];
  
  uint8_t maxNoStrings=(sizeof autoScheduleStr)/4;
  
  uint8_t totalResultStringCount =  SplitString (jsonString, autoScheduleStr, ',',maxNoStrings);
  Serial_Debug("\nAuto schedule Set Received Values :");
  for(uint8_t dispcount = 0; dispcount < totalResultStringCount; dispcount++)
  {
    Serial_Debug(autoScheduleStr[dispcount]);
    Serial_Debug(",");
  }
  if(totalResultStringCount == JSON_NO_AUTOSCH)
  {
      ClearAutoDoneSeconds();
     for (int i=0;i<JSON_NO_AUTOSCH-1;i++)
     {
      uint8_t hour = 0;
      uint8_t minute = 0;
      hour = (autoScheduleStr[i][1] - 48)+((autoScheduleStr[i][0] - 48)*10);
      minute = (autoScheduleStr[i][3] - 48)+((autoScheduleStr[i][2] - 48)*10);
      
      Serial_Debug("\r\nHour-->");
      Serial_Debug_Num(hour);
      Serial_Debug("\r\nMinute-->");
      Serial_Debug_Num(minute);
      if((hour<24)&&(minute<60))
      {
        stScheduleTime setScheduleTime;
        setScheduleTime.HOUR[i] = hour;
        setScheduleTime.MINUTE[i] = minute;
        ClearAutoDoneSeconds();
        SetScheduleTime(&setScheduleTime);
        error_code = JSON_NO_ERROR;
        Serial_Debug("\n Auto time SetValue/s Set"); 
      }
      else
      {
        error_code = JSON_DATA_OUT_OF_RANGE;
        Serial_Debug("\n Auto time SetValue/s Out of Range");    
      } 
    }  
  }
    else
    {
      Serial_Debug("\n Auto time SetValue/s Invalid");
      error_code = JSON_INVALID_DATA;
    } 
  return error_code;
}


static eJsonStatus ProcessSetEdgeSensorState (const char * jsonString)
{
  Serial_Debug("\r\nIn ProcessSetEdgeSensorState->");
  Serial_Debug(jsonString); 
  eJsonStatus error_code = JSON_NO_ERROR;
  bool mode1,mode2;
  ProcessSetSensorsState(jsonString, &mode1, &mode2);
  if(edgesense_error_code == JSON_NO_ERROR)
  {
    Serial_Debug("\r\nEdge sensor state set as ");
    Serial_Debug_Num(mode1);
    bool * edgeSensorState = GetSetEdgeSensorEnabledState();
    * edgeSensorState = mode1;
  }
  else
  {
    error_code = JSON_INVALID_DATA;
  }
  if(rotatesense_error_code == JSON_NO_ERROR)
  {
    Serial_Debug("\r\nRotate sensor state set as ");
    Serial_Debug_Num(mode2);
    bool * rotateSensorState = GetSetRotateSensorEnabledState();
    * rotateSensorState = mode2;
  }
  else
  {
    error_code = JSON_INVALID_DATA;
  }
  return error_code;
}

static eJsonStatus ProcessSetRTCValue (const char * jsonString)
{
  Serial_Debug("\r\nIn ProcessSetRTCValue->");
  Serial_Debug(jsonString); 
  eJsonStatus error_code = JSON_NO_ERROR;
  char* setRTCValueStr[JSON_NO_OF_RTC_DATA];
  uint8_t maxNoStrings=(sizeof setRTCValueStr)/4;
  uint8_t totalResultStringCount =  SplitString (jsonString, setRTCValueStr, ',',maxNoStrings);
  Serial_Debug("\nAuto schedule Set Received Values :");
  for(uint8_t dispcount = 0; dispcount < totalResultStringCount; dispcount++)
  {
    Serial_Debug(setRTCValueStr[dispcount]);
    Serial_Debug(",");
  }
  
  sDateTime apisec;
  
  apisec.year = atoi(setRTCValueStr[2]);
  apisec.month = atoi(setRTCValueStr[1]);
  apisec.date = atoi(setRTCValueStr[0]);
  apisec.hour = atoi(setRTCValueStr[3]);
  apisec.minute = atoi(setRTCValueStr[4]);
  apisec.second = atoi(setRTCValueStr[5]);
  
  uint32_t IST_to_Sec = ConvertRTCDatetimeToSeconds(&apisec);

  
  if(totalResultStringCount == JSON_NO_OF_RTC_DATA)
  {
//    uint32_t time = strtol(setRTCValueStr[0],NULL,10);
    uint32_t time = IST_to_Sec;
    if(time >= JAN_2000_START_SECONDS && time <= DEC_2099_END_SECONDS)
    {
      char getTime_str[40];
      sDateTime setTime;
      ConvertRTCSecondsToDatetime(time,&setTime);
      ConvertRTCDateTimeToString(&setTime, getTime_str, sizeof getTime_str);
      Serial_Debug(getTime_str);
      if(SetRTCDateTime(&setTime))
      {
        ClearAutoDoneSeconds();
        ClearFault(RTC_FAULT);
        error_code = JSON_NO_ERROR;
        Serial_Debug("\n RTC SetValue/s Set");
      } 
      else
      {
        
        Serial_Debug("\n RTC  SetValue/s Invalid");
        error_code = JSON_INVALID_DATA;  
      }
    }
    else
    {
      error_code = JSON_DATA_OUT_OF_RANGE;
      Serial_Debug("\n RTC SetValue/s Out of Range");    
    }
  }
  else
  {
    Serial_Debug("\n RTC  SetValue/s Invalid");
    error_code = JSON_INVALID_DATA;  
  }
  return error_code;
}

static eJsonStatus ProcessSetDeviceInfo (const char * jsonString)
{
  Serial_Debug("\r\nIn ProcessSetDeviceInfo->");
  Serial_Debug(jsonString); 
  eJsonStatus error_code = JSON_NO_ERROR;
  char* devIDInfoStr[JSON_NO_OF_SET_DEVICE_INFO];
  uint8_t maxNoStrings=(sizeof devIDInfoStr)/4;
  uint8_t totalResultStringCount =  SplitString (jsonString, devIDInfoStr, ',',maxNoStrings);
  Serial_Debug("\nDevice Info Set Received Values :");
  for(uint8_t dispcount = 0; dispcount < totalResultStringCount; dispcount++)
  {
    Serial_Debug(devIDInfoStr[dispcount]);
    Serial_Debug(",");
  }
  if(totalResultStringCount == JSON_NO_OF_SET_DEVICE_INFO)
  {
    stDevInfo *devIDInfoValues = GetSetDeviceIDInfo();
    if(strlen(devIDInfoStr[0]) != 0)
    {
      snprintf(devIDInfoValues->devID, MAX_DEV_INFO_FIELD_LEN, devIDInfoStr[0]);
    }
    if(strlen(devIDInfoStr[1]) != 0)
    {
      snprintf(devIDInfoValues->hwVersion, MAX_DEV_INFO_FIELD_LEN, devIDInfoStr[1]);
    }
    if(strlen(devIDInfoStr[2]) != 0)
    {
      snprintf(devIDInfoValues->serialNo, MAX_DEV_INFO_FIELD_LEN, devIDInfoStr[2]);
    }
    Serial_Debug("\n Device Info SetValue/s Set");
    error_code = JSON_NO_ERROR;
  }
  else
  {
    Serial_Debug("\n Device info SetValue/s Invalid");
    error_code = JSON_INVALID_DATA;   
  }
  return error_code;
}

static eJsonStatus ProcessSetMotorCurrentLimits (const char * jsonString)
{
  Serial_Debug("\r\nIn ProcessSetMotorCurrentLimits->");
  Serial_Debug(jsonString); 
  eJsonStatus error_code = JSON_NO_ERROR;
  stMaxMotorCurrent* setMotorcurrent = GetSetMaxMotorCurrentLimits();
  stMaxMotorCurrent tempSetMotorCurrent = *setMotorcurrent;
  char *MotorCurrentLimitStr[JSON_NO_OF_CURRENT_LIMIT];
  uint8_t maxNoStrings=(sizeof MotorCurrentLimitStr)/4;
  uint8_t totalResultStringCount =  SplitString (jsonString, MotorCurrentLimitStr, ',',maxNoStrings);
  Serial_Debug("\nPWM Set Received Values :");
  for(uint8_t dispcount = 0; dispcount < totalResultStringCount; dispcount++)
  {
    Serial_Debug(MotorCurrentLimitStr[dispcount]);
    Serial_Debug(",");
  }  
  if(totalResultStringCount == JSON_NO_OF_CURRENT_LIMIT)
  {
    bool status = true;
    status &= SetParameterValue_float(MotorCurrentLimitStr[0], &(tempSetMotorCurrent.Imot1), IsMotorCurrentLimitValid);
    status &= SetParameterValue_float(MotorCurrentLimitStr[1], &(tempSetMotorCurrent.Imot2) , IsMotorCurrentLimitValid);
    status &= SetParameterValue_float(MotorCurrentLimitStr[2], &(tempSetMotorCurrent.Imot3), IsMotorCurrentLimitValid);
    
    if(status == false)
    {
      error_code = JSON_DATA_OUT_OF_RANGE;
      Serial_Debug("\n IMOT current limit SetValue/s Out of Range");
    }
    else
    {
      error_code = JSON_NO_ERROR;
      Serial_Debug("\n IMOT current limit SetValue/s set : ");
      *setMotorcurrent = tempSetMotorCurrent;
      
      Serial_Debug_Float(setMotorcurrent->Imot1,3);
      Serial_Debug(" ,");
      Serial_Debug_Float(setMotorcurrent->Imot2,3);
      Serial_Debug(" ,");
      Serial_Debug_Float(setMotorcurrent->Imot3,3);
    }            
  }
  else
  {
    Serial_Debug("\n IMOT current limit SetValue/s Invalid");
    error_code = JSON_INVALID_DATA;
  }
  return error_code;
}


static eJsonStatus ProcessClearErrorCodes (const char * jsonString)
{
  Serial_Debug("\r\nIn ProcessClearErrorCodes->");
  Serial_Debug(jsonString); 
  eJsonStatus error_code = JSON_NO_ERROR;
  char* clearErrorCodeStr[JSON_NO_OF_ERROR_CODE_DATA];
  uint8_t maxNoStrings=(sizeof clearErrorCodeStr)/4;
  uint8_t totalResultStringCount =  SplitString (jsonString, clearErrorCodeStr, ',',maxNoStrings);
  Serial_Debug("\nClear Error code Received Values :");
  for(uint8_t dispcount = 0; dispcount < totalResultStringCount; dispcount++)
  {
    Serial_Debug(clearErrorCodeStr[dispcount]);
    Serial_Debug(",");
  }
  if(totalResultStringCount == JSON_NO_OF_ERROR_CODE_DATA)
  {
    error_code = JSON_NO_ERROR;
    Serial_Debug("\n Clear Error code SetValue/s Set");
    Serial_Debug_Num(strtol(clearErrorCodeStr[0],NULL,16));
    bool isRTCfault = IsRTCFault();
    
    if(GetMotorFaultCode() == 2048)
    {
      stHeartbeatConfig *defaultHeartbeatConfig = GetSetHeartbeatConfig();
      defaultHeartbeatConfig->enable = 0;
    }
    
    ClearAllFaults();
    ClearRoboterror();
    if(isRTCfault)
    {
      SetFault(RTC_FAULT);
    }
  }
  else
  {
    Serial_Debug("\n Clear Error code SetValue/s Invalid");
    error_code = JSON_INVALID_DATA;   
  }
  return error_code;
}


static eJsonStatus ProcessSetLowBatSoC (const char * jsonString)
{
  Serial_Debug("\r\nIn ProcessSetLowBatSoC->");
  Serial_Debug(jsonString); 
  eJsonStatus error_code = JSON_NO_ERROR;
  char* setLowBatSoCValueStr[JSON_NO_OF_SOC_DATA];
  uint8_t maxNoStrings=(sizeof setLowBatSoCValueStr)/4;  
  uint8_t* setLowBatSoC = GetSetMinBattSoc();
  uint8_t tempSetLowBatSoC = *setLowBatSoC;
  uint8_t totalResultStringCount =  SplitString (jsonString, setLowBatSoCValueStr, ',',maxNoStrings);
  Serial_Debug("\nLow Battery Set Received Values :");
  for(uint8_t dispcount = 0; dispcount < totalResultStringCount; dispcount++)
  {
    Serial_Debug(setLowBatSoCValueStr[dispcount]);
    Serial_Debug(",");
  }
  if(totalResultStringCount == JSON_NO_OF_SOC_DATA)
  {
    bool status = true;
    status &= SetParameterValue_int(setLowBatSoCValueStr[0], &(tempSetLowBatSoC), IsLowBatSoCValid);
    if(status == false)
    {
      error_code = JSON_DATA_OUT_OF_RANGE;
      Serial_Debug("\n Low Bat limit SetValue/s Out of Range");
    }
    else
    {
      error_code = JSON_NO_ERROR;
      *setLowBatSoC = tempSetLowBatSoC;
      Serial_Debug("\n Low Bat SoC SetValue/s Set");
      Serial_Debug_Num(*setLowBatSoC);
    } 
  }
  else
  {
    Serial_Debug("\n Low Bat SoC SetValue/s Invalid");
    error_code = JSON_INVALID_DATA;   
  }
  return error_code;
}


static eJsonStatus ProcessSetPulseCount (const char * jsonString)
{
  Serial_Debug("\r\nIn ProcessSetPulseCount->");
  Serial_Debug(jsonString); 
  eJsonStatus error_code = JSON_NO_ERROR;
  stCountRange* setCountValues;
  setCountValues = GetSetCountRange();
  stCountRange tempSetCountValues = *setCountValues;
  char *PulseCountStr[JSON_NO_OF_PULSE_COUNT_DATA];
  uint8_t maxNoStrings=(sizeof PulseCountStr)/4;
  uint8_t totalResultStringCount =  SplitString (jsonString, PulseCountStr, ',',maxNoStrings);
  Serial_Debug("\nPulse Count Set Received Values :");
  for(uint8_t dispcount = 0; dispcount < totalResultStringCount; dispcount++)
  {
    Serial_Debug(PulseCountStr[dispcount]);
    Serial_Debug(",");
  }  
  if(totalResultStringCount == JSON_NO_OF_PULSE_COUNT_DATA)
  {
    bool status = true;
    
    pulse_flag = 1;
    
    posdistance = atof(PulseCountStr[0]);
    negdistance = atof(PulseCountStr[1]);
    
    posdistance_int = atoi(PulseCountStr[0]);                  //change
    negdistance_int = atoi(PulseCountStr[1]);                  //change
    
    PulseCalculation();
      
//    posdistance = atof(PulseCountStr[0]);
//    negdistance = atof(PulseCountStr[1]);
//    
//    distance =  (circumference * P);
//    
//    pos = (float) ((float) posdistance /(float) distance);
//    neg = (float) ((float) negdistance /(float) distance);
//    Serial_Debug("\r\nIn Pulsecalc->");
//    
//    posdistance_int = atoi(PulseCountStr[0]);                  //change
//    negdistance_int = atoi(PulseCountStr[1]);                  //change
//    
//    char POS[20];
//    char NEG[20];
//    
//    
//    forward_remaining_distance = (posdistance_int % distance);         //change
//    backward_remaining_distance = (negdistance_int % distance);        //change
//    
//    ftoa(pos, POS, 0); 
//    ftoa(neg, NEG, 0);
   
    Serial_Debug("\r\nIn Pulsecalc->");
    
    status &= SetParameterValue_int(POS, &(tempSetCountValues.maxPosCountForPVsetup), IsPulseCountValid);
    status &= SetParameterValue_int(NEG, &(tempSetCountValues.maxNegCountForPVsetup) , IsPulseCountValid);
    
    if(status == false)
    {
      error_code = JSON_DATA_OUT_OF_RANGE;
      Serial_Debug("\n Pulse Count SetValue/s Out of Range");
    }
    else
    {
      error_code = JSON_NO_ERROR;
      Serial_Debug("\n Pulse Count SetValue/s set : ");
      *setCountValues = tempSetCountValues;
      
      Serial_Debug_Num(setCountValues->maxPosCountForPVsetup);
      Serial_Debug(" ,");
      Serial_Debug_Num(setCountValues->maxNegCountForPVsetup);
    }            
  }
  else
  {
    Serial_Debug("\n Pulse Count SetValue/s Invalid");
    error_code = JSON_INVALID_DATA;
  }
  return error_code;
}
static eJsonStatus ProcessSetPulseCountAndCycle (const char * jsonString)
{
  Serial_Debug("\r\nIn ProcessSetPulseCountAndCycle->");
  Serial_Debug(jsonString); 
  eJsonStatus error_code = JSON_NO_ERROR;
  stCountRange* setCountValues;
  setCountValues = GetSetCountRange();
  stCountRange tempSetCountValues = *setCountValues;
  char *PulseCountStr[JSON_NO_OF_PULSE_CYCLE_COUNT_DATA];
  uint8_t maxNoStrings=(sizeof PulseCountStr)/4;
  uint8_t totalResultStringCount =  SplitString (jsonString, PulseCountStr, ',',maxNoStrings);
  Serial_Debug("\nPulse Count Set Received Values :");
  for(uint8_t dispcount = 0; dispcount < totalResultStringCount; dispcount++)
  {
    Serial_Debug(PulseCountStr[dispcount]);
    Serial_Debug(",");
  }  
  if(totalResultStringCount == JSON_NO_OF_PULSE_CYCLE_COUNT_DATA)
  {
    bool status = true;
    
    pulse_flag = 4;
    
    track_no = atoi(PulseCountStr[2]);
    day_count= atoi(PulseCountStr[3]);
    cleaner_in_comm = 1;
    
  stHeartbeatConfig* storeHeartbeatConfig = GetSetHeartbeatConfig();
  storeHeartbeatConfig->enable = 1;
    
      Cumulative_distance = 0;  
    
    CpositiveDistance = atof(PulseCountStr[0]);
    CpositiveDistance = CpositiveDistance*1000; 
    CnegativeDistance = atof(PulseCountStr[1]);
    CnegativeDistance = CnegativeDistance*1000;
    CnegativeDistance = CnegativeDistance+300;
    
    CpositiveDistance_int = atoi(PulseCountStr[0]); 
    CpositiveDistance_int = CpositiveDistance_int*1000;
    CnegativeDistance_int = atoi(PulseCountStr[1]); 
    CnegativeDistance_int = CnegativeDistance_int*1000;
    CnegativeDistance_int = CnegativeDistance_int+300;
    
    PulseCalculation();
    
    
    status &= SetParameterValue_int(Cpospulse, &(tempSetCountValues.maxPosCountForPVsetup), IsPulseCountValid);
    status &= SetParameterValue_int(Cnegpulse, &(tempSetCountValues.maxNegCountForPVsetup) , IsPulseCountValid);  
    
//    status &= SetParameterValue_int(PulseCountStr[0], &(tempSetCountValues.maxPosCountForPVsetup), IsPulseCountValid);
//    status &= SetParameterValue_int(PulseCountStr[1], &(tempSetCountValues.maxNegCountForPVsetup) , IsPulseCountValid);
    
    if(status == false)
    {
      error_code = JSON_DATA_OUT_OF_RANGE;
      Serial_Debug("\n Pulse Count And Cycle SetValue/s Out of Range");
    }
    else
    {
      error_code = JSON_NO_ERROR;
      Serial_Debug("\n Pulse Count And Cycle SetValue/s set : ");
      *setCountValues = tempSetCountValues;
      if((GetManualState()==MAN_STOP)||(GetManualState()==MAN_NORMAL_STOP))
      {
      SetCycleModeState(CYCLE_COMPLETED);
      } 
      SetMotionPauseState(PA_IDLE);
      ClearRoboterror();
      SetCycleModeState(CYCLE_COMPLETED);
      SetMotionCommand(ROBOT_CMD_CYCLE);
      SCHEDULE_LOG = 1;  
      Serial_Debug_Num(setCountValues->maxPosCountForPVsetup);
      Serial_Debug(" ,");
      Serial_Debug_Num(setCountValues->maxNegCountForPVsetup);
    }            
  }
  else
  {
    Serial_Debug("\n Pulse Count And Cycle SetValue/s Invalid");
    error_code = JSON_INVALID_DATA;
  }
  return error_code;
}

static eJsonStatus ProcessSetHeartbeatConfig (const char * jsonString)
{
  Serial_Debug("\r\nIn ProcessSetHeartbeatConfig->");
  Serial_Debug(jsonString); 
  Serial_Debug(jsonString);
  eJsonStatus error_code = JSON_NO_ERROR;
    char *heartbeatConfigStr[JSON_NO_OF_HEARTBEAT_CONFIG_PARAMETERS];
    uint8_t maxNoStrings=(sizeof heartbeatConfigStr)/4;
    uint8_t totalResulStringCount =  SplitString (jsonString, heartbeatConfigStr, ',', maxNoStrings );
    Serial_Debug("\nHeartbeat Config Parameters Received Values :");
    for(uint8_t dispcount = 0; dispcount < totalResulStringCount; dispcount++)
    {
      Serial_Debug(heartbeatConfigStr[dispcount]);
      Serial_Debug(",");
    }
    if(totalResulStringCount == JSON_NO_OF_HEARTBEAT_CONFIG_PARAMETERS)
    {
      stHeartbeatConfig tempSetHeartbeatConfig;
      stHeartbeatConfig* setHeartbeatConfig;
      setHeartbeatConfig = GetSetHeartbeatConfig();
      tempSetHeartbeatConfig = *setHeartbeatConfig;
      bool status = true;
      status &= SetParameterValue_bool(heartbeatConfigStr[0], &(tempSetHeartbeatConfig.enable), IsHeartBeatStateValid);
      status &= SetParameterValue_int(heartbeatConfigStr[1], &(tempSetHeartbeatConfig.interval_ms) , IsHeartBeatIntervalValid);
      status &= SetParameterValue_int(heartbeatConfigStr[2], &(tempSetHeartbeatConfig.noOfMessages) , IsNoOfHeartBeatMsgValid);
      status &= SetParameterValue_int(heartbeatConfigStr[3], &(tempSetHeartbeatConfig.maxReconnectTime) , IsMaxReconnectTimeValid);
      
      if(status == false)
      {
        Serial_Debug("\nHeartbeat Config Parameters SetValue/s: Out of Range");
        error_code = JSON_DATA_OUT_OF_RANGE;
      }
      else
      {
        Serial_Debug("\nHeartbeat Config Parameters Set");
        *setHeartbeatConfig = tempSetHeartbeatConfig;
        error_code = JSON_NO_ERROR;
        Serial_Debug("\nHear Beat Parameters SetValues: ");
        Serial_Debug_Num(setHeartbeatConfig->enable);
        Serial_Debug(", ");
        Serial_Debug_Num(setHeartbeatConfig->interval_ms);
        Serial_Debug(", ");
        Serial_Debug_Num(setHeartbeatConfig->noOfMessages);
        Serial_Debug(", ");
        Serial_Debug_Num(setHeartbeatConfig->maxReconnectTime);
        if(setHeartbeatConfig->enable)
        {
        RestartCommTimer();
        }
      } 
    }
    else
    {
      Serial_Debug("\nHeartbeat Config Parameters SetValue/s : Invalid Data");
      error_code = JSON_INVALID_DATA;
    }
  
  return error_code;   
}

/*
static eJsonStatus ProcessGetSoC (const char * jsonString)
{
  eJsonStatus error_code = JSON_NO_ERROR;
  uint16_t dataCount=0;
  txBuff[dataCount]=0;
  uint16_t bufferLength = sizeof(txBuff)-dataCount;
  ParseHeaderData(&txBuff[dataCount],&bufferLength,CMD_GET_SOC);
  dataCount = dataCount+bufferLength;    
  bufferLength = sizeof(txBuff)-dataCount;
  char Soc_Str[10];
  ftoa(GetSOCAsPercentage(),Soc_Str,2);
  uint8_t tempCount = snprintf(&txBuff[dataCount],bufferLength,"%s,%d",Soc_Str,GetChargingOrNot());
  dataCount = dataCount+tempCount; 
  txBuff[dataCount] = STOP_CHAR;
  dataCount++;
  Serial_Debug("\r\ndataCount->");
  Serial_Debug_Num(dataCount); 
  Serial_Debug("\r\nData->");
  Serial_Debug_Bytes(txBuff,dataCount);
  Serial_Debug("\r\nEnd");
  UartTransmit(txBuff,dataCount);
  ClearTxBuff();
  return error_code;
}
*/

static eJsonStatus ProcessGetChargerState (const char * jsonString)
{
  eJsonStatus error_code = JSON_NO_ERROR;
  uint16_t dataCount=0;
  txBuff[dataCount]=0;
  uint16_t bufferLength = sizeof(txBuff)-dataCount;
  ParseHeaderData(&txBuff[dataCount],&bufferLength,CMD_GET_CHARGER_STATE);
  dataCount = dataCount+bufferLength;   
  bufferLength = sizeof(txBuff)-dataCount;
  uint8_t tempCount = snprintf(&txBuff[dataCount],bufferLength,"%d",GetChargingOrNot());
  dataCount = dataCount+tempCount; 
  txBuff[dataCount] = STOP_CHAR;
  dataCount++;
  Serial_Debug("\r\ndataCount->");
  Serial_Debug_Num(dataCount); 
  Serial_Debug("\r\nData->");
  Serial_Debug_Bytes(txBuff,dataCount);
  Serial_Debug("\r\nEnd");
  UartTransmit(txBuff,dataCount);
  ClearTxBuff();
  return error_code;
}

static eJsonStatus ProcessGetErrorStatus (const char * jsonString)
{
  eJsonStatus error_code = JSON_NO_ERROR;
  uint16_t dataCount=0;
  txBuff[dataCount]=0;
  uint16_t bufferLength = sizeof(txBuff)-dataCount;
  ParseHeaderData(&txBuff[dataCount],&bufferLength,CMD_GET_CONTROLLER_STATUS);
  dataCount = dataCount+bufferLength;    
  bufferLength = sizeof(txBuff)-dataCount;
  
    uint8_t tempCount = snprintf(&txBuff[dataCount],bufferLength,"%000X", GetMotorFaultCode());
//  uint8_t tempCount = snprintf(&txBuff[dataCount],bufferLength,"%s",SDerrorlog);
  
  dataCount = dataCount+tempCount; 
  txBuff[dataCount] = STOP_CHAR;
  dataCount++;
  Serial_Debug("\r\ndataCount->");
  Serial_Debug_Num(dataCount); 
  Serial_Debug("\r\nData->");
  Serial_Debug_Bytes(txBuff,dataCount);
  Serial_Debug("\r\nEnd");
  UartTransmit(txBuff,dataCount);
  ClearTxBuff();
  return error_code;
}

static eJsonStatus ProcessGetDeviceInfo (const char * jsonString)
{
  eJsonStatus error_code = JSON_NO_ERROR;
  uint16_t dataCount=0;
  txBuff[dataCount]=0;
  uint16_t bufferLength = sizeof(txBuff)-dataCount;
  ParseHeaderData(&txBuff[dataCount],&bufferLength,CMD_GET_DEVICE_INFO);
  dataCount = dataCount+bufferLength;   
  bufferLength = sizeof(txBuff)-dataCount;
  stDevInfo * devInfo = GetSetDeviceIDInfo();
  uint8_t tempCount = snprintf(&txBuff[dataCount],bufferLength,"%s,%s,%s,%s",
                               devInfo->devID, devInfo->hwVersion, devInfo->serialNo, DEFAULT_DEV_SW_REV);
  dataCount = dataCount+tempCount; 
  txBuff[dataCount] = STOP_CHAR;
  dataCount++;
  Serial_Debug("\r\ndataCount->");
  Serial_Debug_Num(dataCount); 
  Serial_Debug("\r\nData->");
  Serial_Debug_Bytes(txBuff,dataCount);
  Serial_Debug("\r\nEnd");
  UartTransmit(txBuff,dataCount);
  ClearTxBuff();
  return error_code;
}

static eJsonStatus ProcessGetCurrentMode (const char * jsonString)
{
  eJsonStatus error_code = JSON_NO_ERROR;
  uint16_t dataCount=0;
  txBuff[dataCount]=0;
  uint16_t bufferLength = sizeof(txBuff)-dataCount;
  ParseHeaderData(&txBuff[dataCount],&bufferLength,CMD_GET_CURRENT_MODE);
  dataCount = dataCount+bufferLength;   
  bufferLength = sizeof(txBuff)-dataCount;
  uint8_t tempCount = 0;
  eMode getMode =  GetOperationMode ();
  uint8_t modeValue = 0;
  switch(getMode)
  {
  case AUTO: 
    modeValue = 0;
    break;
  case MANUAL:
    modeValue = 1;
    break;
  default : 
    modeValue = 1;
    break;
  }
  tempCount = snprintf(&txBuff[dataCount],bufferLength,"%d",modeValue);
  dataCount = dataCount+tempCount; 
  txBuff[dataCount] = STOP_CHAR;
  dataCount++;
  Serial_Debug("\r\ndataCount->");
  Serial_Debug_Num(dataCount); 
  Serial_Debug("\r\nData->");
  Serial_Debug_Bytes(txBuff,dataCount);
  Serial_Debug("\r\nEnd");
  UartTransmit(txBuff,dataCount);
  ClearTxBuff();
  return error_code;
}

static eJsonStatus ProcessGetMotorDirectionManual (const char * jsonString)
{
  eJsonStatus error_code = JSON_NO_ERROR;
  uint16_t dataCount=0;
  txBuff[dataCount]=0;
  uint16_t bufferLength = sizeof(txBuff)-dataCount;
  ParseHeaderData(&txBuff[dataCount],&bufferLength,CMD_GET_MOTOR_DIR_MANUAL);
  dataCount = dataCount+bufferLength;    
  bufferLength = sizeof(txBuff)-dataCount;
  uint8_t tempCount =0;
  eManualState manualState = GetManualState ();
  uint8_t manualValue = 0;
  switch(manualState)
  {
  case MAN_POSITIVE : 
    manualValue = 1;
    break;
  case MAN_NEGATIVE :
    manualValue = 2;
    break;
  case MAN_CYCLE : 
    manualValue = 3;
    break;
  case MAN_NORMAL_STOP : 
    manualValue = 4;
    break;
  case MAN_STOP : 
    manualValue = 5;
    break;
  default : 
    manualValue = 5;
    break;
  }
  tempCount = snprintf(&txBuff[dataCount],bufferLength,"%d",manualValue);
  dataCount = dataCount+tempCount; 
  txBuff[dataCount] = STOP_CHAR;
  dataCount++;
  Serial_Debug("\r\ndataCount->");
  Serial_Debug_Num(dataCount); 
  Serial_Debug("\r\nData->");
  Serial_Debug_Bytes(txBuff,dataCount);
  Serial_Debug("\r\nEnd");
  UartTransmit(txBuff,dataCount);
  ClearTxBuff();
  return error_code;
}

static eJsonStatus ProcessGetMotorPWMManual (const char * jsonString)
{
  eJsonStatus error_code = JSON_NO_ERROR;
  uint16_t dataCount=0;
  txBuff[dataCount]=0;
  uint16_t bufferLength = sizeof(txBuff)-dataCount;
  ParseHeaderData(&txBuff[dataCount],&bufferLength,CMD_GET_MOTOR_PWM_MANUAL);
  dataCount = dataCount+bufferLength;    
  bufferLength = sizeof(txBuff)-dataCount;
  stRobotPwmParam* getPWMVal = GetSetManualPwmParameters();
  
//  AccelCount = circumference * getPWMVal->acelStartCountDiff;
//  AccelCount = AccelCount + Accel_remaining_distance; 
//  DecelCount = circumference * getPWMVal->decelStartCountDiff;
//  DecelCount = DecelCount + Decel_remaining_distance;
  
  uint8_t tempCount = snprintf(&txBuff[dataCount],bufferLength,"%d,%d,%d,%d,%d,%d,%d,%d,%d",getPWMVal->accelTime,getPWMVal->decelTime,getPWMVal->Accel,getPWMVal->accelapproachPwm1,getPWMVal->steadyPwm1,
                               getPWMVal->approachPwm1,getPWMVal->Decel,getPWMVal->acelStartCountDiff,getPWMVal->decelStartCountDiff);
  
//  uint8_t tempCount = snprintf(&txBuff[dataCount],bufferLength,"%d,%d,%d,%d,%d,%d,%d",getPWMVal->accelTime,getPWMVal->decelTime,getPWMVal->acelStartCountDiff,getPWMVal->accelapproachPwm1,getPWMVal->steadyPwm1,getPWMVal->approachPwm1,getPWMVal->decelStartCountDiff);
  dataCount = dataCount+tempCount; 
  txBuff[dataCount] = STOP_CHAR;
  dataCount++;
  Serial_Debug("\r\ndataCount->");
  Serial_Debug_Num(dataCount); 
  Serial_Debug("\r\nData->");
  Serial_Debug_Bytes(txBuff,dataCount);
  Serial_Debug("\r\nEnd");
  UartTransmit(txBuff,dataCount);
  ClearTxBuff();
  return error_code;
}

static eJsonStatus ProcessGetBrushMotorEnabledState (const char * jsonString)
{
  eJsonStatus error_code = JSON_NO_ERROR;
  uint16_t dataCount=0;
  txBuff[dataCount]=0;
  uint16_t bufferLength = sizeof(txBuff)-dataCount;
  ParseHeaderData(&txBuff[dataCount],&bufferLength,CMD_GET_BRUSH_MOTOR_STATE);
  dataCount = dataCount+bufferLength;    
  bufferLength = sizeof(txBuff)-dataCount;
  bool *brushEnabledState = GetSetBrushEnabledState();
  bool *LinearEnabledState = GetSetLinearEnabledState();
  uint8_t tempCount = snprintf(&txBuff[dataCount],bufferLength,"%d,%d", *brushEnabledState,*LinearEnabledState);
  dataCount = dataCount+tempCount; 
  txBuff[dataCount] = STOP_CHAR;
  dataCount++;
  Serial_Debug("\r\ndataCount->");
  Serial_Debug_Num(dataCount); 
  Serial_Debug("\r\nData->");
  Serial_Debug_Bytes(txBuff,dataCount);
  Serial_Debug("\r\nEnd");
  UartTransmit(txBuff,dataCount);
  ClearTxBuff();
  return error_code;
}

static eJsonStatus ProcessGetBrushMotorPWMManual (const char * jsonString)
{
  eJsonStatus error_code = JSON_NO_ERROR;
  uint16_t dataCount=0;
  txBuff[dataCount]=0;
  uint16_t bufferLength = sizeof(txBuff)-dataCount;
  ParseHeaderData(&txBuff[dataCount],&bufferLength,CMD_GET_BRUSH_MOTOR_PWM_MANUAL);
  dataCount = dataCount+bufferLength;    
  bufferLength = sizeof(txBuff)-dataCount;
  stBrushPwmParam* getBrushPWMVal = GetSetBrushNormalPwmParameters();
  
//  brushTime = (brushMotorStopDeadTime_ms)/1000;
 //  brushMotorStopDeadTime_ms = (setBrushParams->brushTime)*1000;
  
  uint8_t tempCount = snprintf(&txBuff[dataCount],bufferLength,"%d,%d,%d,%d",getBrushPWMVal->accelTime,
  getBrushPWMVal->decelTime,getBrushPWMVal->steadyPwm,getBrushPWMVal->brushTime);
  
  //brushMotorStopDeadTime_ms = (getBrushPWMVal->brushTime)*1000;
  
  dataCount = dataCount+tempCount; 
  txBuff[dataCount] = STOP_CHAR;
  dataCount++;
  Serial_Debug("\r\ndataCount->");
  Serial_Debug_Num(dataCount); 
  Serial_Debug("\r\nData->");
  Serial_Debug_Bytes(txBuff,dataCount);
  Serial_Debug("\r\nEnd");
  UartTransmit(txBuff,dataCount);
  ClearTxBuff();
  return error_code;
}

static eJsonStatus ProcessGetBrushMotorPolarity (const char * jsonString)
{
  eJsonStatus error_code = JSON_NO_ERROR;
  uint16_t dataCount=0;
  txBuff[dataCount]=0;
  uint16_t bufferLength = sizeof(txBuff)-dataCount;
  ParseHeaderData(&txBuff[dataCount],&bufferLength,CMD_GET_BRUSH_MOTOR_DIR);
  dataCount = dataCount+bufferLength;    
  bufferLength = sizeof(txBuff)-dataCount;
  stBrushMotPolarity *setMotPolarity = GetSetBrushMotPolarity();
  uint8_t tempCount = snprintf(&txBuff[dataCount],bufferLength,"%d",setMotPolarity->mot1Polarity);
  dataCount = dataCount+tempCount; 
  txBuff[dataCount] = STOP_CHAR;
  dataCount++;
  Serial_Debug("\r\ndataCount->");
  Serial_Debug_Num(dataCount); 
  Serial_Debug("\r\nData->");
  Serial_Debug_Bytes(txBuff,dataCount);
  Serial_Debug("\r\nEnd");
  UartTransmit(txBuff,dataCount);
  ClearTxBuff();
  return error_code;
}


static eJsonStatus ProcessGetMotorPWMAuto (const char * jsonString)
{
  eJsonStatus error_code = JSON_NO_ERROR;
  uint16_t dataCount=0;
  txBuff[dataCount]=0;
  uint16_t bufferLength = sizeof(txBuff)-dataCount;
  ParseHeaderData(&txBuff[dataCount],&bufferLength,CMD_GET_MOTOR_PWM_AUTO);
  dataCount = dataCount+bufferLength;    
  bufferLength = sizeof(txBuff)-dataCount;
  stRobotPwmParam* getPWMVal = GetSetCycleAutoPwmParameters();
  
//  AccelCount = circumference * getPWMVal->acelStartCountDiff;
//  AccelCount = AccelCount + Accel_remaining_distance; 
//  DecelCount = circumference * getPWMVal->decelStartCountDiff;
//  DecelCount = DecelCount + Decel_remaining_distance;
  
  uint8_t tempCount = snprintf(&txBuff[dataCount],bufferLength,"%d,%d,%d,%d,%d,%d,%d,%d,%d",getPWMVal->accelTime,getPWMVal->decelTime,getPWMVal->Accel,getPWMVal->accelapproachPwm1,
                               getPWMVal->steadyPwm1,getPWMVal->approachPwm1,getPWMVal->Decel,getPWMVal->acelStartCountDiff,getPWMVal->decelStartCountDiff);

//  uint8_t tempCount = snprintf(&txBuff[dataCount],bufferLength,"%d,%d,%d,%d,%d,%d,%d",getPWMVal->accelTime,getPWMVal->decelTime,Accel_speed,getPWMVal->accelapproachPwm1,getPWMVal->steadyPwm1,getPWMVal->approachPwm1,Decel_speed);
  //uint8_t tempCount = snprintf(&txBuff[dataCount],bufferLength,"%d,%d,%d,%d,%d,%d,%d",getPWMVal->accelTime,getPWMVal->decelTime,getPWMVal->acelStartCountDiff,getPWMVal->accelapproachPwm1,getPWMVal->steadyPwm1,getPWMVal->approachPwm1,getPWMVal->decelStartCountDiff);
  dataCount = dataCount+tempCount; 
  txBuff[dataCount] = STOP_CHAR;
  dataCount++;
  Serial_Debug("\r\ndataCount->");
  Serial_Debug_Num(dataCount); 
  Serial_Debug("\r\nData->");
  Serial_Debug_Bytes(txBuff,dataCount);
  Serial_Debug("\r\nEnd");
  UartTransmit(txBuff,dataCount);
  ClearTxBuff();
  return error_code;
}

static eJsonStatus ProcessGetBrushMotorPWMAuto (const char * jsonString)
{
  eJsonStatus error_code = JSON_NO_ERROR;
  uint16_t dataCount=0;
  txBuff[dataCount]=0;
  uint16_t bufferLength = sizeof(txBuff)-dataCount;
  ParseHeaderData(&txBuff[dataCount],&bufferLength,CMD_GET_BRUSH_MOTOR_PWM_AUTO);
  dataCount = dataCount+bufferLength;    
  bufferLength = sizeof(txBuff)-dataCount;
  stBrushPwmParam* getBrushPWMVal = GetSetBrushAutoPwmParameters();
  uint8_t tempCount = snprintf(&txBuff[dataCount],bufferLength,"%d,%d,%d,%d",getBrushPWMVal->accelTime,
  getBrushPWMVal->decelTime,getBrushPWMVal->steadyPwm,getBrushPWMVal->brushTime);
  
  //brushMotorStopDeadTime_ms = (getBrushPWMVal->brushTime)*1000;
  
  dataCount = dataCount+tempCount; 
  txBuff[dataCount] = STOP_CHAR;
  dataCount++;
  Serial_Debug("\r\ndataCount->");
  Serial_Debug_Num(dataCount); 
  Serial_Debug("\r\nData->");
  Serial_Debug_Bytes(txBuff,dataCount);
  Serial_Debug("\r\nEnd");
  UartTransmit(txBuff,dataCount);
  ClearTxBuff();
  return error_code;
}
//
//static eJsonStatus ProcessGetAutoScheduleTime (const char * jsonString)
//{
//  eJsonStatus error_code = JSON_NO_ERROR;
//  uint16_t dataCount=0;
//  txBuff[dataCount]=0;
//  uint16_t bufferLength = sizeof(txBuff)-dataCount;
//  ParseHeaderData(&txBuff[dataCount],&bufferLength,CMD_GET_AUTO_SCHEDULE_TIME);
//  dataCount = dataCount+bufferLength;    
//  bufferLength = sizeof(txBuff)-dataCount;
//  stScheduleTime* getScheduleTime = GetSetScheduleTime();
//  uint8_t tempCount = snprintf(&txBuff[dataCount],bufferLength,"%02d%02d",getScheduleTime->hour,getScheduleTime->minute);
//  dataCount = dataCount+tempCount; 
//  txBuff[dataCount] = STOP_CHAR;
//  dataCount++;
//  Serial_Debug("\r\ndataCount->");
//  Serial_Debug_Num(dataCount); 
//  Serial_Debug("\r\nData->");
//  Serial_Debug_Bytes(txBuff,dataCount);
//  Serial_Debug("\r\nEnd");
//  UartTransmit(txBuff,dataCount);
//  ClearTxBuff();
//  return error_code;
//}

//07Dchange
static eJsonStatus ProcessGetAutoScheduleTime (const char * jsonString)
{
  eJsonStatus error_code = JSON_NO_ERROR;
  uint16_t dataCount=0;
  txBuff[dataCount]=0;
  uint16_t bufferLength = sizeof(txBuff)-dataCount;
  ParseHeaderData(&txBuff[dataCount],&bufferLength,CMD_GET_AUTO_SCHEDULE_TIME);
  dataCount = dataCount+bufferLength;    
  bufferLength = sizeof(txBuff)-dataCount;
  stScheduleTime* getScheduleTime = GetSetScheduleTime();  
  
  uint8_t tempCount = snprintf(&txBuff[dataCount],bufferLength,"%02d%02d,%02d%02d,%02d%02d,%02d%02d,%02d%02d,%02d%02d,%02d%02d,%02d%02d,%02d%02d,%02d%02d,%02d%02d,%02d%02d,%02d%02d,%02d%02d,%02d%02d,%02d%02d,%02d%02d,%02d%02d,%02d%02d",
   getScheduleTime->HOUR[0],getScheduleTime->MINUTE[0],getScheduleTime->HOUR[1],getScheduleTime->MINUTE[1],
   getScheduleTime->HOUR[2],getScheduleTime->MINUTE[2],getScheduleTime->HOUR[3],getScheduleTime->MINUTE[3],
   getScheduleTime->HOUR[4],getScheduleTime->MINUTE[4],getScheduleTime->HOUR[5],getScheduleTime->MINUTE[5],  
   getScheduleTime->HOUR[6],getScheduleTime->MINUTE[6],getScheduleTime->HOUR[7],getScheduleTime->MINUTE[7],
   getScheduleTime->HOUR[8],getScheduleTime->MINUTE[8],getScheduleTime->HOUR[9],getScheduleTime->MINUTE[9], 
   getScheduleTime->HOUR[10],getScheduleTime->MINUTE[10],getScheduleTime->HOUR[11],getScheduleTime->MINUTE[11],
   getScheduleTime->HOUR[12],getScheduleTime->MINUTE[12],getScheduleTime->HOUR[13],getScheduleTime->MINUTE[13],  
   getScheduleTime->HOUR[14],getScheduleTime->MINUTE[14],getScheduleTime->HOUR[15],getScheduleTime->MINUTE[15],
   getScheduleTime->HOUR[16],getScheduleTime->MINUTE[16],getScheduleTime->HOUR[17],getScheduleTime->MINUTE[17],
   getScheduleTime->HOUR[18],getScheduleTime->MINUTE[18]);   
  dataCount = dataCount+tempCount;

  txBuff[dataCount] = STOP_CHAR;
  dataCount++;
  Serial_Debug("\r\ndataCount->");
  Serial_Debug_Num(dataCount); 
  Serial_Debug("\r\nData->");
  Serial_Debug_Bytes(txBuff,dataCount);
  Serial_Debug("\r\nEnd");
  UartTransmit(txBuff,dataCount);
//  if(GetSwitchState() == MANUAL_CONTROL)
//  {
//    UartTransmitType(CONFIG_UART,txBuff,dataCount);
//  }
//  else if(GetSwitchState() == AUTO_CONTROL)
//  {
//    UartTransmitType(ZIGBEE_UART,txBuff,dataCount);
//  }
  ClearTxBuff();
  return error_code;
}

static eJsonStatus ProcessGetEdgeSenseEnabledState (const char * jsonString)
{
  eJsonStatus error_code = JSON_NO_ERROR;
  uint16_t dataCount=0;
  txBuff[dataCount]=0;
  uint16_t bufferLength = sizeof(txBuff)-dataCount;
  ParseHeaderData(&txBuff[dataCount],&bufferLength,CMD_GET_EDGE_SENSE_STATE);
  dataCount = dataCount+bufferLength;    
  bufferLength = sizeof(txBuff)-dataCount;
  uint8_t tempCount = snprintf(&txBuff[dataCount],bufferLength,"%d,%d",IsEdgeSensorEnabled(),IsRotateSensorEnabled());
  dataCount = dataCount+tempCount; 
  txBuff[dataCount] = STOP_CHAR;
  dataCount++;
  Serial_Debug("\r\ndataCount->");
  Serial_Debug_Num(dataCount); 
  Serial_Debug("\r\nData->");
  Serial_Debug_Bytes(txBuff,dataCount);
  Serial_Debug("\r\nEnd");
  UartTransmit(txBuff,dataCount);
  ClearTxBuff();
  return error_code;
}

static eJsonStatus ProcessGetRTCValue (const char * jsonString)
{
  eJsonStatus error_code = JSON_NO_ERROR;
  uint16_t dataCount=0;
  txBuff[dataCount]=0;
  uint16_t bufferLength = sizeof(txBuff)-dataCount;
  ParseHeaderData(&txBuff[dataCount],&bufferLength,CMD_GET_RTC_VALUE);
  dataCount = dataCount+bufferLength;    
  bufferLength = sizeof(txBuff)-dataCount;
  uint32_t getTime = GetRTCDateTimeSeconds();
//  uint8_t tempCount = snprintf(&txBuff[dataCount],bufferLength,"%d",getTime);
 
  GetRTCDateTimeString(&getTime_str, sizeof getTime_str);
  /** 07S **/
  strcat(txBuff,getTime_str);
  char tempCount = strlen(getTime_str);
  /** 07S **/
  Serial_Debug("\r\nTime-->");
  Serial_Debug(getTime_str);
  dataCount = dataCount+tempCount; 
  txBuff[dataCount] = STOP_CHAR;
  dataCount++;
  Serial_Debug("\r\ndataCount->");
  Serial_Debug_Num(dataCount); 
  Serial_Debug("\r\nData->");
  Serial_Debug_Bytes(txBuff,dataCount);
  Serial_Debug("\r\nEnd");

  UartTransmit(txBuff,dataCount);
  ClearTxBuff();
  return error_code;
}

static eJsonStatus ProcessGetCurrentStat (const char * jsonString)
{
   eJsonStatus error_code = JSON_NO_ERROR;
  uint16_t dataCount=0;
  txBuff[dataCount]=0;
  uint16_t bufferLength = sizeof(txBuff)-dataCount;
  ParseHeaderData(&txBuff[dataCount],&bufferLength,CMD_GET_CURRENT_STAT);
  dataCount = dataCount+bufferLength;    
  bufferLength = sizeof(txBuff)-dataCount;
  eRobotDirection robotState = GetRobotActualDirection();
  eMode getMode =  GetOperationMode ();
  uint8_t modeValue = 0;
  
   stCycleFrequency* getCycleFrequency = GetSetcycleFrequencyLimits(); 
  char Cycle_Str[2]; 
  ftoa(getCycleFrequency->Cycle,Cycle_Str,0);
  snprintf(&txBuff[dataCount],bufferLength,"%s",Cycle_Str);
  
  char total_Schedule = atoi(Cycle_Str);
  int Currentdistance;
  
  switch(getMode)
  {
  case AUTO: 
    modeValue = 0;
    break;
  case MANUAL:
    modeValue = 1;
    break;
  default : 
    modeValue = 1;
    break;
  }
  
  PulseCalculation();
  
  Currentdistance = GetRotateSense1Count() * distance;
  
  uint8_t tempCount = snprintf(&txBuff[dataCount],bufferLength,"%d, %d, %d, %d, %d, %d, %d, %d, %d, %d, %d, %d, %d", modeValue, robotState, GetRotateSense1Count(),Currentdistance,GetRotateSense2Count(), Get_Current_Brush_Count(), GetRotateSense1State(), GetRotateSense2State(),GetEdgeSense1State(), GetEdgeSense2State(),Get_Completed_Schedule(),total_Schedule - Get_Completed_Schedule(),Cumulative_distance);
  dataCount = dataCount+tempCount; 
  txBuff[dataCount] = STOP_CHAR;
  dataCount++;
  Serial_Debug("\r\ndataCount->");
  Serial_Debug_Num(dataCount); 
  Serial_Debug("\r\nData->");
  Serial_Debug_Bytes(txBuff,dataCount);
  Serial_Debug("\r\nEnd");
  UartTransmit(txBuff,dataCount);
  ClearTxBuff();
  return error_code;
}

static eJsonStatus ProcessGetCurrentRobotStat (const char * jsonString)
{
  eJsonStatus error_code = JSON_NO_ERROR;
  uint16_t dataCount=0;
  txBuff[dataCount]=0;
  uint16_t bufferLength = sizeof(txBuff)-dataCount;
  ParseHeaderData(&txBuff[dataCount],&bufferLength,CMD_GET_CURRENT_ROBOT_STATUS);
  dataCount = dataCount+bufferLength;    
  bufferLength = sizeof(txBuff)-dataCount;
  eRobotDirection robotState = GetRobotActualDirection();
  eMode getMode =  GetOperationMode ();
  uint8_t modeValue = 0;
  switch(getMode)
  {
  case AUTO: 
    modeValue = 0;
    break;
  case MANUAL:
    modeValue = 1;
    break;
  default : 
    modeValue = 1;
    break;
  }
  uint32_t tc_error_code;
  
  if(GetMotionPauseState() == PA_WAIT_FOR_ERROR_CLEAR)
  {
     tc_error_code = GetMotorFaultCode();
  }
  else
  {
     tc_error_code = 0; 
  }
//  int Currentdistance;
//  Currentdistance = GetRotateSense1Count() * distance;
  
  
//  Cumulative_distance += GetRotateSense1Count() * distance;
  
  uint8_t tempCount = snprintf(&txBuff[dataCount],bufferLength,"%d, %d, %d, %d, %d, %ld,%d,%d", modeValue, robotState, /*GetRobotState()*/ GetCycleModeState(), GetRotateSense1Count(), GetRotateSense2Count(),tc_error_code,Cumulative_distance,cleaner_in_comm);
  dataCount = dataCount+tempCount; 
  txBuff[dataCount] = STOP_CHAR;
  dataCount++;
  Serial_Debug("\r\ndataCount->");
  Serial_Debug_Num(dataCount); 
  Serial_Debug("\r\nData->");
  Serial_Debug_Bytes(txBuff,dataCount);
  Serial_Debug("\r\nEnd");
  UartTransmit(txBuff,dataCount);
  ClearTxBuff();
  return error_code;
}

static eJsonStatus ProcessGetLastOperationStat (const char * jsonString)
{
  eJsonStatus error_code = JSON_NO_ERROR;
  uint16_t dataCount=0;
  txBuff[dataCount]=0;
  int mode_now;
  uint16_t bufferLength = sizeof(txBuff)-dataCount;
  ParseHeaderData(&txBuff[dataCount],&bufferLength,CMD_GET_LAST_CYCLE_STAT);
  dataCount = dataCount+bufferLength;    
  bufferLength = sizeof(txBuff)-dataCount;
  stLastOperationStatus *lastOpStatus = GetLastOperationData();
  char startSoc_Str[10],endSoc_Str[10];
  ftoa(lastOpStatus->startSOC,startSoc_Str,2);
  ftoa(lastOpStatus->endSOC,endSoc_Str,2);
  int Currentdistance;
//  uint8_t tempCount = snprintf(&txBuff[dataCount],bufferLength,"%d,%d,%s,%s,%d,%d,%d",lastOpStatus->startTime, 
//                               lastOpStatus->endTime,startSoc_Str, endSoc_Str, lastOpStatus->totalRotateCount1, 
//                               lastOpStatus->totalRotateCount2,lastOpStatus->errorCode);
  
  PulseCalculation();
  Currentdistance = GetRotateSense1Count() * distance;
  eRobotDirection robotState = GetRobotActualDirection();
  eMode getMode =  GetOperationMode ();
    
    uint8_t modeValue = 0;
    switch(getMode)
    {
    case AUTO: 
      modeValue = 0;
      mode_now =  Get_Completed_Schedule();
      break;
    case MANUAL:
      modeValue = 1;
      mode_now = 0;
      break;
    default : 
      modeValue = 0;
      mode_now =  Get_Completed_Schedule();
      break;
    }
  
  
 // uint8_t tempCount = snprintf(&txBuff[dataCount],bufferLength,"%d,%d,%d,%d,%s",modeValue,mode_now,GetRotateSense1Count(),Currentdistance,schedule_log);
  uint8_t tempCount = snprintf(&txBuff[dataCount],bufferLength,"%d,%d,%000X,%d,%d,%s,%d",modeValue,mode_now,GetMotorFaultCode(),Currentdistance,robotState,cyclelog,Cumulative_distance);
  
  dataCount = dataCount+tempCount; 
  txBuff[dataCount] = STOP_CHAR;
  dataCount++;
  Serial_Debug("\r\ndataCount->");
  Serial_Debug_Num(dataCount); 
  Serial_Debug("\r\nData->");
  Serial_Debug_Bytes(txBuff,dataCount);
  Serial_Debug("\r\nEnd");
//  UartTransmit(txBuff,dataCount);
  if(GetSwitchState() == MANUAL_CONTROL)
  {
    UartTransmitType(CONFIG_UART,txBuff,dataCount);
  }
  else if(GetSwitchState() == AUTO_CONTROL)
  {
    UartTransmitType(ZIGBEE_UART,txBuff,dataCount);
  }
  ClearTxBuff();
  return error_code;
}
static eJsonStatus ProcessGetOverCurrentLimits (const char * jsonString)
{
  eJsonStatus error_code = JSON_NO_ERROR;
  uint16_t dataCount=0;
  txBuff[dataCount]=0;
  uint16_t bufferLength = sizeof(txBuff)-dataCount;
  ParseHeaderData(&txBuff[dataCount],&bufferLength,CMD_GET_OVERCURRENT_LIMIT);
  dataCount = dataCount+bufferLength;    
  bufferLength = sizeof(txBuff)-dataCount;
  stMaxMotorCurrent* getMotorCurrent = GetSetMaxMotorCurrentLimits();
  char Imot1_Str[10],Imot2_Str[10],Imot3_Str[10];
  ftoa(getMotorCurrent->Imot1,Imot1_Str,2);
  ftoa(getMotorCurrent->Imot2,Imot2_Str,2);
  ftoa(getMotorCurrent->Imot3,Imot3_Str,2);
  uint8_t tempCount = snprintf(&txBuff[dataCount],bufferLength,"%s,%s,%s",Imot1_Str,Imot2_Str,Imot3_Str);
  dataCount = dataCount+tempCount; 
  txBuff[dataCount] = STOP_CHAR;
  dataCount++;
  Serial_Debug("\r\ndataCount->");
  Serial_Debug_Num(dataCount); 
  Serial_Debug("\r\nData->");
  Serial_Debug_Bytes(txBuff,dataCount);
  Serial_Debug("\r\nEnd");
  UartTransmit(txBuff,dataCount);
  ClearTxBuff();
  return error_code;
}
static eJsonStatus ProcessGetMotorCurrentValues (const char * jsonString)
{
  eJsonStatus error_code = JSON_NO_ERROR;
  uint16_t dataCount=0;
  txBuff[dataCount]=0;
  uint16_t bufferLength = sizeof(txBuff)-dataCount;
  ParseHeaderData(&txBuff[dataCount],&bufferLength,CMD_GET_MOT_CURRENT_VALUES);
  dataCount = dataCount+bufferLength;    
  bufferLength = sizeof(txBuff)-dataCount;
  char Imot1_Str[10],Imot2_Str[10],Imot3_Str[10];
  ftoa(GetImot1Value(),Imot1_Str,2);
  ftoa(GetImot2Value(),Imot2_Str,2);
  ftoa(GetImot3Value(),Imot3_Str,2);
  uint8_t tempCount;
  
  if(GetRobotState() != ROBOT_COMPLETED && GetRobotState() != ROBOT_IDLE)
  {  
      tempCount = snprintf(&txBuff[dataCount],bufferLength,"%s,%s,%s",Imot1_Str,Imot2_Str,Imot3_Str);
//      tempCount = snprintf(&txBuff[dataCount],bufferLength,"%f,%f,%f",GetImot1Value(),GetImot2Value(),GetImot3Value());
  }
  else
  {
      memset(Imot1_Str,'\0',sizeof(Imot1_Str)); 
      memset(Imot2_Str,'\0',sizeof(Imot2_Str)); 
      memset(Imot3_Str,'\0',sizeof(Imot3_Str)); 
      strcpy(Imot1_Str,"0.00");  strcpy(Imot2_Str,"0.00"); strcpy(Imot3_Str,"0.00");
      
      tempCount = snprintf(&txBuff[dataCount],bufferLength,"%s,%s,%s",Imot1_Str,Imot2_Str,Imot3_Str);  
  }
  dataCount = dataCount+tempCount; 
  txBuff[dataCount] = STOP_CHAR;
  dataCount++;
  Serial_Debug("\r\ndataCount->");
  Serial_Debug_Num(dataCount); 
  Serial_Debug("\r\nData->");
  Serial_Debug_Bytes(txBuff,dataCount);
  Serial_Debug("\r\nEnd");
  UartTransmit(txBuff,dataCount);
  ClearTxBuff();
  return error_code;
}
static eJsonStatus ProcessGetPulseCountValues (const char * jsonString)
{
  eJsonStatus error_code = JSON_NO_ERROR;
  uint16_t dataCount=0;
  txBuff[dataCount]=0;
  uint16_t bufferLength = sizeof(txBuff)-dataCount;
  ParseHeaderData(&txBuff[dataCount],&bufferLength,CMD_GET_PULSE_COUNT_VALUES);
  dataCount = dataCount+bufferLength;    
  bufferLength = sizeof(txBuff)-dataCount;
  stCountRange* getCountValue = GetSetCountRange();
  
  
  Getpos = circumference * getCountValue->maxPosCountForPVsetup;
  Getpos = Getpos + forward_remaining_distance; 
  Getneg = circumference * getCountValue->maxNegCountForPVsetup;
  Getneg = Getneg + backward_remaining_distance;
  
//  Getpos = circumference * getCountValue->maxPosCountForPVsetup;
//  Getneg = circumference * getCountValue->maxNegCountForPVsetup; 
  
  uint8_t tempCount = snprintf(&txBuff[dataCount],bufferLength,"%d,%d,%d,%d",posdistance_int,negdistance_int,getCountValue->maxPosCountForPVsetup,getCountValue->maxNegCountForPVsetup);
  
//  uint8_t tempCount = snprintf(&txBuff[dataCount],bufferLength,"%d,%d",getCountValue->maxPosCountForPVsetup,getCountValue->maxNegCountForPVsetup);
  dataCount = dataCount+tempCount; 
  txBuff[dataCount] = STOP_CHAR;
  dataCount++;
  Serial_Debug("\r\ndataCount->");
  Serial_Debug_Num(dataCount); 
  Serial_Debug("\r\nData->");
  Serial_Debug_Bytes(txBuff,dataCount);
  Serial_Debug("\r\nEnd");
  UartTransmit(txBuff,dataCount);
  ClearTxBuff();
  return error_code;
}

static eJsonStatus ProcessGetLowBatSoC (const char * jsonString)
{
  eJsonStatus error_code = JSON_NO_ERROR;
  uint16_t dataCount=0;
  txBuff[dataCount]=0;
  uint16_t bufferLength = sizeof(txBuff)-dataCount;
  ParseHeaderData(&txBuff[dataCount],&bufferLength,CMD_GET_LOW_BAT_SOC);
  dataCount = dataCount+bufferLength;    
  bufferLength = sizeof(txBuff)-dataCount;
  uint8_t *lowBatSoc = GetSetMinBattSoc();
  uint8_t tempCount = snprintf(&txBuff[dataCount],bufferLength,"%d",*lowBatSoc);
  dataCount = dataCount+tempCount; 
  txBuff[dataCount] = STOP_CHAR;
  dataCount++;
  Serial_Debug("\r\ndataCount->");
  Serial_Debug_Num(dataCount); 
  Serial_Debug("\r\nData->");
  Serial_Debug_Bytes(txBuff,dataCount);
  Serial_Debug("\r\nEnd");
  UartTransmit(txBuff,dataCount);
  ClearTxBuff();
  return error_code;
}
static eJsonStatus ProcessResetToDefaults (const char * jsonString)
{
  eJsonStatus error_code = JSON_NO_ERROR;
  eEepromStatus status = EEPROM_OK;
  stJsonCommand *jsonCmdParam;
  uint16_t commandParamsTotalCount = GetCommandProcessingParam(&jsonCmdParam);
  status = InitialiseAlltoDefault(jsonCmdParam, commandParamsTotalCount);
  if(status == EEPROM_OK)
  {
    error_code = JSON_NO_ERROR;
  }
  else
  {
    error_code = JSON_EEPROM_ERROR;
  }
  return error_code;
}
static eJsonStatus ProcessGetZigbeeConfig (const char * jsonString)
{
  uint16_t dataCount=0;
  txBuff[dataCount]=0;
  uint16_t bufferLength = sizeof(txBuff)-dataCount;
  bool status = ParseHeaderData(&txBuff[dataCount], &bufferLength, CMD_GET_ZIGBEE_CONF);
  dataCount = dataCount+bufferLength; 
  stZigbeeConfigRead zigbeeReadConfigData;
  GetZigbeeParameters(&zigbeeReadConfigData);
  bufferLength = sizeof(txBuff)-dataCount;
  uint8_t tempCount = snprintf(&txBuff[dataCount],bufferLength,"%s,%s,%s,%s,%s",(char *)zigbeeReadConfigData.AssocStatus,
                               (char *)zigbeeReadConfigData.configPanID,(char *)zigbeeReadConfigData.encryptionOptions,
                               (char *)zigbeeReadConfigData.encryptionEnable, (char *)zigbeeReadConfigData.joinVerifyEnable);
  dataCount = dataCount+tempCount; 
  txBuff[dataCount] = STOP_CHAR;
  dataCount++;
  Serial_Debug("\r\ndataCount->");
  Serial_Debug_Num(dataCount); 
  Serial_Debug("\r\nData->");
  Serial_Debug_Bytes(txBuff,dataCount);
  Serial_Debug("\r\nEnd");
  UartTransmit(txBuff,dataCount);
  ClearTxBuff();
  return JSON_NO_ERROR;
}

static eJsonStatus ProcessGetZigbeeNetworkParams (const char * jsonString)
{
  uint16_t dataCount=0;
  txBuff[dataCount]=0;
  uint16_t bufferLength = sizeof(txBuff)-dataCount;
  bool status = ParseHeaderData(&txBuff[dataCount], &bufferLength, CMD_GET_ZIGBEE_NTW_PARAM);
  dataCount = dataCount+bufferLength; 
  stZigbeeNetworkParamRead zigbeeNetworkParamRead;
  GetZigbeeNetworkParameters(&zigbeeNetworkParamRead);
  bufferLength = sizeof(txBuff)-dataCount;
  uint8_t tempCount = snprintf(&txBuff[dataCount],bufferLength,"%s,%s,%s,%s",
                               (char *)zigbeeNetworkParamRead.opPanID,(char *)zigbeeNetworkParamRead.opPan16BitID,
                               (char *)zigbeeNetworkParamRead.opChannel, (char *)zigbeeNetworkParamRead.stackProfile);
  dataCount = dataCount+tempCount; 
  txBuff[dataCount] = STOP_CHAR;
  dataCount++;
  Serial_Debug("\r\ndataCount->");
  Serial_Debug_Num(dataCount); 
  Serial_Debug("\r\nData->");
  Serial_Debug_Bytes(txBuff,dataCount);
  Serial_Debug("\r\nEnd");
  UartTransmit(txBuff,dataCount);
  ClearTxBuff();
  return JSON_NO_ERROR;
}

static eJsonStatus ProcessGetBatteryAndPVvalues (const char * jsonString)
{
  uint16_t dataCount=0;
  txBuff[dataCount]=0;
  stBatCurrent BatteryCurrent;float Vin_f,Vbat_f,Iin_f,Ibat_f,Dtemp_f;
  char Vin_str[10],Vbat_str[10],Iin_str[10],Ibat_str[10],Dtemp_str[10];
  Vin_f = GetInputVoltage();
  ftoa(Vin_f,Vin_str,1);
  Vbat_f = GetBatteryVoltage();
  ftoa(Vbat_f,Vbat_str,1);
  Iin_f = GetInputCurrent();
  ftoa(Iin_f,Iin_str,1);
  Dtemp_f = GetDieTemperature();
  ftoa(Dtemp_f,Dtemp_str,1);
  GetBatteryCurrent(&BatteryCurrent);
  Ibat_f = BatteryCurrent.current;
  if(!BatteryCurrent.direction)
    Ibat_f = 0-Ibat_f;
  ftoa(Ibat_f,Ibat_str,1);
  uint16_t bufferLength = sizeof(txBuff)-dataCount;
  bool status = ParseHeaderData(&txBuff[dataCount], &bufferLength, CMD_GET_BAT_AND_PV_VAL);
  dataCount = dataCount+bufferLength; 
  bufferLength = sizeof(txBuff)-dataCount;
  
  char Soc_Str[10];
  ftoa(GetSOCAsPercentage(),Soc_Str,2);
  //uint8_t tempCount = snprintf(&txBuff[dataCount],bufferLength,"%s,%d",Soc_Str,GetChargingOrNot());
  
 // uint8_t tempCount = snprintf(&txBuff[dataCount],bufferLength,"%s,%s,%s,%s,%s,%s,%d",Vin_str,Iin_str,Vbat_str, Ibat_str,Dtemp_str,Soc_Str,GetChargingOrNot());
  
    uint8_t tempCount = snprintf(&txBuff[dataCount],bufferLength,"%s,%s,%s,%s,%s,%s,%d,%s,%s,%s,%s,%s,%s,%s,%s,%s",Vin_str,Iin_str,Vbat_str, Ibat_str,Dtemp_str,Soc_Str,GetChargingOrNot(),bat_arr,pv_arr,mpptcurr_arr,mpptout_arr,inttemp_arr,exttemp_arr,batstate_arr,loadout_arr,loadtrip_arr);
  
//  uint8_t tempCount = snprintf(&txBuff[dataCount],bufferLength,"%s,%s,%s,%s,%s,%s,%d,%d,%d,%d,%d,%X,%X,%s,%s,%s,%s,%s,%s,%s,%s,%s",Vin_str,Iin_str,Vbat_str, Ibat_str,Dtemp_str,Soc_Str,GetChargingOrNot(), modeValue, robotState,
//                               GetRotateSenseCount(), GetNextIndex(),GetMotorFaultCode(), IsErrorFromCleaner(),bat_arr,pv_arr,mpptcurr_arr,mpptout_arr,inttemp_arr,exttemp_arr,batstate_arr,loadout_arr,loadtrip_arr);
  
  
  dataCount = dataCount+tempCount; 
  txBuff[dataCount] = STOP_CHAR;
  dataCount++;
  Serial_Debug("\r\ndataCount->");
  Serial_Debug_Num(dataCount); 
  Serial_Debug("\r\nData->");
  Serial_Debug_Bytes(txBuff,dataCount);
  Serial_Debug("\r\nEnd");
//  UartTransmit(txBuff,dataCount);
   if(GetSwitchState() == MANUAL_CONTROL)
    {
      UartTransmitType(CONFIG_UART,txBuff,dataCount);
    }
    else if(GetSwitchState() == AUTO_CONTROL)
    {
      UartTransmitType(ZIGBEE_UART,txBuff,dataCount);
    }
  ClearTxBuff();
  return JSON_NO_ERROR;
}

static eJsonStatus ProcessGetTemperaturevalues (const char * jsonString)
{
  uint16_t dataCount=0;
  txBuff[dataCount]=0;
  float Battemp_f,Drivetemp_f,Dietemp_f;
  char Battemp_str[10],Drivetemp_str[10],Dietemp_str[10];
  Battemp_f = GetTemperatureSensorData(TEMPSENSOR_1);
  ftoa(Battemp_f,Battemp_str,2);
  Drivetemp_f = GetTemperatureSensorData(TEMPSENSOR_2);
  ftoa(Drivetemp_f,Drivetemp_str,2);
  Dietemp_f = GetDieTemperature();
  ftoa(Dietemp_f,Dietemp_str,2);
  uint16_t bufferLength = sizeof(txBuff)-dataCount;
  bool status = ParseHeaderData(&txBuff[dataCount], &bufferLength, CMD_GET_TEMPERATURES);
  dataCount = dataCount+bufferLength; 
  bufferLength = sizeof(txBuff)-dataCount;
  
  GetRTCDateTimeString(&getTime_str, sizeof getTime_str);
  uint8_t tempCount = snprintf(&txBuff[dataCount],bufferLength,"%s,%s,%s",Battemp_str,Drivetemp_str,Dietemp_str);
  
  //uint8_t tempCount = snprintf(&txBuff[dataCount],bufferLength,"%s",data_read_buffer);
  
  dataCount = dataCount+tempCount; 
  txBuff[dataCount] = STOP_CHAR;
  dataCount++;
  Serial_Debug("\r\ndataCount->");
  Serial_Debug_Num(dataCount); 
  Serial_Debug("\r\nData->");
  Serial_Debug_Bytes(txBuff,dataCount);
  Serial_Debug("\r\nEnd");
  UartTransmit(txBuff,dataCount);
  ClearTxBuff();
  return JSON_NO_ERROR;
}

static eJsonStatus ProcessGetHeartbeatConfig (const char * jsonString)
{
  eJsonStatus error_code = JSON_NO_ERROR;
  uint16_t dataCount=0;
  txBuff[dataCount]=0;
  uint16_t bufferLength = sizeof(txBuff)-dataCount;
  ParseHeaderData(&txBuff[dataCount],&bufferLength,CMD_GET_HEARTBEAT_CONFIG);
  dataCount = dataCount+bufferLength;    
  bufferLength = sizeof(txBuff)-dataCount;
  stHeartbeatConfig *defaultHeartbeatConfig = GetSetHeartbeatConfig();
  uint8_t tempCount = snprintf(&txBuff[dataCount],bufferLength,"%d,%ld,%d,%ld",defaultHeartbeatConfig->enable,defaultHeartbeatConfig->interval_ms,defaultHeartbeatConfig->noOfMessages,defaultHeartbeatConfig->maxReconnectTime);
  dataCount = dataCount+tempCount; 
  txBuff[dataCount] = STOP_CHAR;
  dataCount++;
  Serial_Debug("\r\ndataCount->");
  Serial_Debug_Num(dataCount); 
  Serial_Debug("\r\nData->");
  Serial_Debug_Bytes(txBuff,dataCount);
  Serial_Debug("\r\nEnd");
  UartTransmit(txBuff,dataCount);
  ClearTxBuff();
  return error_code;
}

char* GetAcknowledgementData (eJsonStatus errorCode)
{
  //eJsonStatus error_code = JSON_NO_ERROR;
  uint16_t dataCount=0;
  txAckBuff[dataCount]=0;
  uint16_t bufferLength = sizeof(txAckBuff)-dataCount;
  ParseHeaderData(&txAckBuff[dataCount],&bufferLength,CMD_ACK_DATA);
  dataCount = dataCount+bufferLength;    
  bufferLength = sizeof(txAckBuff)-dataCount;
  uint8_t tempCount = snprintf(&txAckBuff[dataCount],bufferLength,"%X",errorCode);
  dataCount = dataCount+tempCount; 
  txAckBuff[dataCount] = STOP_CHAR;
  dataCount++;
  txAckBuff[dataCount] = 0;
  dataCount++;
  //  Serial_Debug("\r\ndataCount->");
  //  Serial_Debug_Num(dataCount); 
  //  Serial_Debug("\r\nData->");
  //  Serial_Debug_Bytes(txAckBuff,dataCount);
  //  Serial_Debug("\r\nEnd");
  //ClearTxAckBuff();
  return txAckBuff;
}

void ClearTxBuff(void)
{
  for(int i =0;i<MAX_UART_TX_BUFFER_LENGTH;i++)
  {
    txBuff[i] = 0;
  }
}
static bool ParseHeaderData(uint8_t* tempBuff, uint16_t* headerBufferLength, uint16_t command )
{
  uint16_t buffCount = 0;
  
  tempBuff[0] = START_CHAR;
  
  buffCount++;
  *headerBufferLength = *headerBufferLength - buffCount;
  uint64_t macAddr = GetZigbeeMacAddress();                                     //  uint16_t deviceID = GetDeviceID();
  uint16_t maxStrLength = MAC_ID_STR_LEN;
  char macStr[MAC_ID_STR_LEN];
  Int64ToHexString (macAddr, macStr, &maxStrLength);
  uint16_t snData = snprintf(&tempBuff[buffCount],*headerBufferLength,"%02X",DEVICE_ID);
  buffCount = buffCount+snData;
  *headerBufferLength = *headerBufferLength - buffCount;
  //printf("Data->%s",tempBuff);
  tempBuff[buffCount] = DELIMITER_1;
  buffCount++;
  *headerBufferLength = *headerBufferLength - buffCount;
  snData = snprintf(&tempBuff[buffCount],*headerBufferLength,"%04X",command);
  buffCount = buffCount+snData;
  *headerBufferLength = *headerBufferLength - buffCount;
  tempBuff[buffCount] = DELIMITER_2;
  buffCount++;
  *headerBufferLength = *headerBufferLength - buffCount;
  *headerBufferLength = buffCount;
  // Serial_Debug_Bytes(tempBuff,buffCount);
  //Serial_Debug(tempBuff);
  //      if(*headerBufferLength < MAX_UART_TX_BUFFER_LENGTH)
  //  {
  //    return false;
  //  }
  //  else
  //  {
  return true;
  //  }
  
}

static eJsonStatus ProcessSetBrushPwm (const char * jsonString, stBrushPwmParam *tempSetPwmParam)
{
  Serial_Debug(jsonString);
  eJsonStatus error_code = JSON_NO_ERROR;
  
  char *pwmValuesStr[JSON_NO_OF_PWM_DATA_BRUSH];
  uint8_t maxNoStrings=(sizeof pwmValuesStr)/4;
  uint8_t totalResultStringCount =  SplitString (jsonString, pwmValuesStr, ',',maxNoStrings);
  Serial_Debug("\nPWM Set Received Values :");
  for(uint8_t dispcount = 0; dispcount < totalResultStringCount; dispcount++)
  {
    Serial_Debug(pwmValuesStr[dispcount]);
    Serial_Debug(",");
  }
  if(totalResultStringCount == JSON_NO_OF_PWM_DATA_BRUSH)
  {
    bool status = true;
    status &= SetParameterValue_int(pwmValuesStr[0], (uint32_t *)&(tempSetPwmParam->accelTime), IsAccelTimeValid);
    status &= SetParameterValue_int(pwmValuesStr[1], (uint32_t *)&(tempSetPwmParam->decelTime) , IsDecelTimeValid);
    status &= SetParameterValue_int(pwmValuesStr[2], (uint32_t *)&(tempSetPwmParam->steadyPwm), IsPWMvalueValid);
    status &= SetParameterValue_int(pwmValuesStr[3], (uint32_t *)&(tempSetPwmParam->brushTime), IsBrushtimeValid);
 //   status &= SetParameterValue_int(pwmValuesStr[4], (uint32_t *)&(tempSetPwmParam->timePwm), IsPWMvalueValid);
    
//    int Cycle_rotation = atoi(pwmValuesStr[4]);
//    
//    if (Cycle_rotation == 55)
//    { 
//      CYCLEROTATIONTIME = 15; 
//    }
//    else if (Cycle_rotation == 65)
//    {
//      CYCLEROTATIONTIME = 5;
//    }
//    else
//    {
//      CYCLEROTATIONTIME = 15;
//    }
    
    
    if(status == false)
    {
      error_code = JSON_DATA_OUT_OF_RANGE;
      Serial_Debug("\n Pwm SetValue/s Out of Range");
    }
    else
    {
      error_code = JSON_NO_ERROR;
    }            
  }
  else
  {
    Serial_Debug("\n Pwm SetValue/s Invalid");
    error_code = JSON_INVALID_DATA;
  }
  return error_code;  
}


static eJsonStatus ProcessSetMotorPwm (const char * jsonString, stRobotPwmParam *tempSetPwmParam)
{
  Serial_Debug(jsonString);
  eJsonStatus error_code = JSON_NO_ERROR;
  
  char *pwmValuesStr[JSON_NO_OF_SETGET_PWM_DATA_MOTOR];
  uint8_t maxNoStrings=(sizeof pwmValuesStr)/4;
  uint8_t totalResultStringCount =  SplitString (jsonString, pwmValuesStr, ',',maxNoStrings);
  Serial_Debug("\nPWM Set Received Values :");
  for(uint8_t dispcount = 0; dispcount < totalResultStringCount; dispcount++)
  {
    Serial_Debug(pwmValuesStr[dispcount]);
    Serial_Debug(",");
  }
  if(totalResultStringCount == JSON_NO_OF_SETGET_PWM_DATA_MOTOR)
  {
    bool status = true;
    
    pulse_flag = 2;
    
    Accel_speed = atoi(pwmValuesStr[2]);
    Decel_speed = atoi(pwmValuesStr[6]);
    
    PulseCalculation();
      
    status &= SetParameterValue_int(pwmValuesStr[0], (uint32_t *)&(tempSetPwmParam->accelTime), IsAccelTimeValid);
    status &= SetParameterValue_int(pwmValuesStr[1], (uint32_t *)&(tempSetPwmParam->decelTime) , IsDecelTimeValid);
    
    status &= SetParameterValue_int(pwmValuesStr[2], (uint32_t *)&(tempSetPwmParam->Accel), IsPulseCountValid);  //change
    
    status &= SetParameterValue_int(Accel_pulse_count, (uint32_t *)&(tempSetPwmParam->acelStartCountDiff), IsDecelPulseCountDiffValid);
    
    status &= SetParameterValue_int(pwmValuesStr[3], (uint32_t *)&(tempSetPwmParam->accelapproachPwm1), IsPWMvalueValid);
    status &= SetParameterValue_int(pwmValuesStr[3], (uint32_t *)&(tempSetPwmParam->accelapproachPwm2), IsPWMvalueValid);
   
    
    status &= SetParameterValue_int(pwmValuesStr[4], (uint32_t *)&(tempSetPwmParam->steadyPwm1), IsPWMvalueValid);
    status &= SetParameterValue_int(pwmValuesStr[4], (uint32_t *)&(tempSetPwmParam->steadyPwm2), IsPWMvalueValid);
    
    status &= SetParameterValue_int(pwmValuesStr[5], (uint32_t *)&(tempSetPwmParam->approachPwm1), IsPWMvalueValid);
    status &= SetParameterValue_int(pwmValuesStr[5], (uint32_t *)&(tempSetPwmParam->approachPwm2), IsPWMvalueValid);
    
    status &= SetParameterValue_int(pwmValuesStr[6], (uint32_t *)&(tempSetPwmParam->Decel), IsPulseCountValid); //change
    
    status &= SetParameterValue_int(Decel_pulse_count, (uint32_t *)&(tempSetPwmParam->decelStartCountDiff), IsDecelPulseCountDiffValid);
    
   // PulseCalculation();
    
//    status &= SetParameterValue_int(pwmValuesStr[7], (uint32_t *)&(tempSetPwmParam->timePwm), IsPWMvalueValid);
//    
//    int Cycle_rotation = atoi(pwmValuesStr[7]);
//    
//    if (Cycle_rotation == 55)
//    { 
//      CYCLEROTATIONTIME = 15; 
//    }
//    else if (Cycle_rotation == 65)
//    {
//      CYCLEROTATIONTIME = 5;
//    }
//    else
//    {
//      CYCLEROTATIONTIME = 15;
//    }
    
    if(status == false)
    {
      error_code = JSON_DATA_OUT_OF_RANGE;
      Serial_Debug("\n Pwm SetValue/s Out of Range");
    }
    else
    {
      error_code = JSON_NO_ERROR;
    }            
  }
  else
  {
    Serial_Debug("\n Pwm SetValue/s Invalid");
    error_code = JSON_INVALID_DATA;
  }
  return error_code;  
}


static eJsonStatus ProcessSetState (const char * jsonString, bool* tempSetBool)
{
  Serial_Debug("\r\nIn ProcessSetState->");
  Serial_Debug(jsonString);
  eJsonStatus error_code = JSON_NO_ERROR;
  char *setStateStr[JSON_NO_OF_MODE_STATE_DATA];
  uint8_t maxNoStrings=(sizeof setStateStr)/4;
  uint8_t totalResultStringCount =  SplitString (jsonString, setStateStr, ',',maxNoStrings); 
  Serial_Debug("\nstate Values :");
  for(uint8_t dispcount = 0; dispcount < totalResultStringCount; dispcount++)
  {
    Serial_Debug(setStateStr[dispcount]);
    Serial_Debug(",");
  }
  if(totalResultStringCount == JSON_NO_OF_MODE_STATE_DATA)
  {
    bool status = true;
    status &= SetParameterValue_bool(setStateStr[0], tempSetBool, IsStateValid);
    //status &= SetParameterValue_bool(setStateStr[1], tempSetBool, IsStateValid);
    if(status == false)
    {
      error_code = JSON_DATA_OUT_OF_RANGE;
      Serial_Debug("\n Mode SetValue/s Out of Range");
    }
    else
    {
      error_code = JSON_NO_ERROR;
      Serial_Debug("\n Mode SetValue");
    }            
  }
  else
  {
    Serial_Debug("\n Mode SetValue/s Invalid");
    error_code = JSON_INVALID_DATA;
  }
  return error_code;
}

static eJsonStatus ProcessSetSensorsState (const char * jsonString, bool* tempSetBool1, bool* tempSetBool2)  //SH
{
  Serial_Debug("\r\nIn ProcessSetState->");
  Serial_Debug(jsonString);
  eJsonStatus error_code = JSON_NO_ERROR;
  char *setStateStr[JSON_NO_OF_SENSOR_STATE_DATA];
  uint8_t maxNoStrings=(sizeof setStateStr)/4;
  uint8_t totalResultStringCount =  SplitString (jsonString, setStateStr, ',',maxNoStrings); 
  Serial_Debug("\nstate Values :");
  for(uint8_t dispcount = 0; dispcount < totalResultStringCount; dispcount++)
  {
    Serial_Debug(setStateStr[dispcount]);
    Serial_Debug(",");
  }
  if(totalResultStringCount == JSON_NO_OF_SENSOR_STATE_DATA)
  {
    bool status1 = true,status2 = true;
    status1 &= SetParameterValue_bool(setStateStr[0], tempSetBool1, IsStateValid);
    status2 &= SetParameterValue_bool(setStateStr[1], tempSetBool2, IsStateValid);
    if(status1 == false)
    {
      edgesense_error_code = JSON_DATA_OUT_OF_RANGE;
      Serial_Debug("\n Mode SetValue/s Out of Range");
    }
    else
    {
      edgesense_error_code = JSON_NO_ERROR;
      Serial_Debug("\n Mode SetValue");
    }   
    if(status2 == false)
    {
      rotatesense_error_code = JSON_DATA_OUT_OF_RANGE;
      Serial_Debug("\n Mode SetValue/s Out of Range");
    }
    else
    {
      rotatesense_error_code = JSON_NO_ERROR;
      Serial_Debug("\n Mode SetValue");
    }   
  }
  else
  {
    Serial_Debug("\n Mode SetValue/s Invalid");
    error_code = JSON_INVALID_DATA;
  }
}

static eJsonStatus ProcessSetMotorState (const char * jsonString, bool* tempSetBool1, bool* tempSetBool2)              // SH
{
  Serial_Debug("\r\nIn ProcessSetState->");
  Serial_Debug(jsonString);
  eJsonStatus error_code = JSON_NO_ERROR;
  char *setStateStr[JSON_NO_OF_MOTOR_MODE_STATE_DATA - 1];
  uint8_t maxNoStrings=(sizeof setStateStr)/4;
  uint8_t totalResultStringCount =  SplitString (jsonString, setStateStr, ',',maxNoStrings); 
  Serial_Debug("\nstate Values :");
  for(uint8_t dispcount = 0; dispcount < totalResultStringCount; dispcount++)
  {
    Serial_Debug(setStateStr[dispcount]);
    Serial_Debug(",");
  }
  if(totalResultStringCount == JSON_NO_OF_MOTOR_MODE_STATE_DATA - 1)
  {
    bool status1 = true, status2 = true;
    status1 &= SetParameterValue_bool(setStateStr[0], tempSetBool1, IsStateValid);
    status2 &= SetParameterValue_bool(setStateStr[1], tempSetBool2, IsStateValid);
    if(status1 == false)
    {
      motor_error_code = JSON_DATA_OUT_OF_RANGE;
      Serial_Debug("\n Mode SetValue/s Out of Range");
    }
    else
    {
      motor_error_code = JSON_NO_ERROR;
      Serial_Debug("\n Mode SetValue");
    }    
    if(status2 == false)
    {
      linear_error_code = JSON_DATA_OUT_OF_RANGE;
      Serial_Debug("\n Mode SetValue/s Out of Range");
    }
    else
    {
      linear_error_code = JSON_NO_ERROR;
      Serial_Debug("\n Mode SetValue");
    }
  }
  else
  {
    Serial_Debug("\n Mode SetValue/s Invalid");
    error_code = JSON_INVALID_DATA;
  }
}

static eJsonStatus  ProcessSetZigbeeConfig (const char * jsonString)
{
  Serial_Debug("\r\nIn ProcessSetZigbeeConfig->");
  Serial_Debug(jsonString);
  eJsonStatus error_code = JSON_NO_ERROR;
  char *zigbeeConfigStr[JSON_NO_OF_ZIGBEE_CONFIG_DATA];
  uint8_t maxNoStrings=(sizeof zigbeeConfigStr)/4;
  uint8_t totalResulStringCount =  SplitString (jsonString, zigbeeConfigStr, ',', maxNoStrings );
  Serial_Debug("\nZigbee Config Parameters Received Values :");
  for(uint8_t dispcount = 0; dispcount < totalResulStringCount; dispcount++)
  {
    Serial_Debug(zigbeeConfigStr[dispcount]);
    Serial_Debug(",");
  }
  if(totalResulStringCount == JSON_NO_OF_ZIGBEE_CONFIG_DATA)
  {
    bool status = true;
    stZigbeeConfig *setZigbeeConfig = GetSetZigbeeConfig();
    status &= CheckHexStrValidity(zigbeeConfigStr[0], (PAN_ID_STR_LEN-1));
    status &= CheckHexStrValidity(zigbeeConfigStr[1], (LINK_KEY_STR_LEN-1));
    status &= CheckHexStrValidity(zigbeeConfigStr[2], (NETWORK_OPTIONS_STR_LEN-1));
    status &= ((zigbeeConfigStr[3][0] == NULL)||
               ((zigbeeConfigStr[3][0] == '0')||(zigbeeConfigStr[3][0] == '1')&&(zigbeeConfigStr[3][1] == NULL)));
    status &= ((zigbeeConfigStr[4][0] == NULL)||
               ((zigbeeConfigStr[4][0] == '0')||(zigbeeConfigStr[4][0] == '1')&&(zigbeeConfigStr[4][1] == NULL)));
    status &= ((zigbeeConfigStr[5][0] == NULL)||
               ((zigbeeConfigStr[5][0] == '0')||(zigbeeConfigStr[5][0] == '1')&&(zigbeeConfigStr[5][1] == NULL)));
    if(status == true)
    {
      snprintf((char *)setZigbeeConfig->panID, PAN_ID_STR_LEN, zigbeeConfigStr[0]);
      snprintf((char *)setZigbeeConfig->encryptionLinkKey, LINK_KEY_STR_LEN, zigbeeConfigStr[1]);
      snprintf((char *)setZigbeeConfig->encryptionOptions, NETWORK_OPTIONS_STR_LEN, zigbeeConfigStr[2]);
      setZigbeeConfig->encryptionEnable = zigbeeConfigStr[3][0];
      setZigbeeConfig->joinVerifyEnable = zigbeeConfigStr[4][0];
      setZigbeeConfig->writeEnable = zigbeeConfigStr[5][0];
      UpdateZigbeeConfigChangeFlag(true);
      Serial_Debug("\nZigbee Config  Set");
      error_code = JSON_NO_ERROR;
    }
    else
    {
      Serial_Debug("\nZigbee Config SetValue/s: Out of Range");
      error_code = JSON_DATA_OUT_OF_RANGE;   
    } 
  }
  else
  {
    Serial_Debug("\nZigbee Config SetValue/s : Invalid Data");
    error_code = JSON_INVALID_DATA;
  }
  return error_code; 
}

static eJsonStatus ProcessResetZigbeeNetwork (const char * jsonString)
{
  Serial_Debug("\r\nIn ProcessResetZigbeeNW->");
  Serial_Debug(jsonString);
  eJsonStatus error_code = JSON_NO_ERROR;
  char *zigbeeConfigStr[JSON_NO_OF_ZIGBEE_NW_RESET_DATA];
  uint8_t maxNoStrings=(sizeof zigbeeConfigStr)/4;
  uint8_t totalResulStringCount =  SplitString (jsonString, zigbeeConfigStr, ',', maxNoStrings );
  Serial_Debug("\nZigbee Nw Reset Parameters Received Values :");
  for(uint8_t dispcount = 0; dispcount < totalResulStringCount; dispcount++)
  {
    Serial_Debug(zigbeeConfigStr[dispcount]);
    Serial_Debug(",");
  }
  if(totalResulStringCount == JSON_NO_OF_ZIGBEE_NW_RESET_DATA)
  {
    bool status = ((zigbeeConfigStr[0][0] == NULL)||
                   ((zigbeeConfigStr[0][0] == '0')||(zigbeeConfigStr[0][0] == '1')&&(zigbeeConfigStr[0][1] == NULL)));
    if(status == true)
    {
      if(zigbeeConfigStr[0][0] == NULL)
      {
        UpdateZigbeeNetworkResetFlag(NW_RESET_IDLE);
      }
      else
      {
        UpdateZigbeeNetworkResetFlag((eZigNwReset)(zigbeeConfigStr[0][0] - '0'));         
      }
      Serial_Debug("\nZigbee  Nw Reset  Set");
      error_code = JSON_NO_ERROR;
    }
    else
    {
      Serial_Debug("\nZigbee  Nw Reset SetValue/s: Out of Range");
      error_code = JSON_DATA_OUT_OF_RANGE;   
    } 
  }
  else
  {
    Serial_Debug("\nZigbee  Nw Reset SetValue/s : Invalid Data");
    error_code = JSON_INVALID_DATA;
  }
  return error_code; 
}

static eJsonStatus ProcessSetMotorFaultConditions (const char * jsonString)
{
  Serial_Debug("\r\nIn ProcessSetMotor fault conditions->");
  Serial_Debug(jsonString); 
  eJsonStatus error_code = JSON_NO_ERROR;
  stMaxIloadConfigValues* setMaxIloadConfigValues;
  setMaxIloadConfigValues = GetSetMaxIloadConfigValues();
  stMaxIloadConfigValues tempSetMaxIloadConfigValues = *setMaxIloadConfigValues;
  char *MotorFaultConditionsStr[JSON_NO_OF_MOTOR_FAULT_CONDITIONS];
  uint8_t maxNoStrings=(sizeof MotorFaultConditionsStr)/4;
  uint8_t totalResultStringCount =  SplitString (jsonString, MotorFaultConditionsStr, ',',maxNoStrings);
  Serial_Debug("\nMotor fault conditions Received Values :");
  for(uint8_t dispcount = 0; dispcount < totalResultStringCount; dispcount++)
  {
    Serial_Debug(MotorFaultConditionsStr[dispcount]);
    Serial_Debug(",");
  }  
  if(totalResultStringCount == JSON_NO_OF_MOTOR_FAULT_CONDITIONS)
  {
    bool status = true;
    status &= SetParameterValue_int(MotorFaultConditionsStr[0], &(tempSetMaxIloadConfigValues.maxIloadNoiseTimeValue), IsIloadMaxConfigTimeValid);
    status &= SetParameterValue_int(MotorFaultConditionsStr[1], &(tempSetMaxIloadConfigValues.maxIloadFreqTimeValue) , IsIloadMaxConfigTimeValid);
    status &= SetParameterValue_int(MotorFaultConditionsStr[2], &(tempSetMaxIloadConfigValues.maxIloadRepeatCountValue), IsIloadMaxConfigTimeValid);
    status &= SetParameterValue_int(MotorFaultConditionsStr[3], &(tempSetMaxIloadConfigValues.motorPauseDelay) , IsIloadMaxConfigTimeValid);
    
    if(status == false)
    {
      error_code = JSON_DATA_OUT_OF_RANGE;
      Serial_Debug("\n Motor fault conditions SetValue/s Out of Range");
    }
    else
    {
      error_code = JSON_NO_ERROR;
      Serial_Debug("\n Motor fault conditions SetValue/s set : ");
      *setMaxIloadConfigValues = tempSetMaxIloadConfigValues;
      Serial_Debug_Num(setMaxIloadConfigValues->maxIloadNoiseTimeValue);
      Serial_Debug(",");
      Serial_Debug_Num(setMaxIloadConfigValues->maxIloadFreqTimeValue);
      Serial_Debug(",");
      Serial_Debug_Num(setMaxIloadConfigValues->maxIloadRepeatCountValue);
      Serial_Debug(",");
      Serial_Debug_Num(setMaxIloadConfigValues->motorPauseDelay);
    }            
  }
  else
  {
    Serial_Debug("\n Motor fault conditions SetValue/s Invalid");
    error_code = JSON_INVALID_DATA;
  }
  return error_code;
}


static eJsonStatus ProcessGetMotorFaultConditions (const char * jsonString)
{
  
  eJsonStatus error_code = JSON_NO_ERROR;
  uint16_t dataCount=0;
  txBuff[dataCount]=0;
  uint16_t bufferLength = sizeof(txBuff)-dataCount;
  ParseHeaderData(&txBuff[dataCount],&bufferLength,CMD_GET_PULSE_COUNT_VALUES);
  dataCount = dataCount+bufferLength;    
  bufferLength = sizeof(txBuff)-dataCount;
  stMaxIloadConfigValues* getMaxIloadConfigValues = GetSetMaxIloadConfigValues();
  uint8_t tempCount = snprintf(&txBuff[dataCount],bufferLength,"%d,%d,%d,%d",getMaxIloadConfigValues->maxIloadNoiseTimeValue,getMaxIloadConfigValues->maxIloadFreqTimeValue,getMaxIloadConfigValues->maxIloadRepeatCountValue,getMaxIloadConfigValues->motorPauseDelay);
  dataCount = dataCount+tempCount; 
  txBuff[dataCount] = STOP_CHAR;
  dataCount++;
  Serial_Debug("\r\ndataCount->");
  Serial_Debug_Num(dataCount); 
  Serial_Debug("\r\nData->");
  Serial_Debug_Bytes(txBuff,dataCount);
  Serial_Debug("\r\nEnd");
  UartTransmit(txBuff,dataCount);
  ClearTxBuff();
  return error_code;
}

static eJsonStatus RequestActivityLog (const char * jsonString)
{
  Serial_Debug(jsonString);
  eJsonStatus error_code = JSON_NO_ERROR;
  uint32_t startIndex = 0, endIndex = 0;
  //char value[MAX_JASON_VALUE_LENGTH+1];
  //if(Parse_Json(jsonString, KEY_TYPE_VALUES, value,(sizeof(value)/sizeof(value[0]))-1) == 0)
  //{
  char *reqLogStr[JSON_NO_OF_REQUEST_LOG_VALUES];
  uint8_t maxNoStrings=(sizeof reqLogStr)/4;
  uint8_t totalResulStringCount =  SplitString (jsonString, reqLogStr, ',', maxNoStrings );
  Serial_Debug("\nRequest Log Received Values :");
  for(uint8_t dispcount = 0; dispcount < totalResulStringCount; dispcount++)
  {
    Serial_Debug(reqLogStr[dispcount]);
    Serial_Debug(",");
  }
  if(totalResulStringCount == JSON_NO_OF_REQUEST_LOG_VALUES)
  {
    if((reqLogStr[0][0] != NULL) && (reqLogStr[1][0] != NULL))
    {
      startIndex = strtol(reqLogStr[0], NULL, 10);
      endIndex = strtol(reqLogStr[1], NULL, 10);
      if((startIndex <= endIndex) && endIndex <= MAX_NO_OF_STORE_LOG_DATA && startIndex > 0)
      {
        char dispstring[50];
        snprintf (dispstring, sizeof dispstring, "\nStartIndex = %d, EndIndex = %d", startIndex, endIndex);
        Serial_Debug(dispstring);
        error_code = JSON_NO_ERROR;
      }
      else
      {
        Serial_Debug("\nRequest Logs Value/s: Out of Range");
        error_code = JSON_DATA_OUT_OF_RANGE;
      }
    }
    else
    {
      Serial_Debug("\nRequest Logs Value/s : Invalid Data");
      error_code = JSON_INVALID_DATA;
    }
  }
  else
  {
    Serial_Debug("\nRequest Logs Value/s : Invalid Data");
    error_code = JSON_INVALID_DATA;
  }
  //  }
  //  else
  //  {
  //    Serial_Debug("\nRequest Logs Value/s : Parse Error");
  //    error_code = JSON_PARSE_ERROR;
  //  }
  if(error_code == JSON_NO_ERROR)
  {
    
    
    char values[MAX_NO_OF_EVENT_LOGS][LOG_STR_LEN+1+1];
    uint8_t logIndex = 0;
    //  uint16_t logArrayStartIndex= 0;
    uint8_t logStoreData[MAX_NO_OF_EVENT_LOGS][SINGLE_STORE_BYTE_COUNT];
    uint32_t noOfReadLogs = ReadFromLogFlash(&logStoreData[0][0], MAX_NO_OF_EVENT_LOGS, startIndex, endIndex);
    Serial_Debug("\r\nIn API Processing->");
    for(logIndex = 0; logIndex < noOfReadLogs && logIndex < MAX_NO_OF_EVENT_LOGS; logIndex++)
    {
      // logArrayStartIndex = logIndex * SINGLE_STORE_BYTE_COUNT;
      uint32_t utcTime =  ((uint32_t)logStoreData[logIndex][0] << 24)  | ((uint32_t)logStoreData[logIndex][1] << 16) 
        | ((uint32_t)logStoreData[logIndex][2] << 8) | logStoreData[logIndex][3];
      uint16_t eventValue = (logStoreData[logIndex][5]<<8)|logStoreData[logIndex][6];
      if(logIndex == 0)
      {
        snprintf(&values[logIndex][0],(LOG_STR_LEN+1+1),"[%ld,%d,%d]",utcTime,logStoreData[logIndex][4], (logStoreData[logIndex][5]<<8)|logStoreData[logIndex][6]);
      }
      else
      {
        snprintf(&values[logIndex][0],(LOG_STR_LEN+1),"[%ld,%d,%d]",utcTime,logStoreData[logIndex][4],eventValue );
      }
      //      Serial_Debug(values[logIndex]);
      //      Serial_Debug(" ,");
    }
    
    ////    
    ////    //uint8_t dataCount_ref = dataCount;
    ////    while(noOfReadLogs)
    ////    {
    ////    uint16_t dataCount=0;
    ////    txBuff[dataCount]=0;
    ////    uint16_t bufferLength = sizeof(txBuff)-dataCount;
    ////    bool status = ParseHeaderData(&txBuff[dataCount], &bufferLength, CMD_REQ_ACTIVITY_LOG);
    ////    dataCount = dataCount+bufferLength;
    ////    bufferLength = sizeof(txBuff)-dataCount;
    ////    //dataCount = dataCount_ref;
    ////    uint8_t tempCount = 0;
    ////    tempCount = snprintf(&txBuff[dataCount],bufferLength,"%s",values[noOfReadLogs-1]);
    ////    dataCount = dataCount+tempCount; 
    ////    txBuff[dataCount] = STOP_CHAR;
    ////    dataCount++;
    ////    Serial_Debug("\r\ndataCount->");
    ////    Serial_Debug_Num(dataCount); 
    ////    Serial_Debug("\r\nData->");
    ////    Serial_Debug_Bytes(txBuff,dataCount);
    ////    //Serial_Debug("\r\nEnd");
    ////    UartTransmit(txBuff,dataCount);    
    ////    --noOfReadLogs;
    ////    }
    uint16_t dataCount=0;
    txBuff[dataCount]=0;
    uint16_t bufferLength = sizeof(txBuff)-dataCount;
    if(GetUartType()==CONFIG_UART)
    {
      bool status = ParseHeaderDataJson(&txBuff[dataCount], &bufferLength, CMD_REQ_ACTIVITY_LOG,GetZigbeeMacAddress());
      dataCount = dataCount+bufferLength;
      bufferLength = sizeof(txBuff)-dataCount;
      txBuff[dataCount]=0;
      Serial_Debug(txBuff);
      UartTransmitType(CONFIG_UART,txBuff,dataCount-1);
      uint16_t sentLogCount = 0;
      Serial_Debug(",\"VALUES\":\"[");
      UartTransmitType(CONFIG_UART,",\"VALUES\":\"[",strlen(",\"VALUES\":\"["));
      while(sentLogCount<noOfReadLogs)
      {
        Serial_Debug(values[sentLogCount]);
        UartTransmitType(CONFIG_UART,values[sentLogCount],strlen(values[sentLogCount]));
        if((noOfReadLogs-sentLogCount)>1)
        {
        UartTransmitType(CONFIG_UART,",",1);
        Serial_Debug(",");
        }
        sentLogCount++;
      }
      
      ClearTxBuff();
      txBuff[0]=']';
      txBuff[1]='"';
      txBuff[2]='}';
      txBuff[3]=0;
      Serial_Debug(txBuff);
      UartTransmitType(CONFIG_UART,txBuff,3);
    }
    else
    {
      bool status = ParseHeaderData(&txBuff[dataCount], &bufferLength, CMD_REQ_ACTIVITY_LOG);
      dataCount = dataCount+bufferLength;
      bufferLength = sizeof(txBuff)-dataCount;
      UartTransmitType(ZIGBEE_UART,txBuff,dataCount);
      txBuff[dataCount]=0;
      Serial_Debug(txBuff);
      uint16_t sentLogCount = 0;
      while(sentLogCount<noOfReadLogs)
      {
        Serial_Debug(values[sentLogCount]);
        UartTransmitType(ZIGBEE_UART,values[sentLogCount],strlen(values[sentLogCount]));
        if((noOfReadLogs-sentLogCount)>1)
        {
        UartTransmitType(ZIGBEE_UART,",",1);
        Serial_Debug(",");
        }
        sentLogCount++;
      }
      
      ClearTxBuff();
      txBuff[0]=']';
      txBuff[1]=STOP_CHAR;
      txBuff[2]=0;
      
        UartTransmitType(ZIGBEE_UART,txBuff,2);
      Serial_Debug(txBuff);
    }
    
  }
  ClearTxBuff();
  return error_code;
}

static eJsonStatus ClearActivityLog (const char * jsonString)
{
  Serial_Debug(jsonString);
  ClearAllLogData();
  return JSON_NO_ERROR;
}
eJsonStatus ProcessReceivedJsonData (uint8_t * jsonReceivedData,uint16_t size)
{
  eJsonStatus error_code = JSON_NO_ERROR;
  
  ////  const char * Json_String;
  ////  JsonFormatKeys JsonKeys;
  ////  JsonFormatValues JsonValues;
  ////  char JsonValues_Multi[MAX_JSON_VALUES_ONE_TIME][MAX_JSON_VALUES_ONE_TIME_LENGTH+1];
  ////  JsonValues.Value = &JsonValues_Multi;
  ////  JsonValues.Max_Value_Length = MAX_JSON_VALUES_ONE_TIME_LENGTH;
  ////  Json_String = (const char *)jsonReceivedData;
  //error_code = ParseRxdata(jsonReceivedData);
  eJsonStatus parseErrorCode = error_code;
  //uint16_t command = 0;
  stMessage message;
  error_code = ExtractData(jsonReceivedData,size,&message);
  if(error_code == JSON_NO_ERROR)
  {
    error_code = ParseRxdata(&message);
  }
  parseErrorCode = error_code;
  if((error_code == JSON_NO_ERROR) || (error_code == JSON_WILDCARD_DEV_ID))
  {
    Serial_Debug((char const *)"\nCMD Value: ");
    Serial_Debug_Num(message.CMD); 
    error_code = ProcessJsonCommand(message.values, message.CMD);//(*JsonValues.Value)[SNO_KEY_TYPE_CMD]);
    if(error_code != JSON_NO_ERROR)
    {
      Error_Handler();
    }
  }
  else
  {
    Error_Handler();
  }
  if((parseErrorCode != JSON_WILDCARD_DEV_ID) && (parseErrorCode != JSON_INVALID_DEV_ID))
  {
    char * AckBuffer = GetAcknowledgementData(error_code);
    Serial_Debug(AckBuffer);
    
    UartTransmit(AckBuffer,strlen(AckBuffer));
  }
  return error_code;
}


static eJsonStatus ProcessJsonCommand (const uint8_t * jsonString, uint16_t presentCommand_Hex) 
{
  eJsonStatus jsonStatus;
  jsonStatus = AssignJsonCommand (presentCommand_Hex); 
  if(presentJsonCommandParams != NULL)
  {
    jsonStatus = presentJsonCommandParams->executeCommand(jsonString);
    if(jsonStatus == JSON_NO_ERROR)
    {
      eEepromStatus eepromStoreStatus = presentJsonCommandParams->executeStoreProcess(EEPROM_WRITE);
      if(eepromStoreStatus != EEPROM_OK)
      {
        jsonStatus = JSON_EEPROM_ERROR;
        Serial_Debug("\nEeprom Error");
      }
      else
      {
        //Serial_Debug("\nEeprom Stored");
      }
    }
  }
  
  return jsonStatus;
}

static eJsonStatus AssignJsonCommand (uint16_t presentCommand_Hex) 
{
  uint16_t commandParamsCount = 0;
  uint16_t commandParamsTotalCount = sizeof(jsonCommandParams)/sizeof(jsonCommandParams[0]);
  for(commandParamsCount =0; commandParamsCount < commandParamsTotalCount; commandParamsCount++)
  {
    if(jsonCommandParams[commandParamsCount].command_Hex == presentCommand_Hex)
    {
      presentJsonCommandParams = &jsonCommandParams[commandParamsCount];
      break;
    }
  }
  if(commandParamsCount >= commandParamsTotalCount)
  {
    presentJsonCommandParams = NULL;
    return JSON_INVALID_CMD_VALUE;
  }
  else
  {
    return JSON_NO_ERROR;
  }
}

uint16_t GetCommandProcessingParam (stJsonCommand **jsonCmdParam)
{
  *jsonCmdParam = &jsonCommandParams[0];
  uint16_t commandParamsTotalCount = sizeof(jsonCommandParams)/sizeof(jsonCommandParams[0]);
  return(commandParamsTotalCount);
}

static eJsonStatus ParseRxdata(stMessage* message)
{
  eJsonStatus error_code = JSON_NO_ERROR;
  ////  JsonKeys->Key[SNO_KEY_TYPE_TIME_STAMP] = (char*)KEY_TYPE_TIME_STAMP;              
  ////  JsonKeys->Key[SNO_KEY_TYPE_ID_NO]      = (char*)KEY_TYPE_ID_NO;                  
  ////  JsonKeys->Key[SNO_KEY_TYPE_CMD]        = (char*)KEY_TYPE_CMD;   
  ////  JsonKeys->No_of_Keys = SNO_KEY_TYPE_CMD+1;                                  // Assuming this as the MAXimum enum value used in this assignment
  ////  JsonValues->No_of_Values = JsonKeys->No_of_Keys; 
  ////  if(Parse_Json_Multi(Json_String, JsonKeys, JsonValues) == 0)
  ////  {
  ////    stDevInfo * devInfo = GetSetDeviceIDInfo();
  Serial_Debug("\r\nDevice ID-->");
  Serial_Debug_Num(message->deviceID);
  if(message->deviceID == WILDCARD_DEVICE_ID)
  {
    Serial_Debug("\n Wild Card Device ID");
    error_code = JSON_WILDCARD_DEV_ID;
  }
  else if(message->deviceID == DEVICE_ID)
  {
    error_code = JSON_NO_ERROR;
  }
  else 
  {
    //Serial_Debug("\n Invalid Device ID");
    // error_code = JSON_INVALID_DEV_ID; 
    error_code = JSON_NO_ERROR;
  }
  ////  }
  ////  else
  ////  {
  ////    error_code = JSON_PARSE_ERROR;
  ////  }  
  return error_code; 
}


//void SetDefaultNil(void)
//{
//  
//}

static void Error_Handler(void)
{
  /* Do Nothing */
}

//void ExtractData(uint8_t* sourceString, uint8_t* destString, uint8_t delimiter1, uint8_t delimiter2)
//{
//uint16_t startAddress,endAddress;
//}

eJsonStatus ExtractCommand(uint8_t* sourceBuffer,uint16_t size, uint16_t* command)
{
  uint8_t tempBuffer[MAX_COMMAND_SIZE+1];
  int i,j = 0;
  for(i=0;sourceBuffer[i]!=DELIMITER_1;i++)
  {
    if(i>=size)
    {
      return JSON_INVALID_CMD_VALUE;
    }
  }
  i++;
  for(j=0;(j<MAX_COMMAND_SIZE)&&(i<=size);i++,j++)
  {
    tempBuffer[j] = sourceBuffer[i];  
  }
  if(sourceBuffer[i]!=DELIMITER_2)
  {
    return JSON_INVALID_CMD_VALUE;
  }
  tempBuffer[j] = 0;
  Serial_Debug(tempBuffer);
  *command = strtol(tempBuffer,NULL,16);
  return JSON_NO_ERROR;
}
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
